sergei-nntu/ora/ora-7/Images/Assembled.jpg

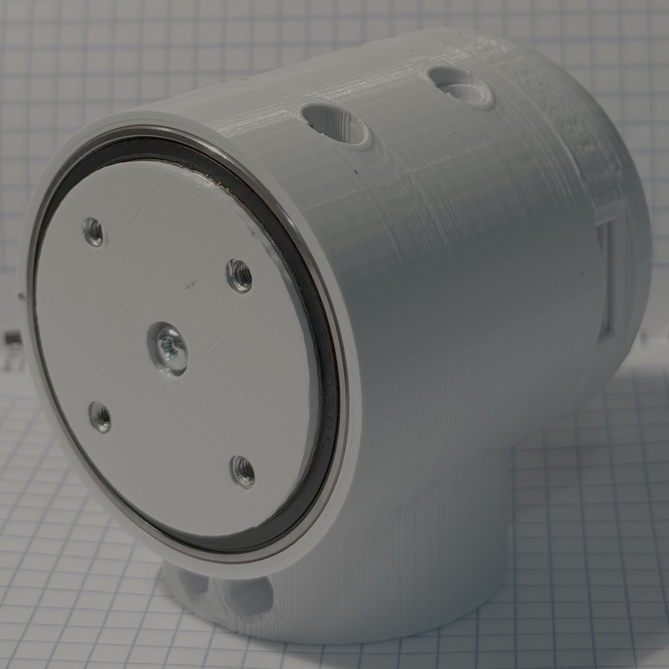
ora-7/Images/Assembled.jpg
