sergei-nntu/ora/ora-8/images/ORA-8 Image Clean.png

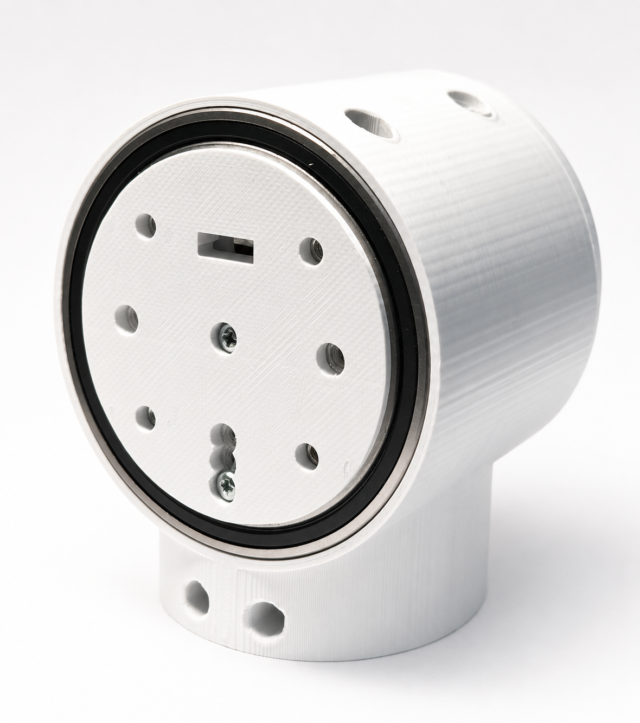
ora-8/images/ORA-8 Image Clean.png
