sergei-nntu/ora/ora-3/ORA-3.png

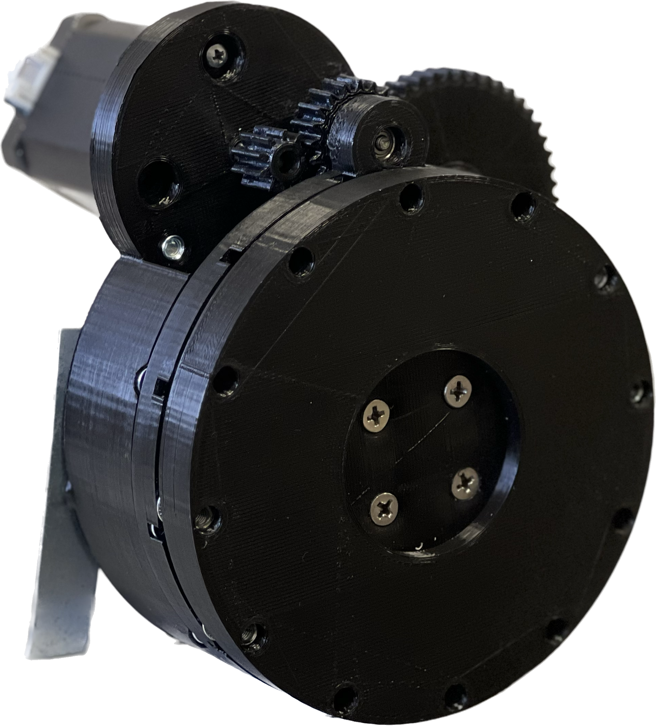
ora-3/ORA-3.png
