sergei-nntu/ora/ora-8/schematics/ORA-8_bb.png

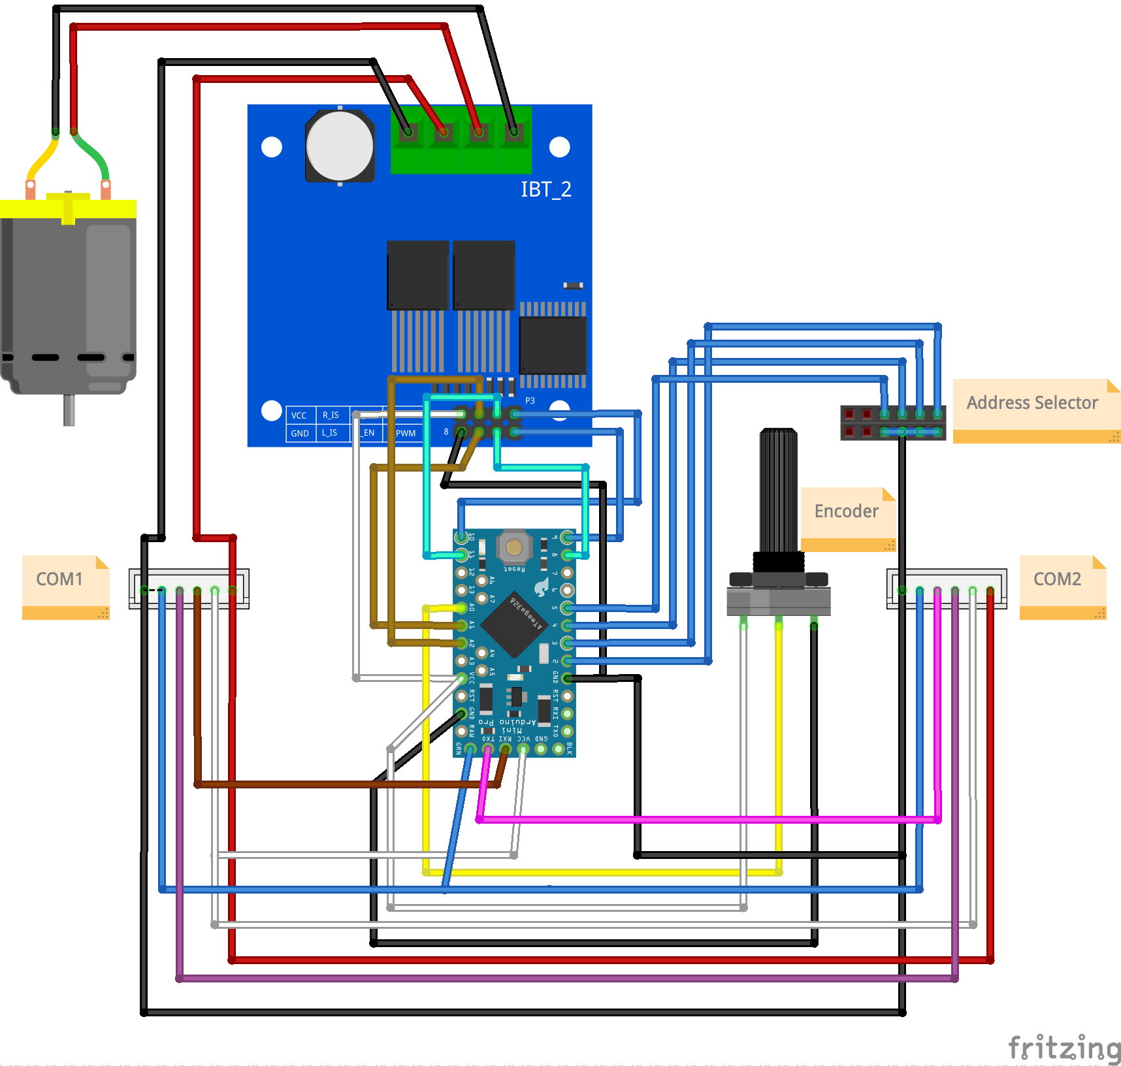
ora-8/schematics/ORA-8_bb.png
