sergei-nntu/ora/ora-10/ora-10_JST.FCStd

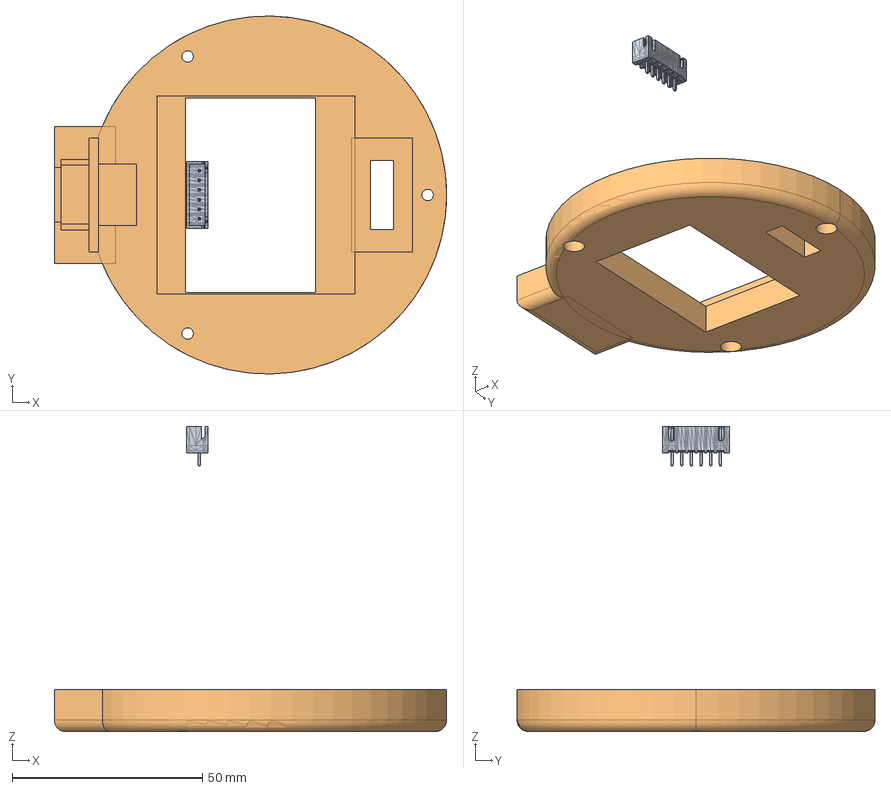
[picture p5: CAD file, 2026-02-09]
ora-10/ora-10_JST.FCStd
103.0 x 94.0 x 80.1 mm
JST XH 6_rot
ORA-8 Lid With BT7960
