sergei-nntu/ora/ora-2/ora-2.FCStd

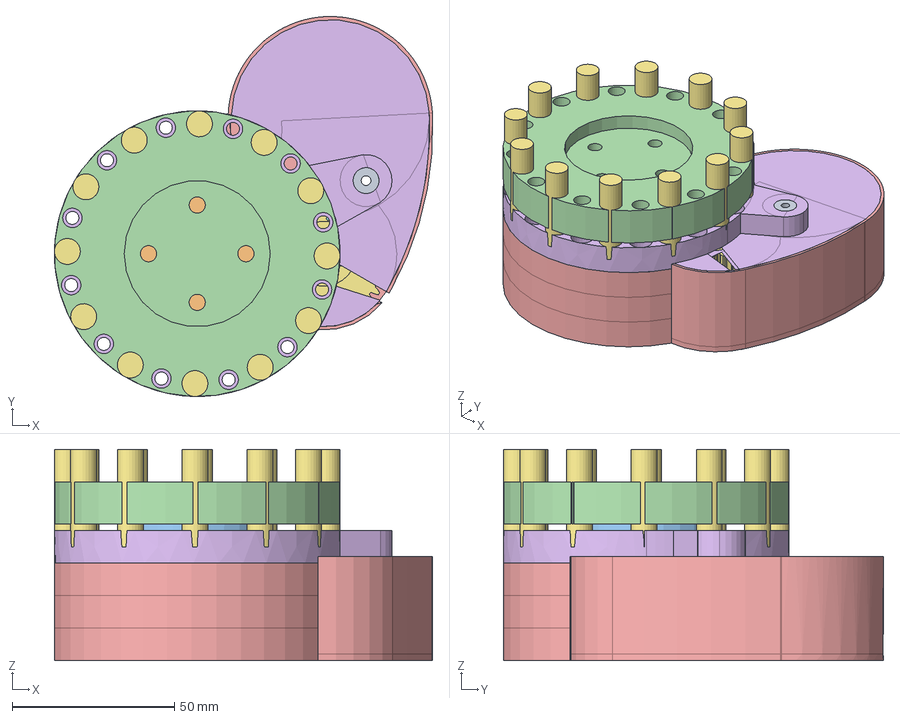
[picture p6: CAD file, 2026-08-20]
ora-2/ora-2.FCStd
116.5 x 117.0 x 65.0 mm
Bearing MR83ZZ 1:2 GEAR TOP
SmallGear Anti Tension
Bearing MR83ZZ MediumGearBottom
Bearing MR83ZZ MediumGearTop
Bearing 6002
Bearing 6809
MediumGear
ORA-2 32:12 GEAR
Bearing MR83ZZ 1:2 GEAR BOTTOM
MainGear Anti-Backlash
MainShaft Anti-Backlash
Flange_Antibacklash
ORA-2 Body. With Gears Protection
ORA-2 Cover. With Gears Protection
ORA-2 COVER MNT HOLES001
