sergei-nntu/ora/ora-3/ora-3ST.FCStd

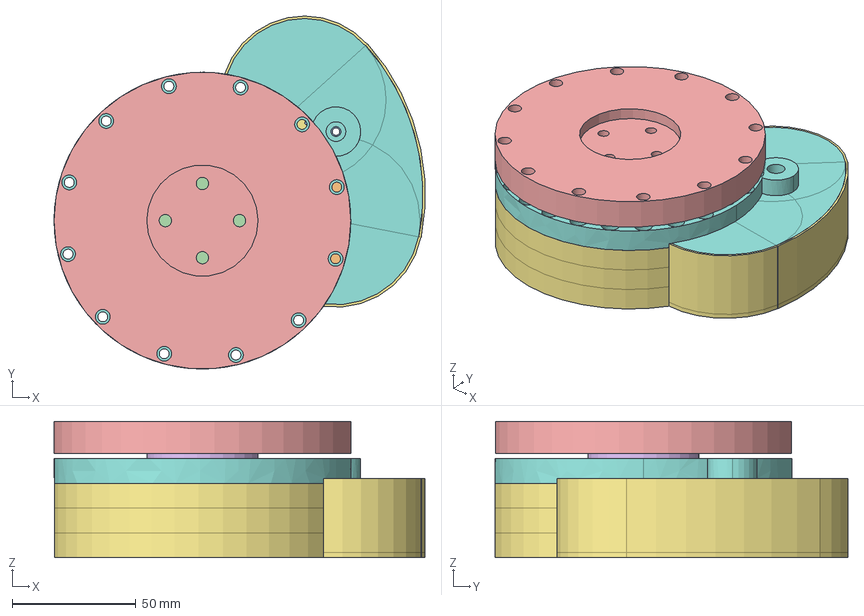
[picture p7: CAD file, 2026-08-20]
ora-3/ora-3ST.FCStd
150.0 x 142.7 x 55.0 mm
SmallGear Anti Tension
MediumGear
MediumGear_Small002
MainGear_AntiBaclkash
Flange AntiBacklash
MainShaft_AntiBacklash
ORA-3 Body. With Gears Protection
ORA-3 Cover. With Gears Protection
