sergei-nntu/ora/ora-6/ora-3ST.FCStd

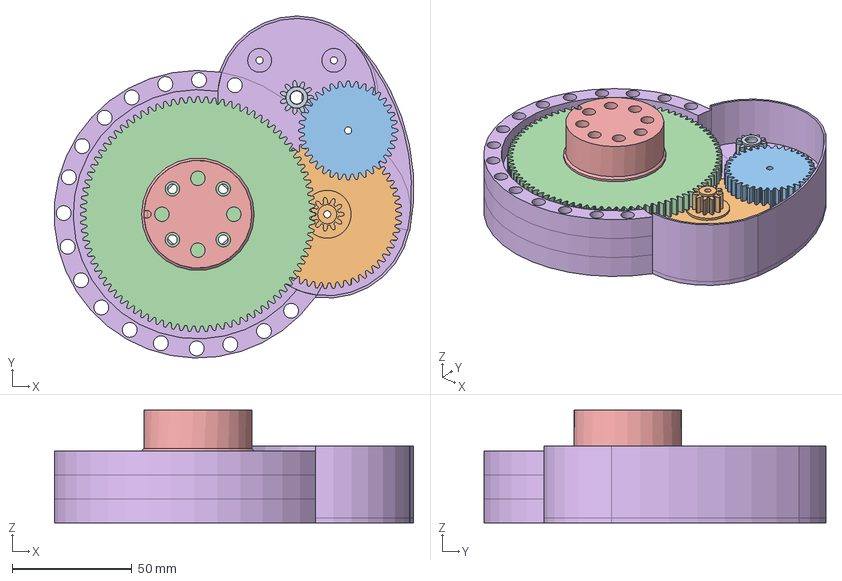
[picture p9: CAD file, 2026-01-14]
ora-6/ora-3ST.FCStd
149.8 x 142.7 x 47.0 mm
SmallGear Anti Tension
MediumGear
MediumGear_Small002
MainGear_AntiBaclkash
MainShaft_AntiBacklash
ORA-6 Body. With Gears Protection
