sergei-nntu/ora/ora-7/14_5_4.3mf

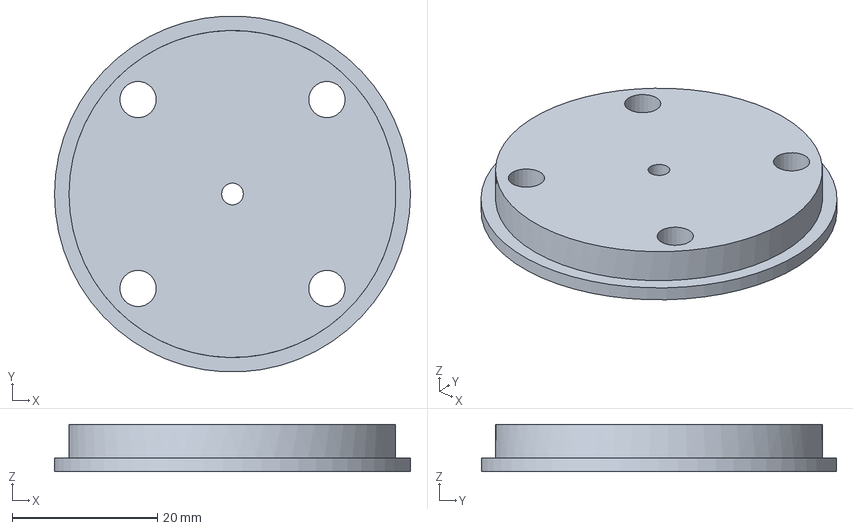
[picture p10: CAD file, 2026-08-20]
ora-7/14_5_4.3mf
49.0 x 48.9 x 6.50 mm
