sergei-nntu/ora/ora-8/15_5_3.3mf

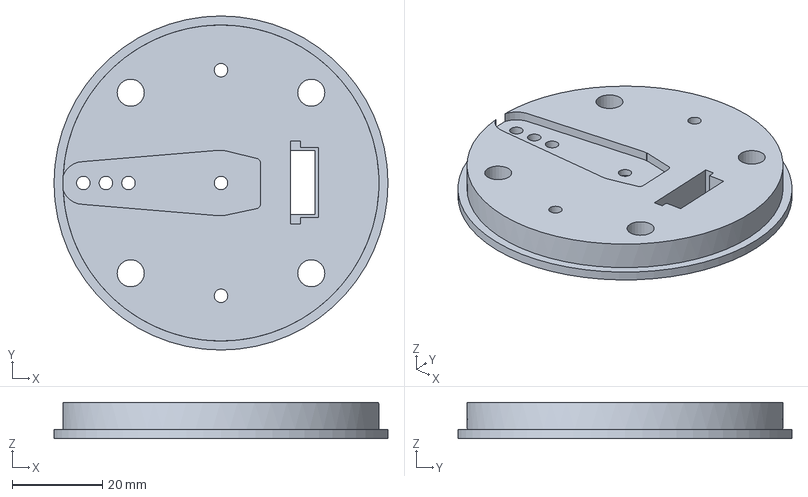
[picture p11: CAD file, 2026-08-20]
ora-8/15_5_3.3mf
74.0 x 74.0 x 8.00 mm
