sergei-nntu/ora/ora-9/17_4_1.stl

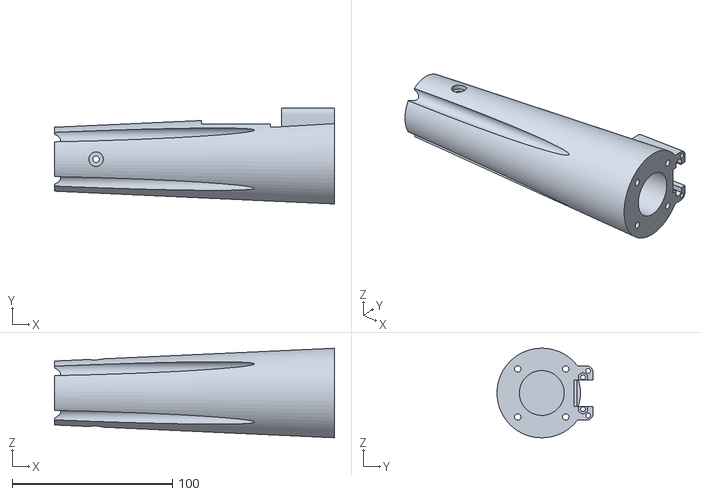
[picture p12: CAD file, 2026-01-14]
ora-9/17_4_1.stl
175.0 x 60.0 x 56.0
