sergei-nntu/ora/ora-2/10_2_2.stl

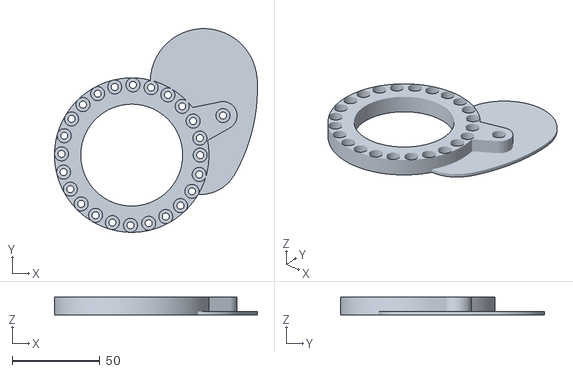
[picture p13: CAD file, 2026-01-14]
ora-2/10_2_2.stl
115.6 x 116.0 x 10.0
