sergei-nntu/ora/ora-3/8_4_4.stl

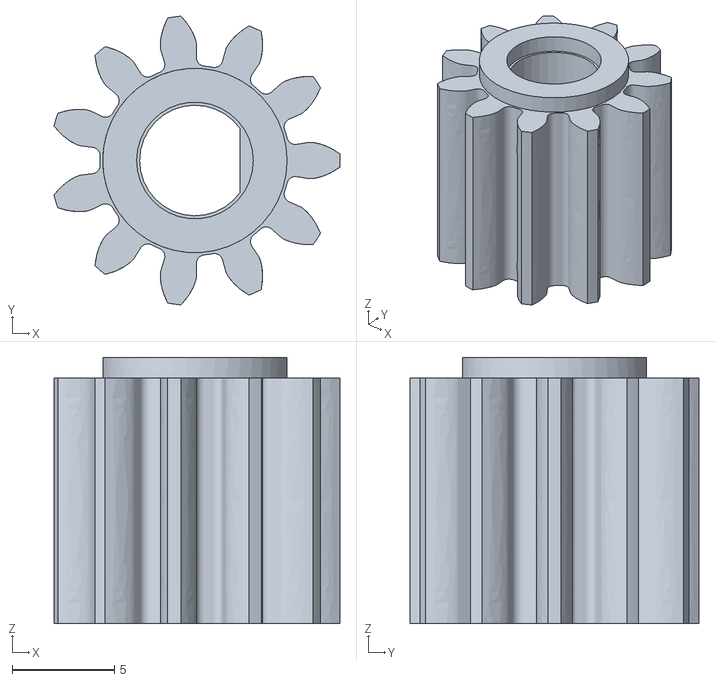
[picture p14: CAD file, 2026-01-14]
ora-3/8_4_4.stl
14.0 x 14.1 x 13.0
