sergei-nntu/ora/ora-4/12_5_1.stl

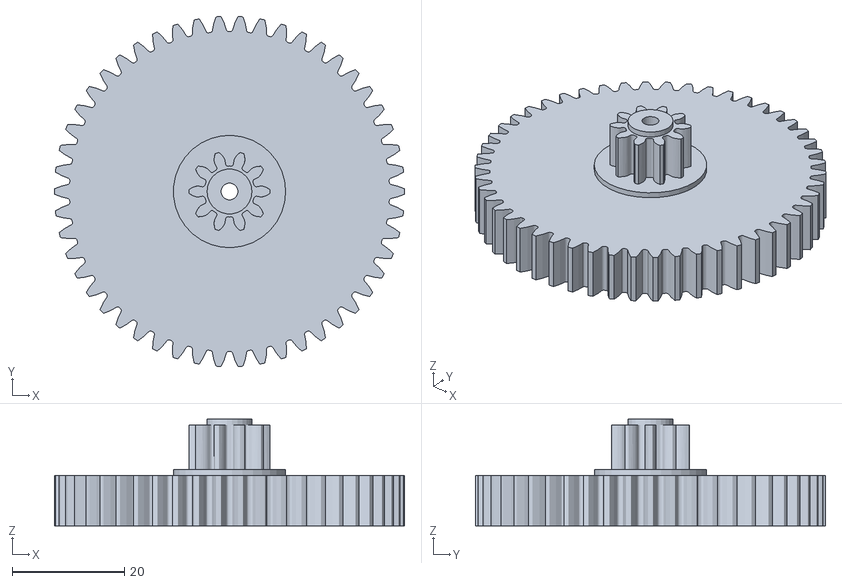
[picture p15: CAD file, 2026-01-14]
ora-4/12_5_1.stl
62.4 x 62.3 x 19.0
