sergei-nntu/ora/ora-7/14_4_11.3mf

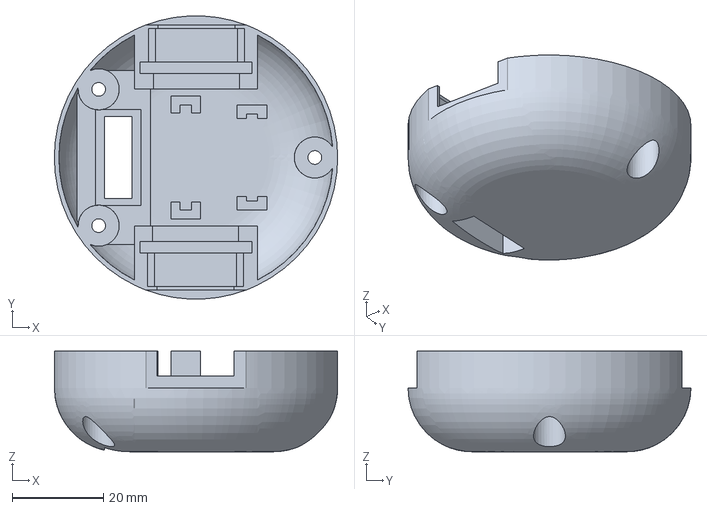
[picture p17: CAD file, 2026-08-20]
ora-7/14_4_11.3mf
62.0 x 61.9 x 22.0 mm
