sergei-nntu/ora/ora-8/15_1_9.3mf

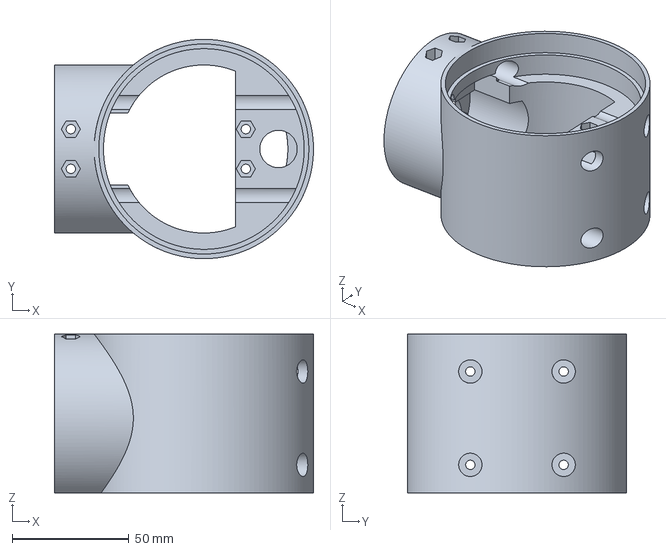
[picture p18: CAD file, 2026-08-20]
ora-8/15_1_9.3mf
111.0 x 94.0 x 68.0 mm
