sergei-nntu/ora/ora-9/17_1_6.stl

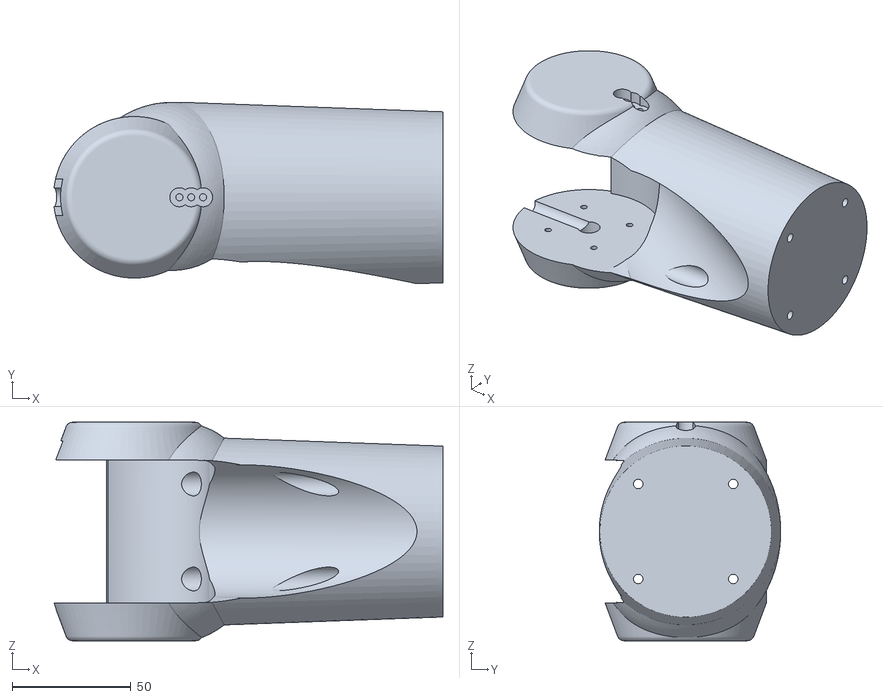
[picture p19: CAD file, 2026-01-14]
ora-9/17_1_6.stl
163.8 x 76.4 x 92.0
