sergei-nntu/ora/ora-2/10_1_3.stl

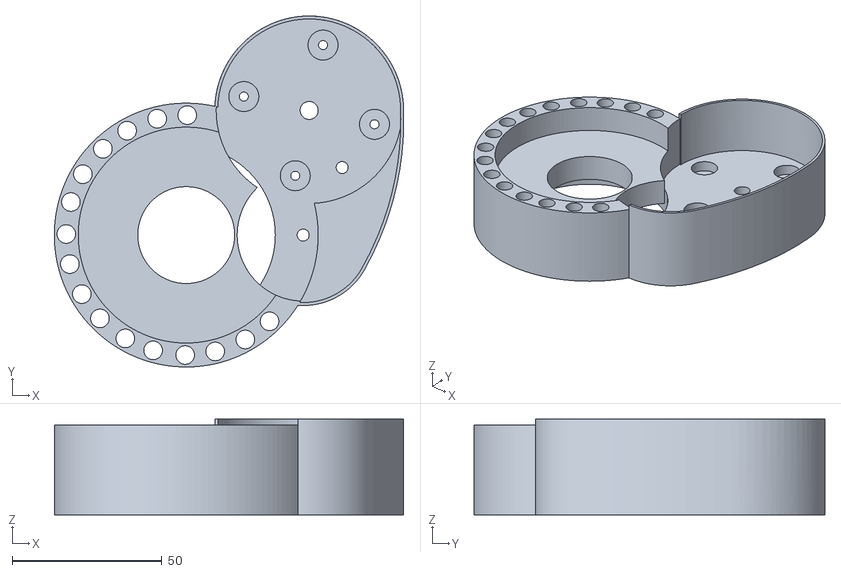
[picture p20: CAD file, 2026-01-14]
ora-2/10_1_3.stl
116.5 x 117.1 x 32.0
