sergei-nntu/ora/ora-3/8_10_1.stl

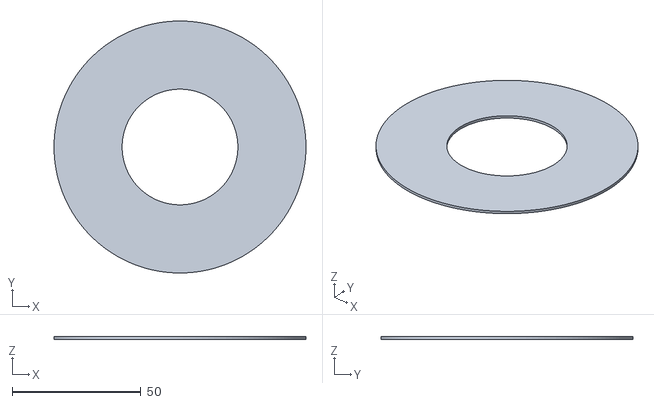
[picture p21: CAD file, 2026-01-14]
ora-3/8_10_1.stl
98.0 x 98.0 x 1.00
