sergei-nntu/ora/ora-4/ora-3ST.FCStd

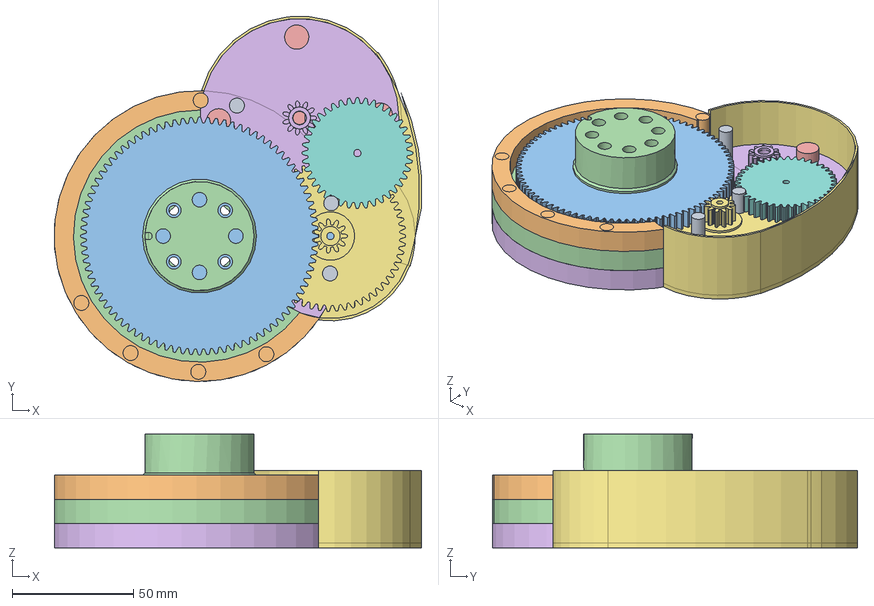
[picture p22: CAD file, 2026-01-14]
ora-4/ora-3ST.FCStd
151.6 x 150.6 x 47.0 mm
ORA-4 Mounting Holes
ORA-4 UpperBody
MiddleGearMountingHole
ORA-4 MiddleBody
MR83ZZ Mounting
SmallGear Anti Tension
MediumGear
MediumGear_Small002
ORA-4MR83ZZ Bearing Mount Small Gear
ORA-4 Body Extra Mounting Holes
MainGear_AntiBaclkash
MainShaft_AntiBacklash
Nema23 Mounting Place001
ORA-4 Lower Body
ORA-4 Gears Protection
