sergei-nntu/ora/ora-7/14_1_12.3mf

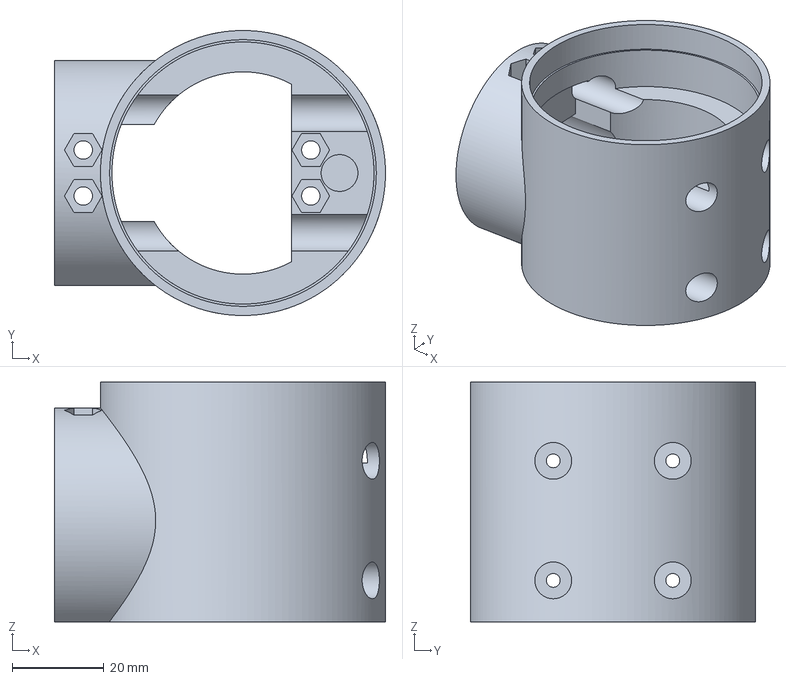
[picture p23: CAD file, 2026-08-20]
ora-7/14_1_12.3mf
72.0 x 62.0 x 52.1 mm
