sergei-nntu/ora/ora-8/15_6_3.3mf

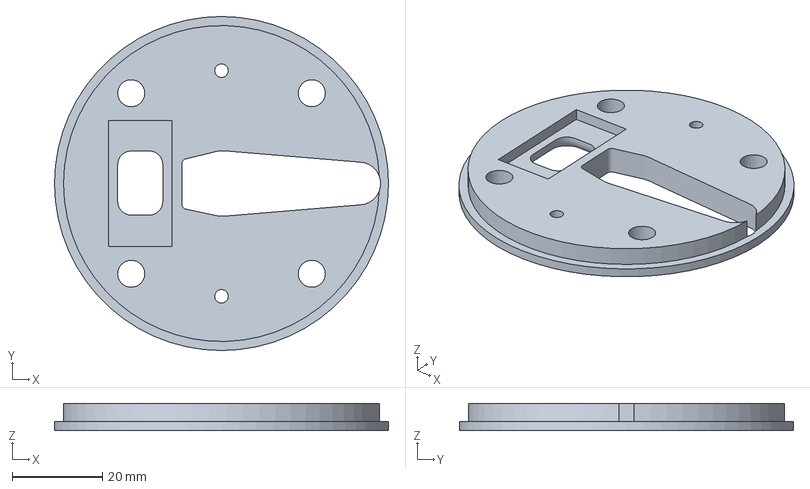
[picture p24: CAD file, 2026-08-20]
ora-8/15_6_3.3mf
74.0 x 74.0 x 6.00 mm
