sergei-nntu/ora/ora-9/17_5_1.stl

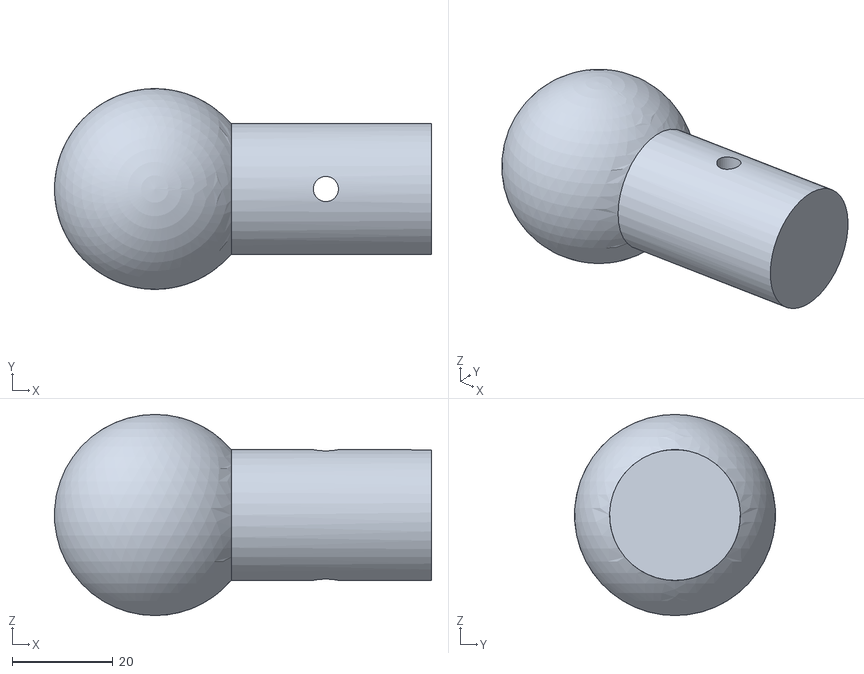
[picture p25: CAD file, 2026-01-14]
ora-9/17_5_1.stl
75.0 x 39.9 x 40.0
