sergei-nntu/ora/ora-2/10_8_2.stl

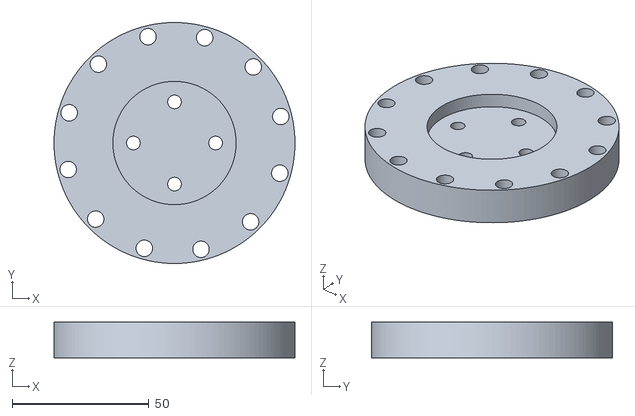
[picture p26: CAD file, 2026-01-14]
ora-2/10_8_2.stl
88.0 x 88.0 x 13.0
