sergei-nntu/ora/ora-4/12_6_2.stl

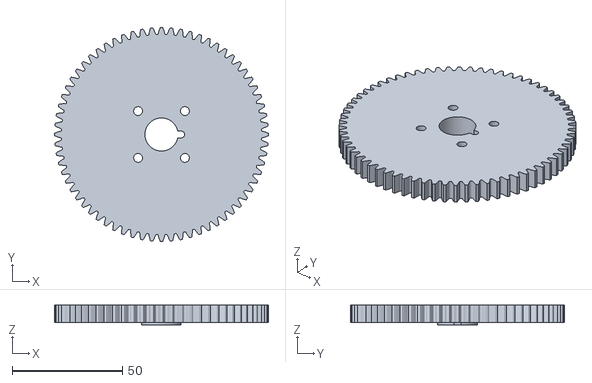
[picture p27: CAD file, 2026-01-14]
ora-4/12_6_2.stl
96.9 x 96.9 x 9.00
