sergei-nntu/ora/ora-7/14_9_1.3mf

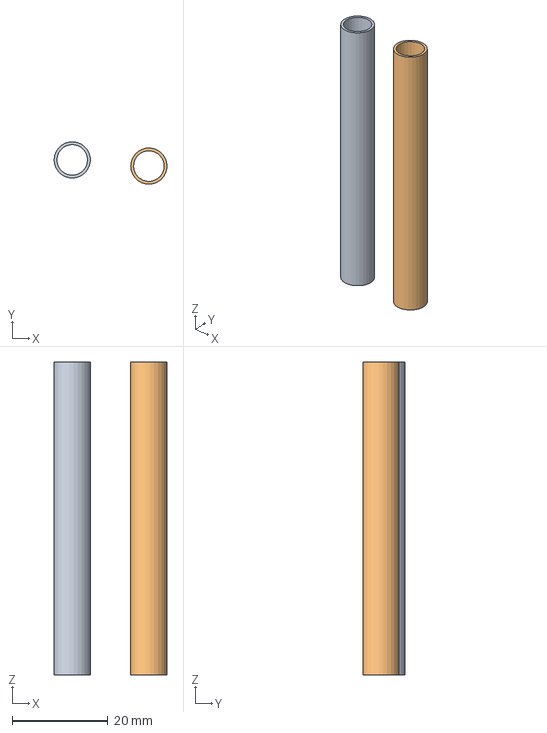
[picture p28: CAD file, 2026-08-20]
ora-7/14_9_1.3mf
23.6 x 8.88 x 65.5 mm
14_9_1.stl x 2
