sergei-nntu/ora/ora-8/15_7_1.3mf

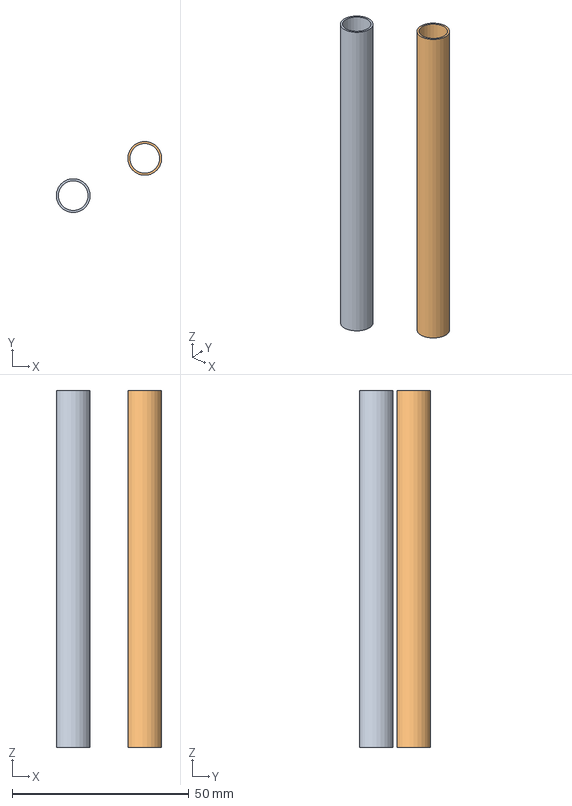
[picture p29: CAD file, 2026-08-20]
ora-8/15_7_1.3mf
29.8 x 20.1 x 101.0 mm
15_7_1.stl x 2
