sergei-nntu/ora/ora-9/ora-9 5.FCStd

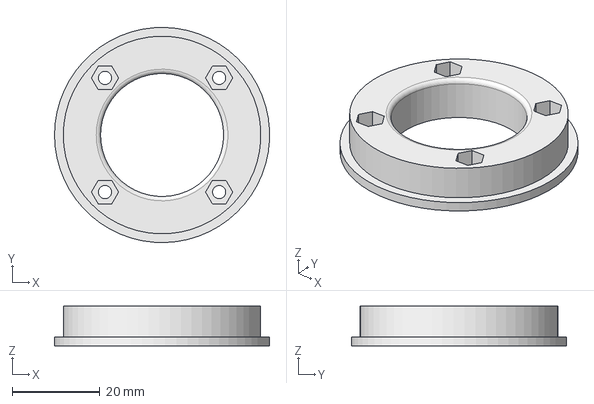
[picture p30: CAD file, 2026-01-14]
ora-9/ora-9 5.FCStd
49.0 x 49.0 x 9.00 mm
