sergei-nntu/ora/ora-2/10_7_2.stl

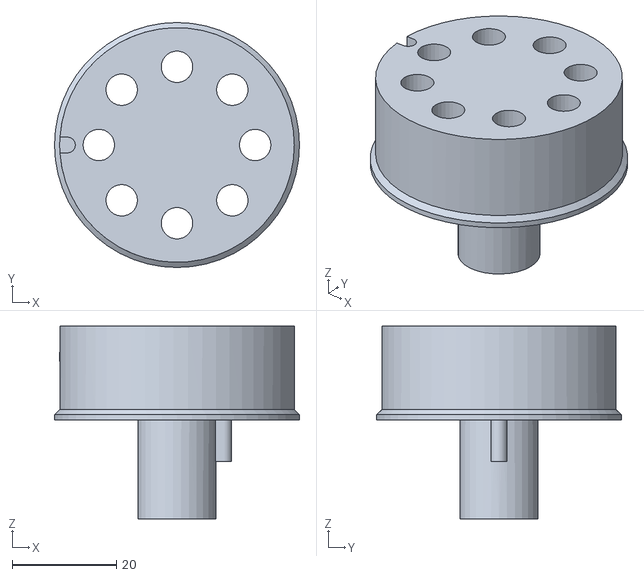
[picture p31: CAD file, 2026-01-14]
ora-2/10_7_2.stl
47.0 x 47.0 x 37.0
