sergei-nntu/ora/ora-4/12_4_1.stl

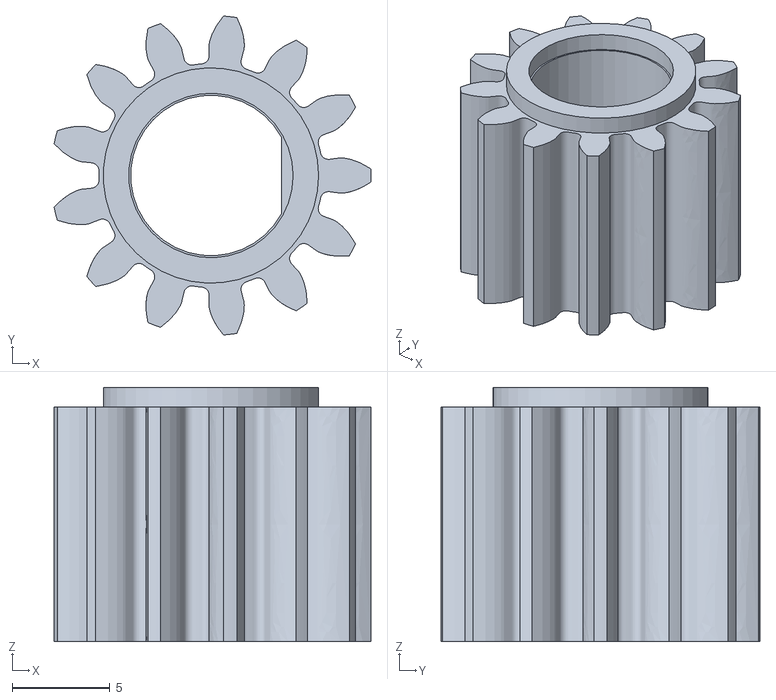
[picture p32: CAD file, 2026-01-14]
ora-4/12_4_1.stl
16.2 x 16.3 x 13.0
