sergei-nntu/ora/ora-7/14_6_5.3mf

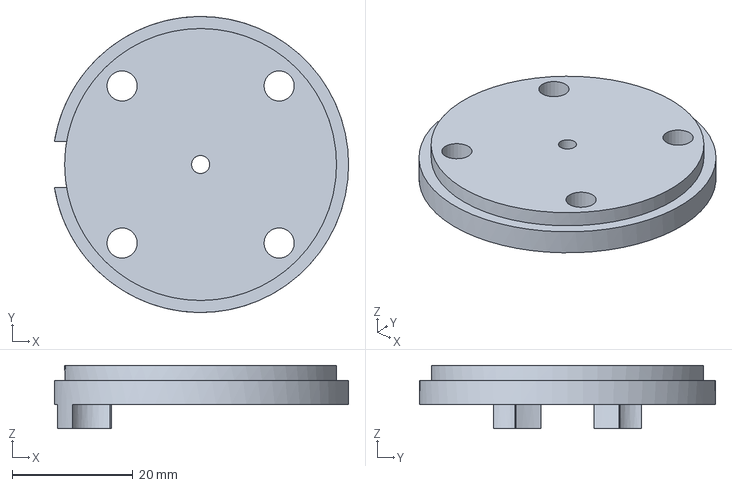
[picture p33: CAD file, 2026-08-20]
ora-7/14_6_5.3mf
48.7 x 49.0 x 10.5 mm
