sergei-nntu/ora/ora-8/15_3_6.3mf

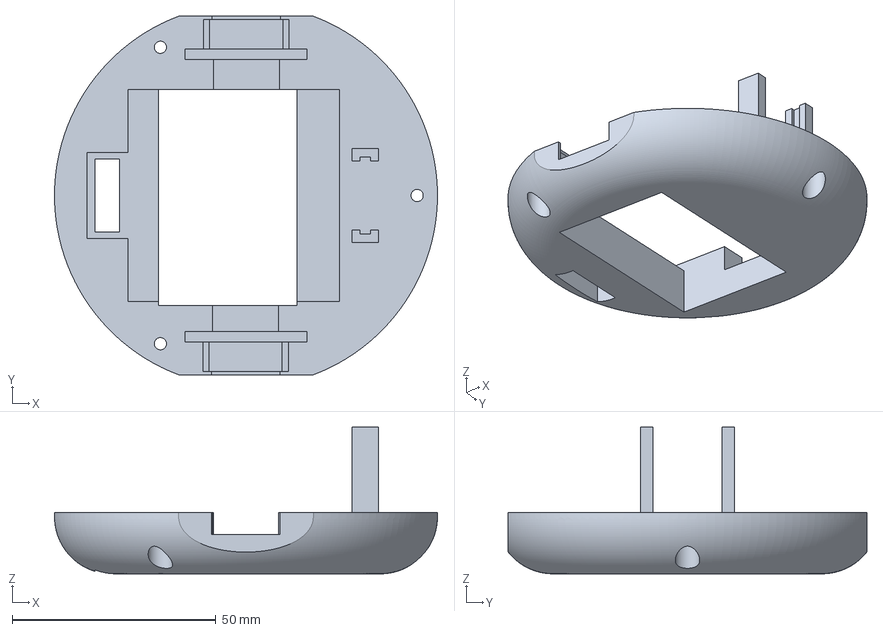
[picture p34: CAD file, 2026-08-20]
ora-8/15_3_6.3mf
94.0 x 88.0 x 36.0 mm
