sergei-nntu/ora/ora-9/ora-9 3.FCStd

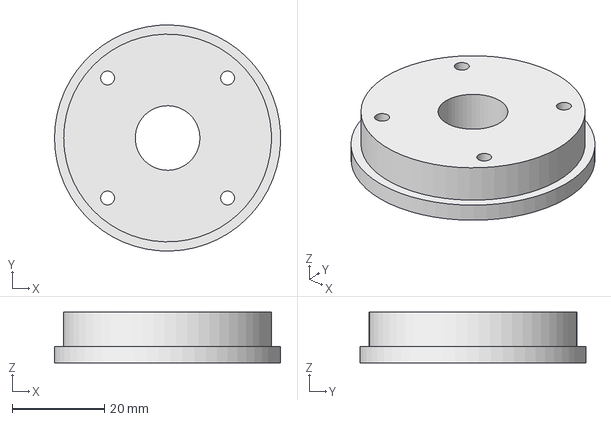
[picture p35: CAD file, 2026-01-14]
ora-9/ora-9 3.FCStd
49.0 x 49.0 x 11.0 mm
