sergei-nntu/ora/ora-2/ServoMount.stl

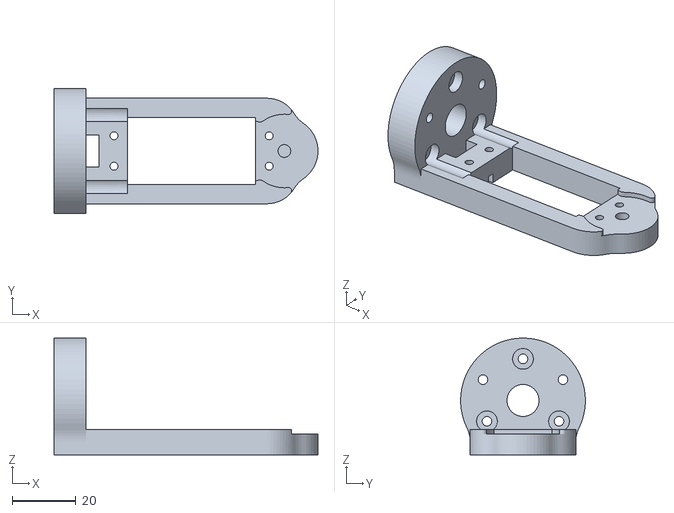
[picture p36: CAD file, 2026-01-14]
ora-2/ServoMount.stl
82.5 x 39.0 x 36.5
