sergei-nntu/ora/ora-3/8_6_5.stl

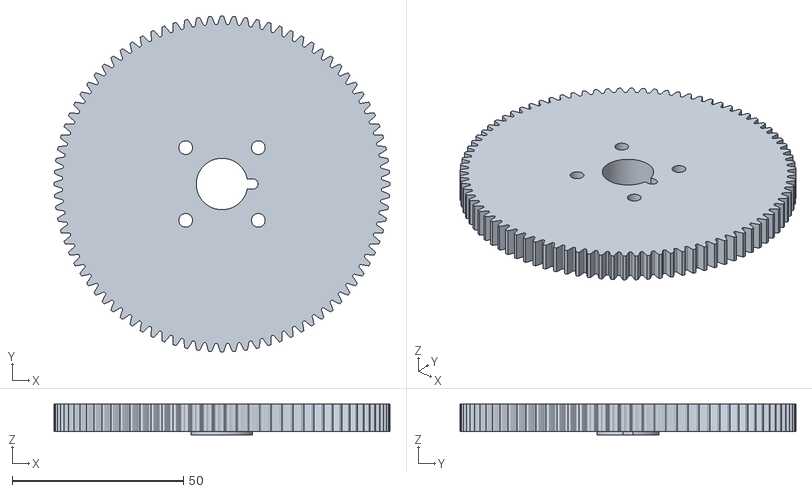
[picture p37: CAD file, 2026-01-14]
ora-3/8_6_5.stl
98.1 x 98.1 x 9.00
