sergei-nntu/ora/ora-4/12_1_1.stl

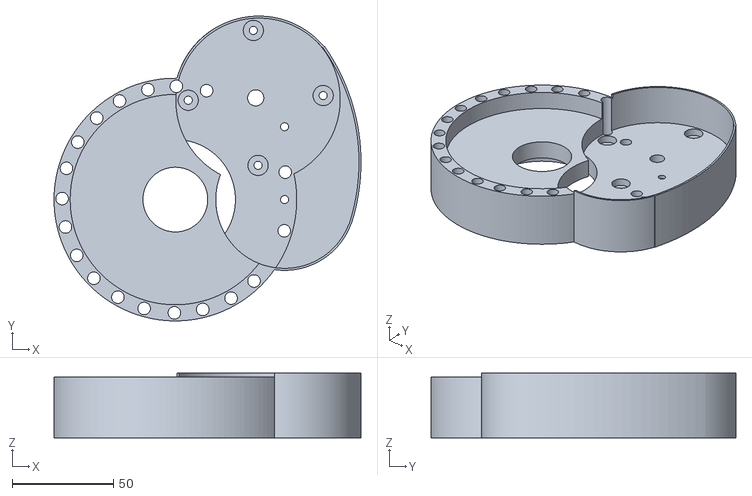
[picture p38: CAD file, 2026-01-14]
ora-4/12_1_1.stl
151.8 x 150.7 x 32.0
