sergei-nntu/ora/ora-7/ora-7.FCStd

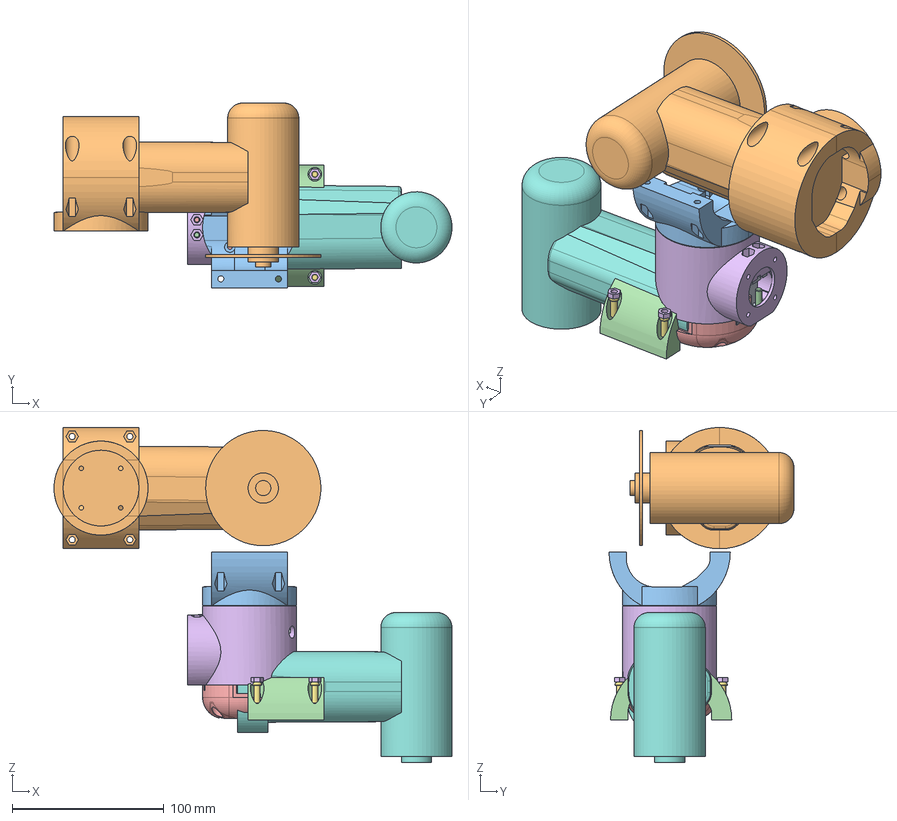
[picture p39: CAD file, 2026-08-20]
ora-7/ora-7.FCStd
262.5 x 122.0 x 221.0 mm
DS3240
Bearing 6809
ORA-7 Shaft Upper001
ORA-7 Shaft Lower With Stopper
ORA-7 Lid With Ardu and DRV8833 Holder
ORA-7 Body With JST PCB Cut
25T Arm
M4 Nut
M4 Nut001
M4 Nut002
M4 Nut003
M4 Screw
M4 Screw001
M4 Screw002
M4 Screw003
M3x8 Screw
Threaded Rivets
WeaponWithHolder
WeaponHolderBase. Two-Sided001
WeaponHolderCover. Two-Sided001
M3 Screws For Weapon Mounting
M4 Nuts WeaponHolder
M4 Screw WeaponHolder
WeaponBody
