sergei-nntu/ora/ora-8/ora-8_JST.FCStd

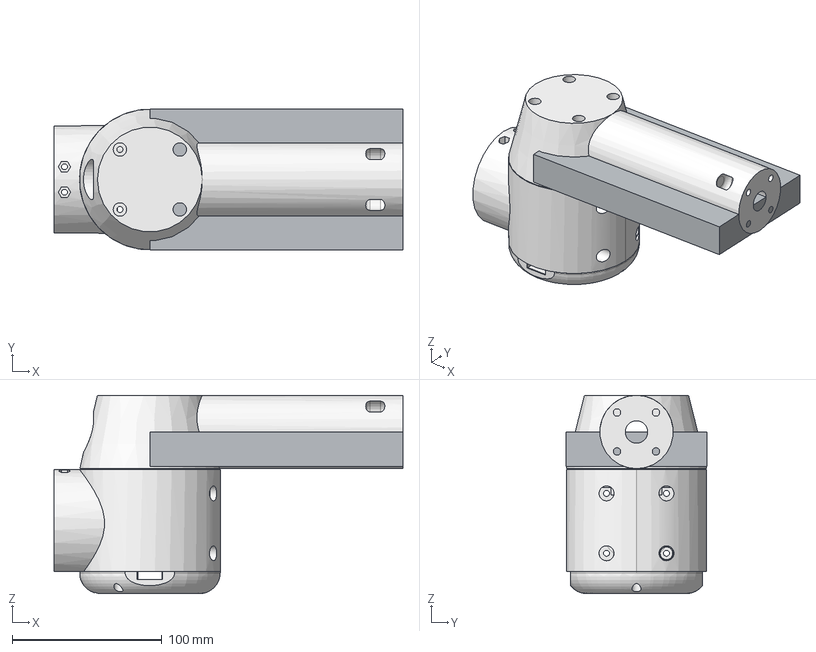
[picture p40: CAD file, 2026-08-20]
ora-8/ora-8_JST.FCStd
233.0 x 94.0 x 132.5 mm
Bearing 6814
JST XH 6_rot
ORA-8 Shaft Upper Half JST
ORA-8 Body With Shaft Stopper
ORA-8 Shaft Lower With Stopper
ORA-8 Lid With Arduino Pro Mini Holder
ORA-8 Wires Protection Tube
ORM PT4 Forearm With DC Transformer Space
