sergei-nntu/ora/ora-9/17_1_1.stl

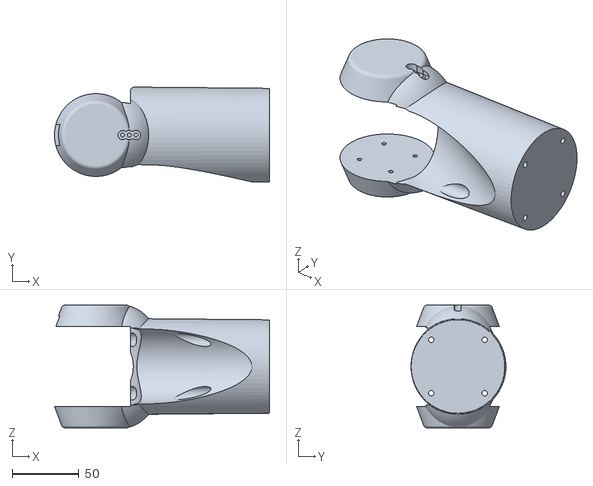
[picture p41: CAD file, 2026-01-14]
ora-9/17_1_1.stl
161.0 x 71.0 x 92.0
