sergei-nntu/ora/ora-2/10_6_2.stl

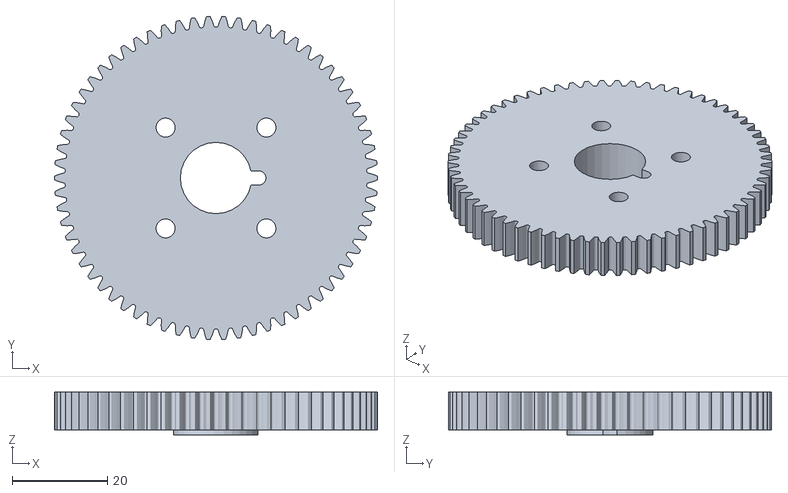
[picture p42: CAD file, 2026-01-14]
ora-2/10_6_2.stl
68.0 x 68.0 x 9.00
