sergei-nntu/ora/ora-3/8_1_3.stl

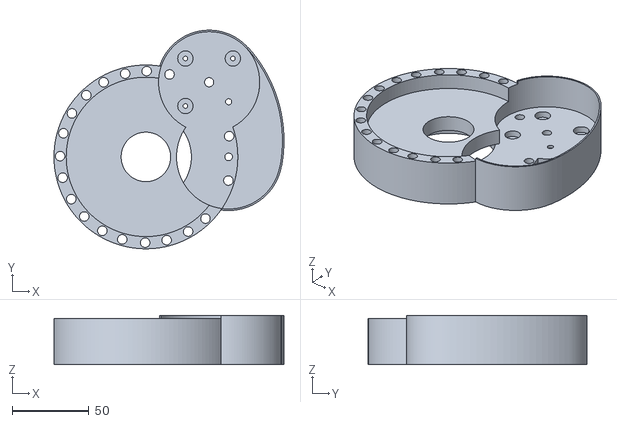
[picture p43: CAD file, 2026-01-14]
ora-3/8_1_3.stl
150.1 x 142.7 x 32.0
