sergei-nntu/ora/ora-4/12_4_2.stl

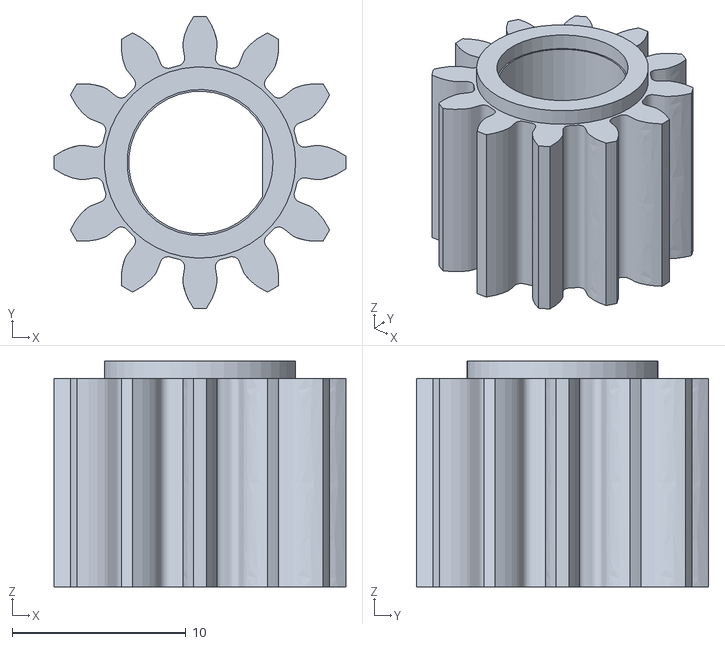
[picture p44: CAD file, 2026-01-14]
ora-4/12_4_2.stl
16.8 x 16.8 x 13.0
