sergei-nntu/ora/ora-8/15_3_4.stl

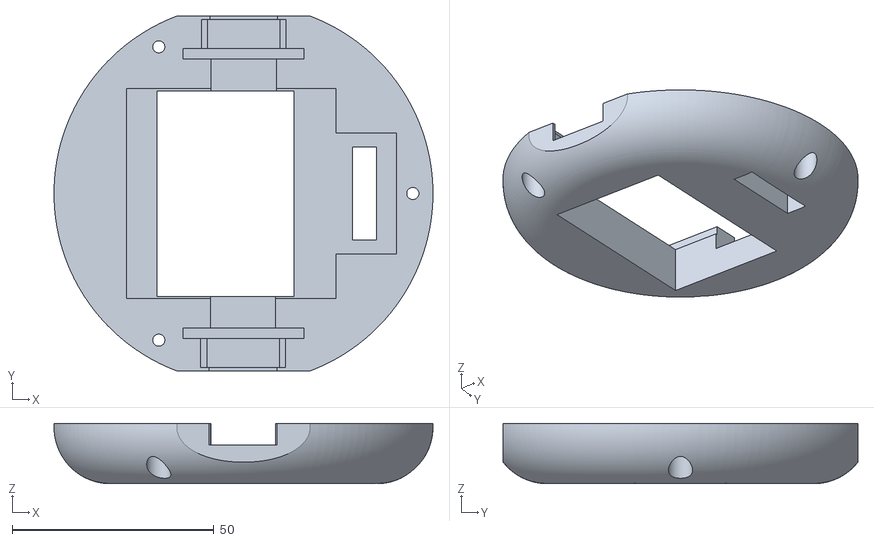
[picture p46: CAD file, 2026-04-22]
ora-8/15_3_4.stl
94.0 x 88.0 x 15.0
