sergei-nntu/ora/ora-9/17_1_4.stl

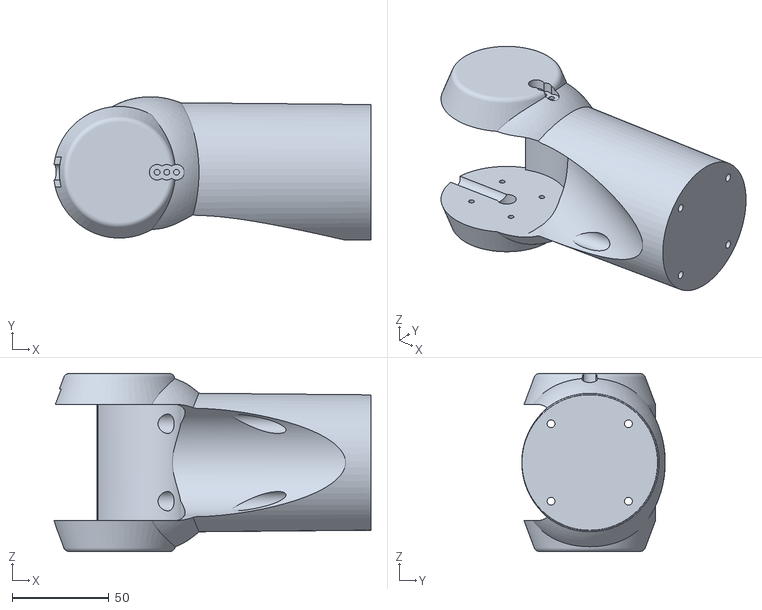
[picture p47: CAD file, 2026-01-14]
ora-9/17_1_4.stl
163.8 x 74.1 x 92.0
