sergei-nntu/ora/ora-3/8_8_2.stl

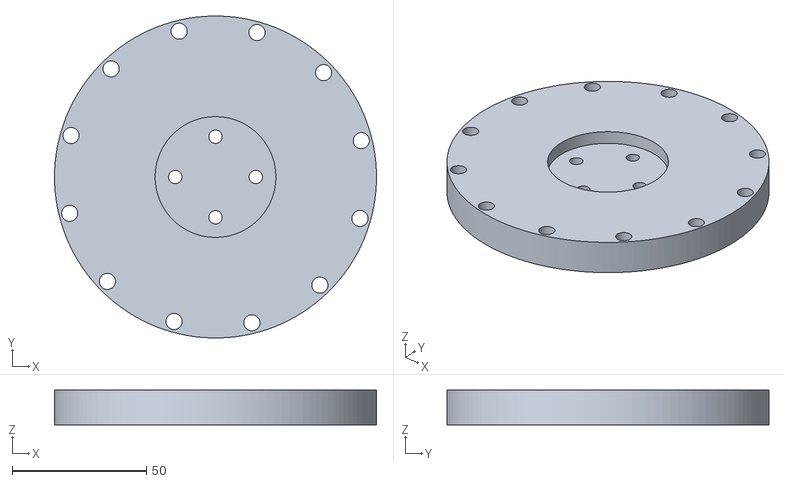
[picture p48: CAD file, 2026-01-14]
ora-3/8_8_2.stl
120.0 x 120.0 x 13.0
