sergei-nntu/ora/ora-4/12_3_1.stl

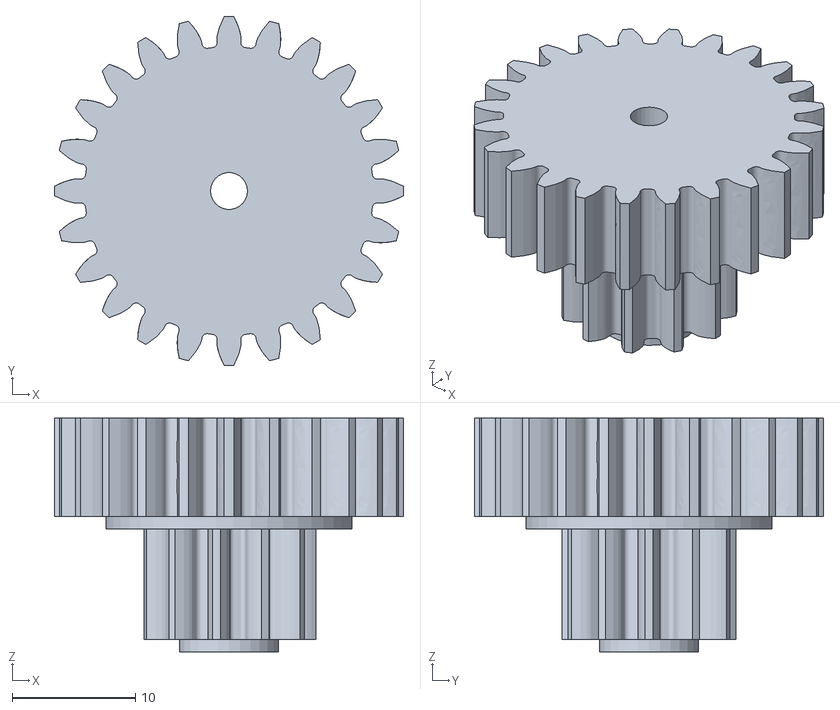
[picture p49: CAD file, 2026-01-14]
ora-4/12_3_1.stl
28.3 x 28.3 x 19.0
