sergei-nntu/ora/ora-7/14_4_9.stl

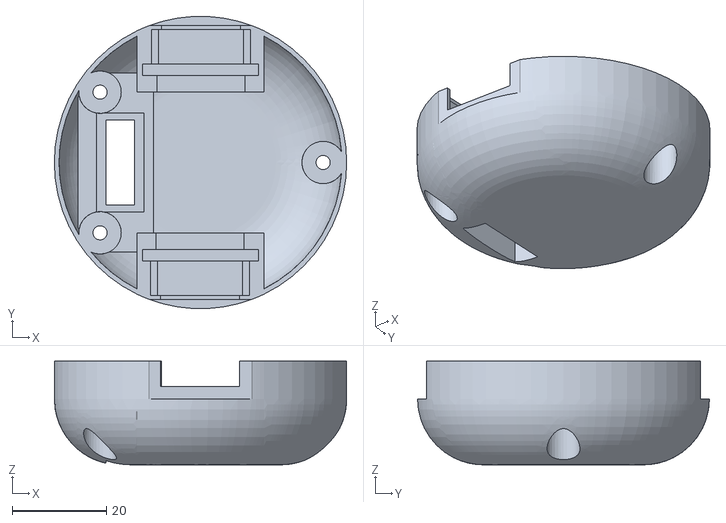
[picture p50: CAD file, 2026-04-22]
ora-7/14_4_9.stl
62.0 x 61.9 x 22.0
