sergei-nntu/ora/ora-8/BT7960B.stl

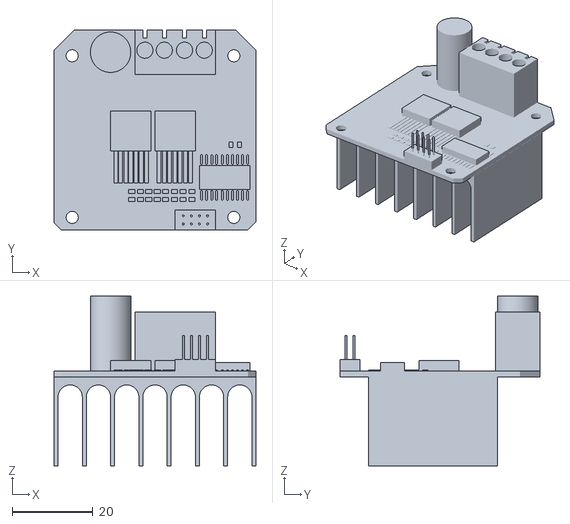
[picture p51: CAD file, 2026-02-09]
ora-8/BT7960B.stl
50.0 x 49.5 x 42.0
