sergei-nntu/ora/ora-3/8_2_4.stl

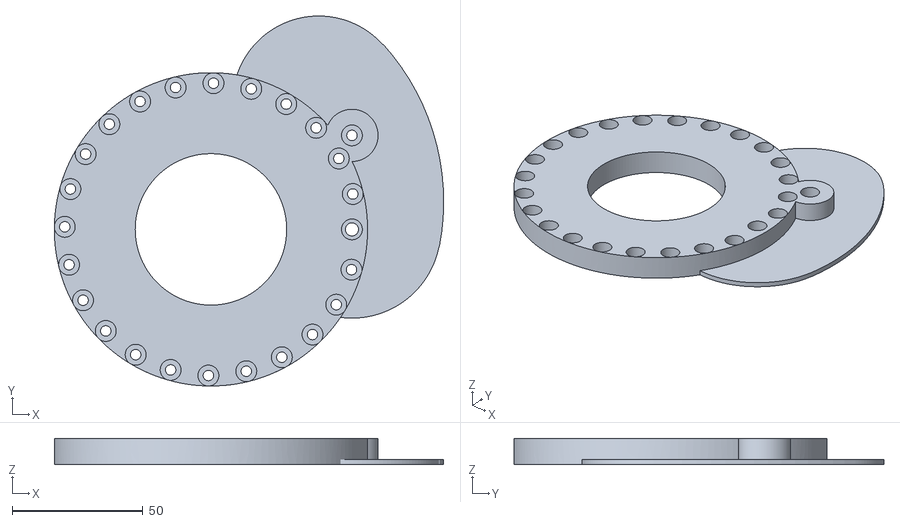
[picture p52: CAD file, 2026-01-14]
ora-3/8_2_4.stl
149.1 x 141.7 x 10.0
