sergei-nntu/ora/ora-4/12_3_2.stl

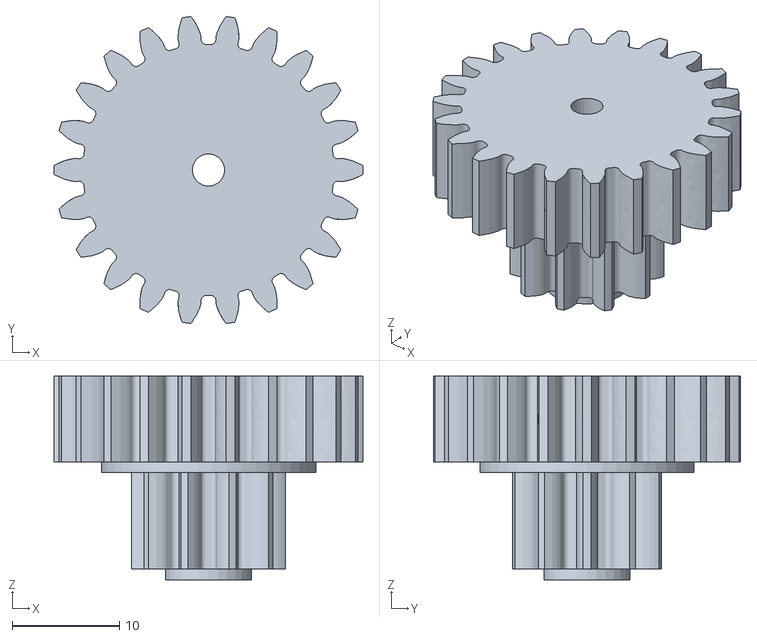
[picture p53: CAD file, 2026-01-14]
ora-4/12_3_2.stl
28.8 x 28.6 x 19.0
