sergei-nntu/ora/ora-7/14_8_1.stl

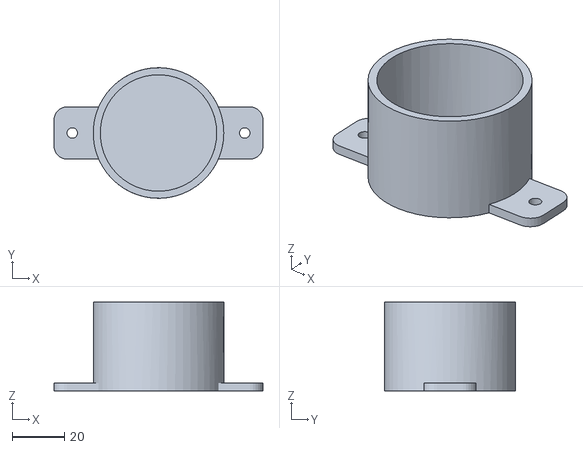
[picture p54: CAD file, 2026-04-22]
ora-7/14_8_1.stl
80.0 x 50.0 x 34.0
