sergei-nntu/ora/ora-8/connector-JST_B2to8B-XH-A.stl

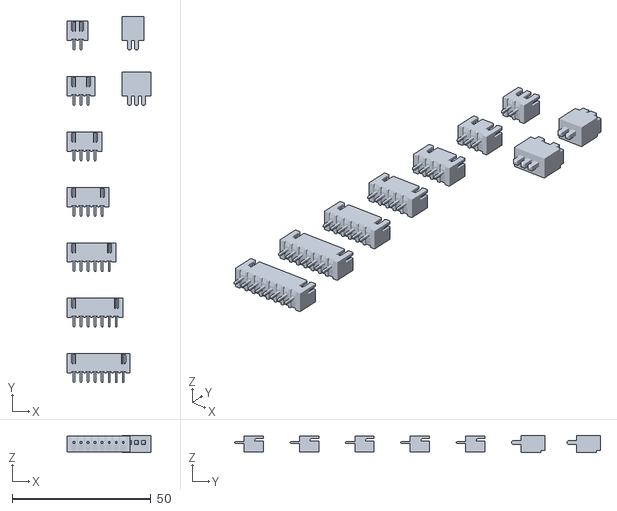
[picture p55: CAD file, 2026-01-21]
ora-8/connector-JST_B2to8B-XH-A.stl
30.2 x 132.1 x 6.15
