sergei-nntu/ora/ora-3/8_3_4.stl

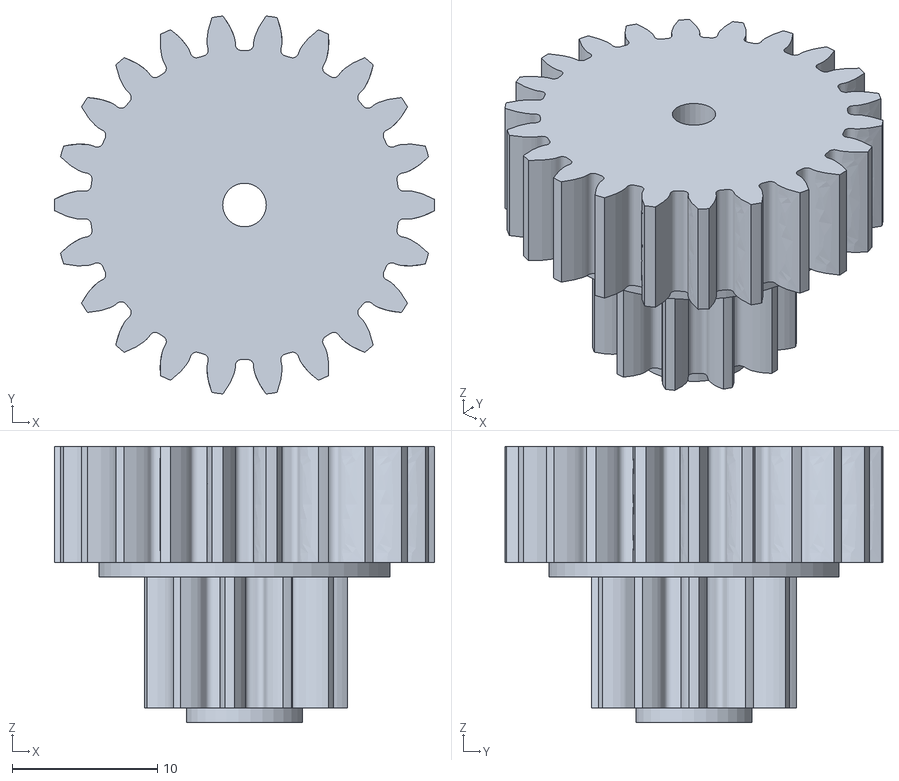
[picture p56: CAD file, 2026-01-14]
ora-3/8_3_4.stl
26.2 x 26.0 x 19.0
