sergei-nntu/ora/ora-4/ora-3ST 2.FCStd

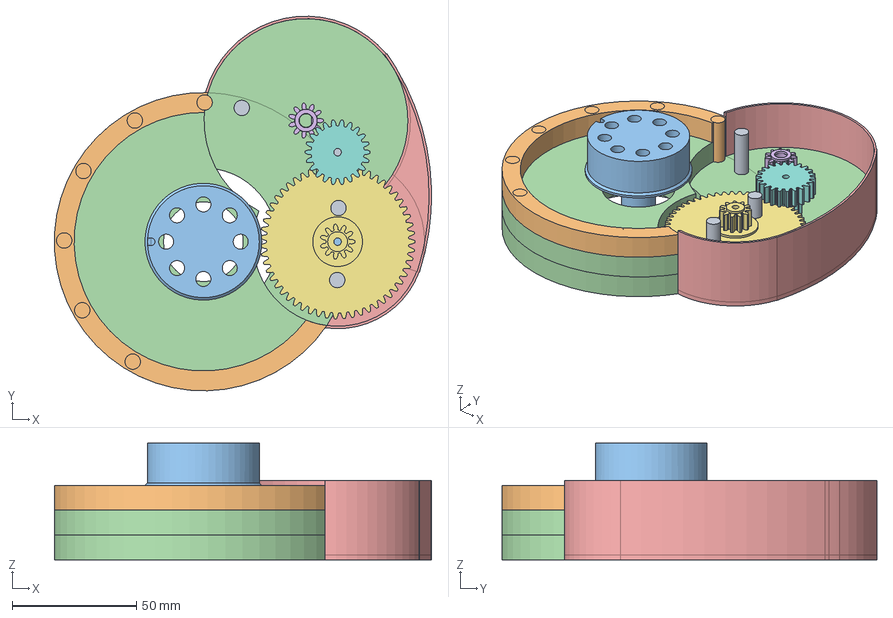
[picture p57: CAD file, 2026-01-14]
ora-4/ora-3ST 2.FCStd
151.7 x 150.7 x 47.0 mm
ORA-4 Mounting Holes
ORA-4 UpperBody
MiddleGearMountingHole
ORA-4 MiddleBody
MR83ZZ Mounting
SmallGear Anti Tension
MediumGear
MediumGear_Small002
ORA-4MR83ZZ Bearing Mount Small Gear
ORA-4 Body Extra Mounting Holes
MainShaft_AntiBacklash
ORA-4 Lower Body
ORA-4 Gears Protection
