sergei-nntu/ora/ora-8/ora-8.FCStd

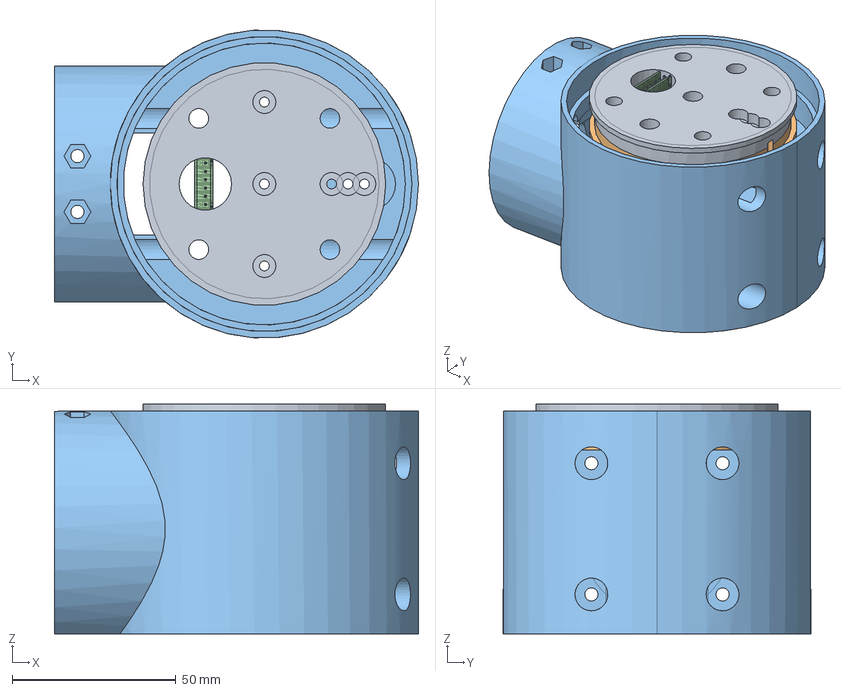
[picture p58: CAD file, 2026-01-21]
ora-8/ora-8.FCStd
111.0 x 93.8 x 70.0 mm
ORA-8 Shaft Upper Half
ORA-8 Shaft Lower Half
ORA-8 Even More Space for Wires
JST XH 6_rot
