sergei-nntu/ora/ora-9/ora-9 2.FCStd

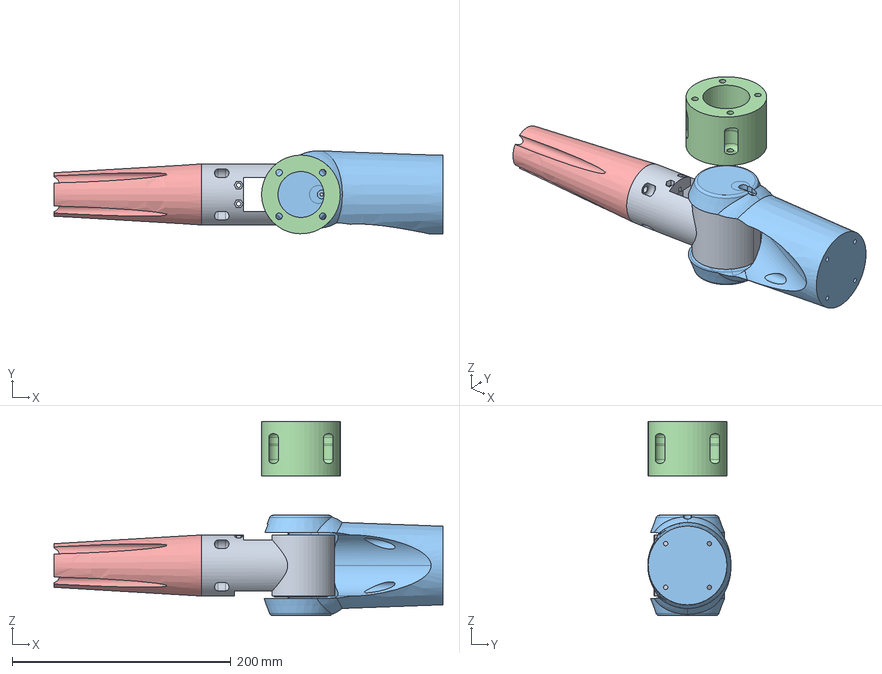
[picture p59: CAD file, 2026-01-14]
ora-9/ora-9 2.FCStd
356.0 x 76.4 x 178.0 mm
OQP-1 Lower Knee
OQP-1 Knee Shaft_
OQP Upper Knee Enforced
OQP-1 Upper Arm Short
OQP-1 Forearm
