sergei-nntu/ora/ora-3/ora-3ST 2.FCStd

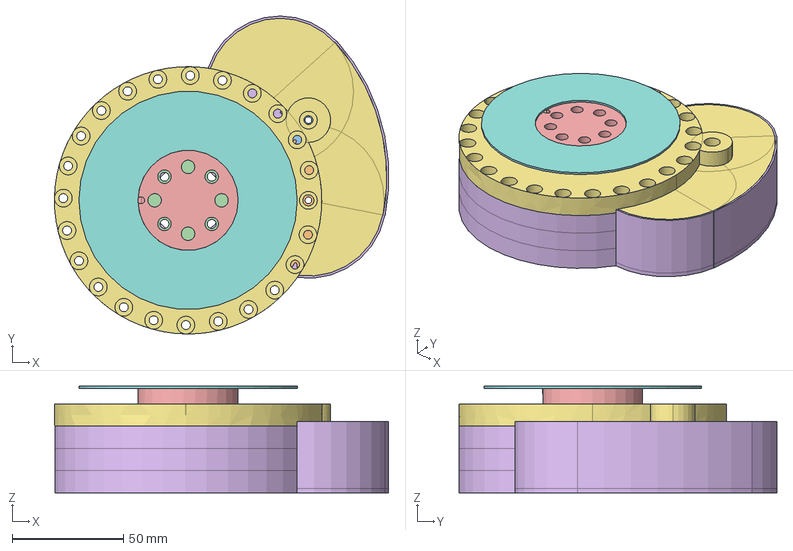
[picture p60: CAD file, 2026-01-14]
ora-3/ora-3ST 2.FCStd
150.0 x 142.7 x 48.0 mm
SmallGear Anti Tension
MediumGear
MediumGear_Small002
MainGear_AntiBaclkash
MainShaft_AntiBacklash
ORA-3 Body. With Gears Protection
ORA-3 Cover. With Gears Protection
felt_ring
