sergei-nntu/ora/ora-4/12_2_1.stl

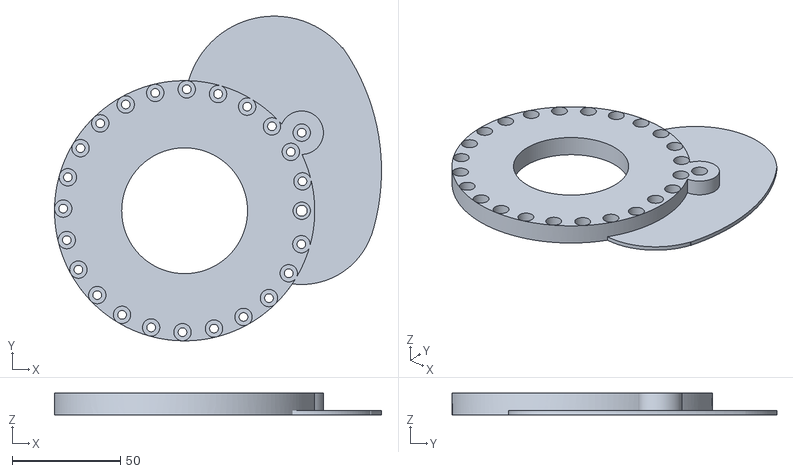
[picture p61: CAD file, 2026-01-14]
ora-4/12_2_1.stl
150.8 x 149.7 x 10.0
