sergei-nntu/ora/ora-7/14_7_1.stl

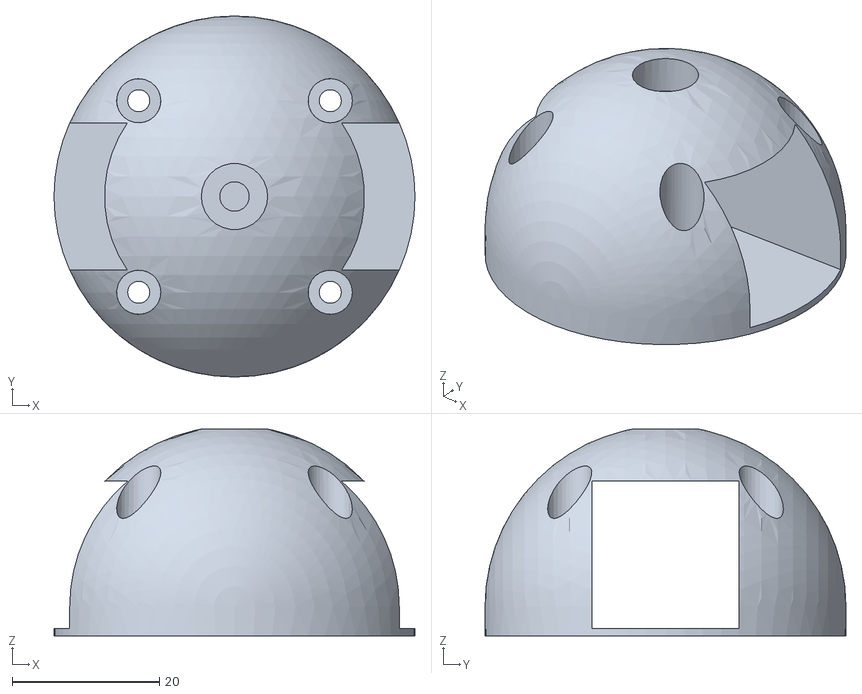
[picture p62: CAD file, 2026-02-20]
ora-7/14_7_1.stl
49.0 x 49.0 x 28.1
