sergei-nntu/ora/ora-8/JST-XHP-6S-tuned.stl

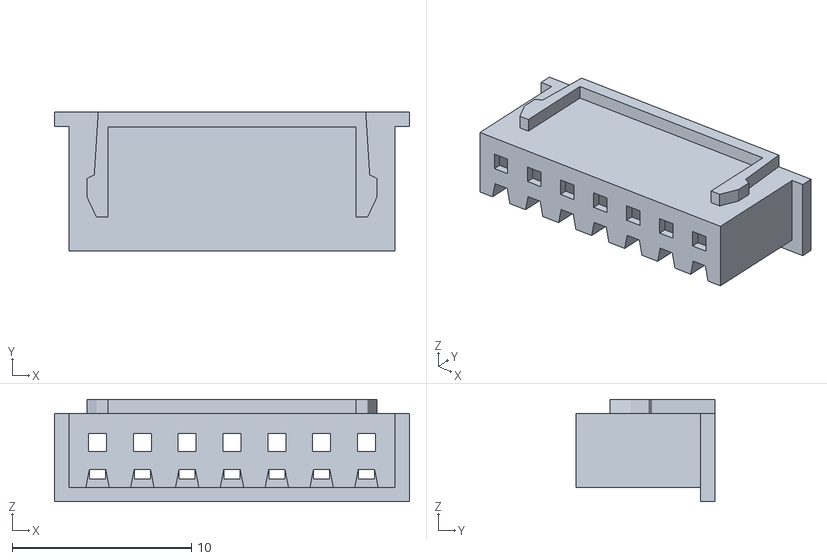
[picture p63: CAD file, 2026-01-21]
ora-8/JST-XHP-6S-tuned.stl
19.8 x 7.75 x 5.70
