sergei-nntu/ora/ora-8/15_3_3.stl

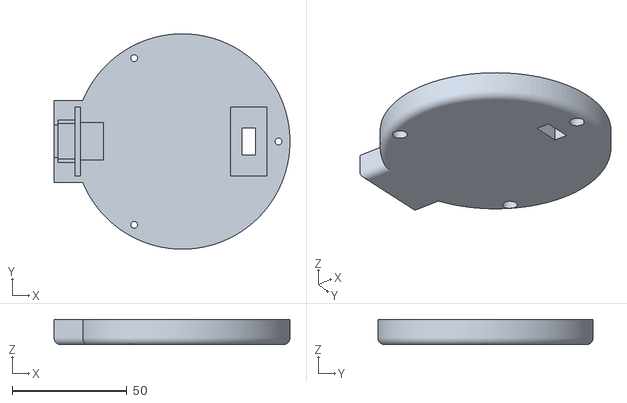
[picture p64: CAD file, 2026-01-21]
ora-8/15_3_3.stl
103.0 x 94.0 x 11.0
