sergei-nntu/ora/ora-7/14_4_8.stl

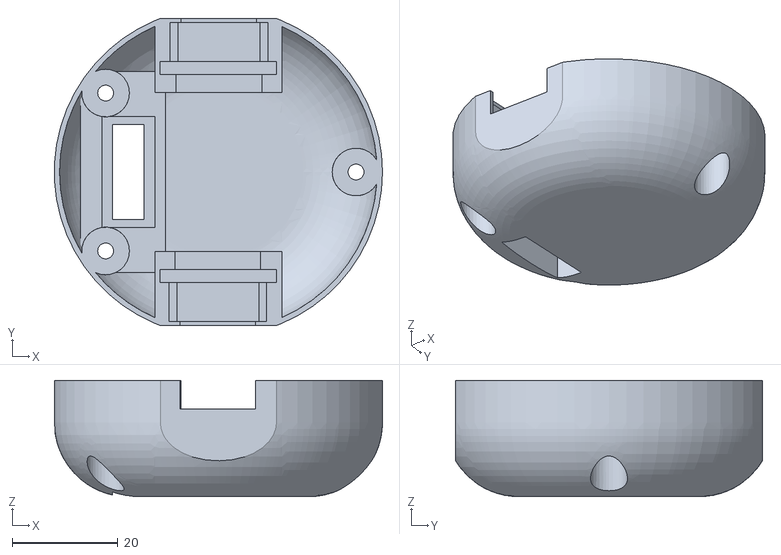
[picture p65: CAD file, 2026-02-20]
ora-7/14_4_8.stl
62.0 x 58.0 x 22.0
