sergei-nntu/ora/ora-8/JST-XHP-5S-tuned.stl

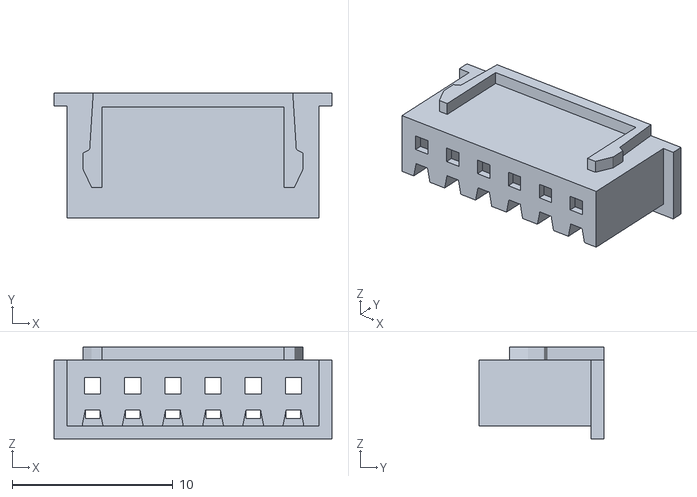
[picture p66: CAD file, 2026-01-21]
ora-8/JST-XHP-5S-tuned.stl
17.3 x 7.75 x 5.70
