sergei-nntu/ora/ora-3/9_2_1.stl

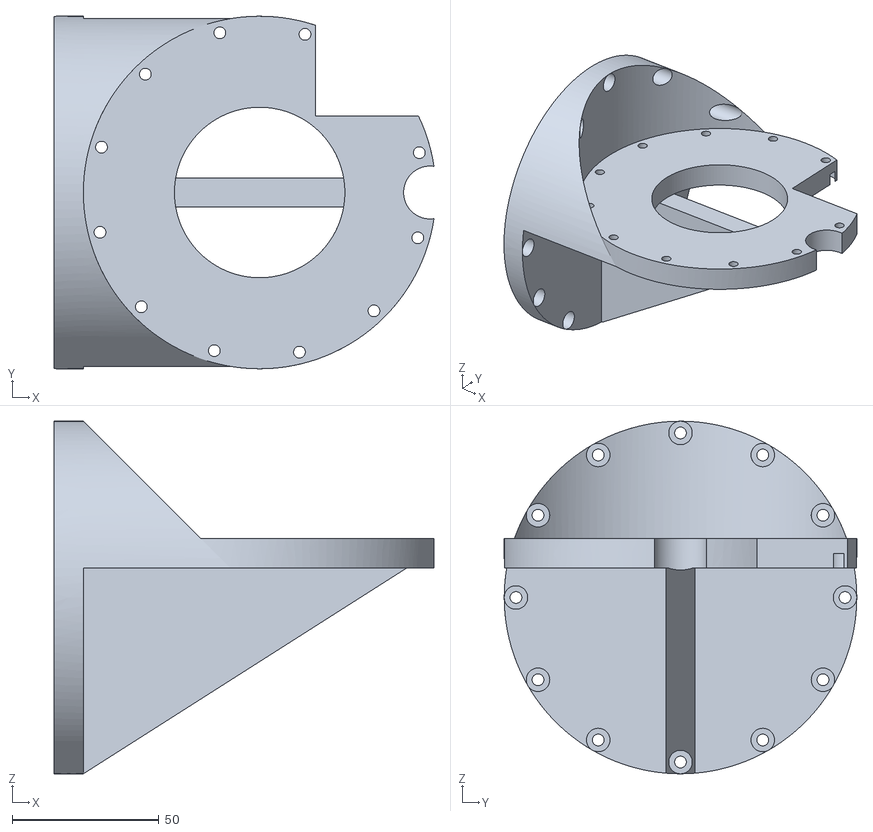
[picture p67: CAD file, 2023-04-27]
ora-3/9_2_1.stl
129.3 x 120.0 x 120.0
