sergei-nntu/ora/ora-7/14_5_3.stl

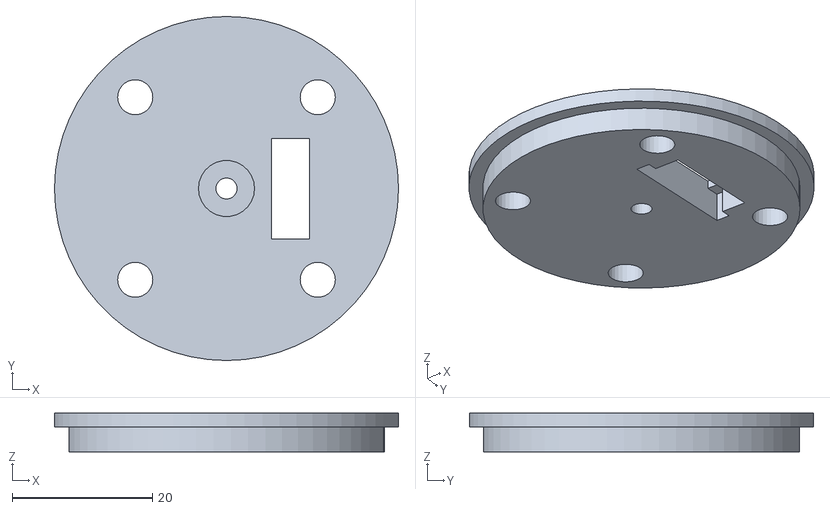
[picture p68: CAD file, 2026-02-09]
ora-7/14_5_3.stl
49.0 x 49.0 x 5.50
