sergei-nntu/ora/ora-8/15_1_3.stl

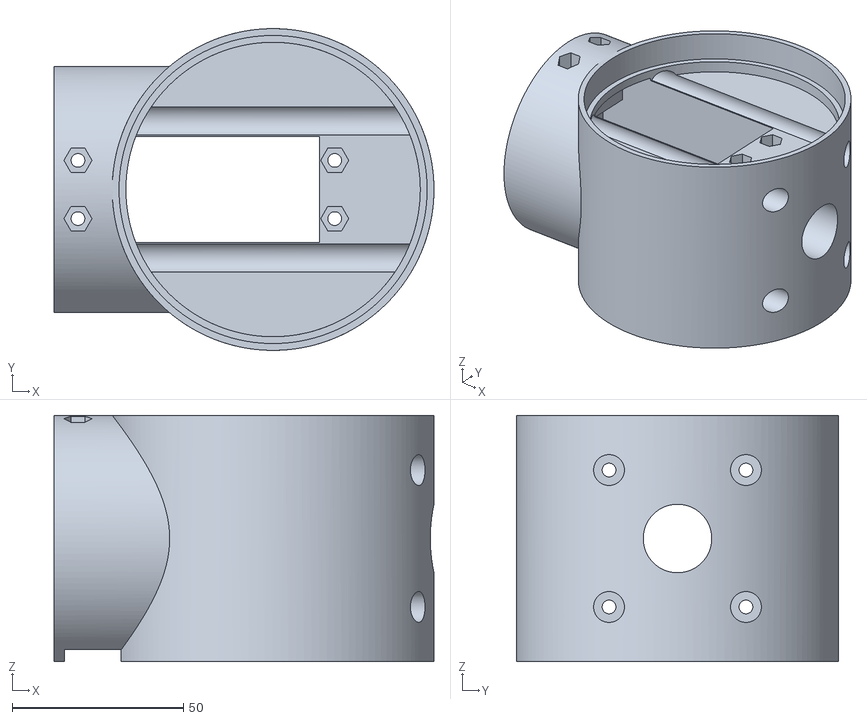
[picture p69: CAD file, 2026-01-14]
ora-8/15_1_3.stl
111.0 x 94.0 x 72.0
