sergei-nntu/ora/ora-9/17_2_1.stl

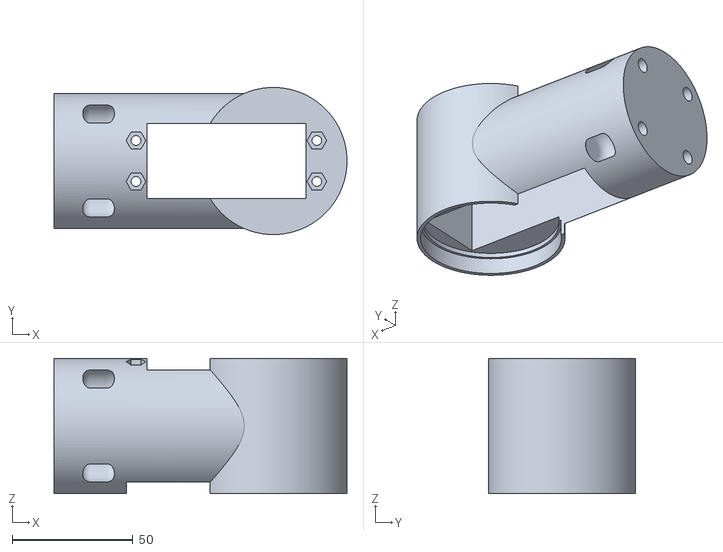
[picture p70: CAD file, 2026-01-14]
ora-9/17_2_1.stl
121.5 x 61.0 x 56.0
