sergei-nntu/ora/ora-3/8_1_2.stl

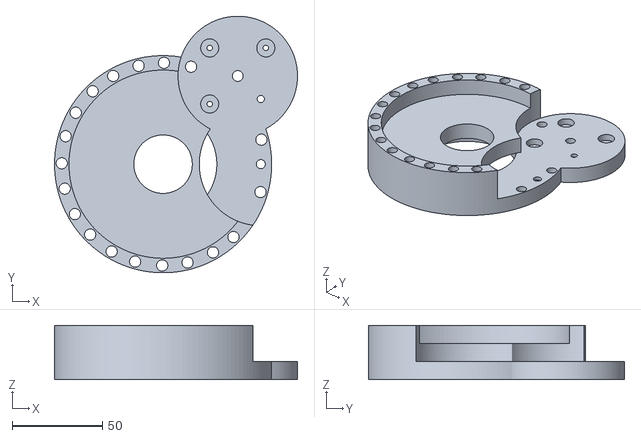
[picture p71: CAD file, 2023-04-27]
ora-3/8_1_2.stl
134.3 x 141.7 x 30.0
