sergei-nntu/ora/ora-7/14_4_7.stl

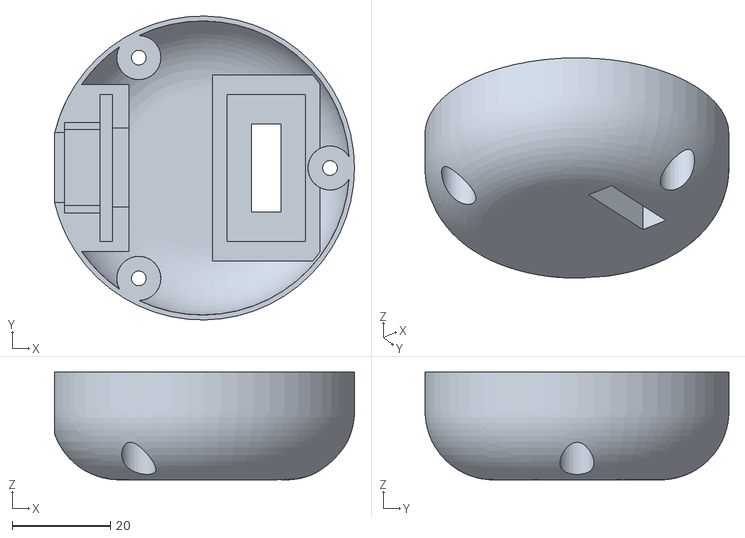
[picture p72: CAD file, 2026-02-09]
ora-7/14_4_7.stl
61.2 x 62.0 x 22.0
