sergei-nntu/ora/ora-8/15_1_8.stl

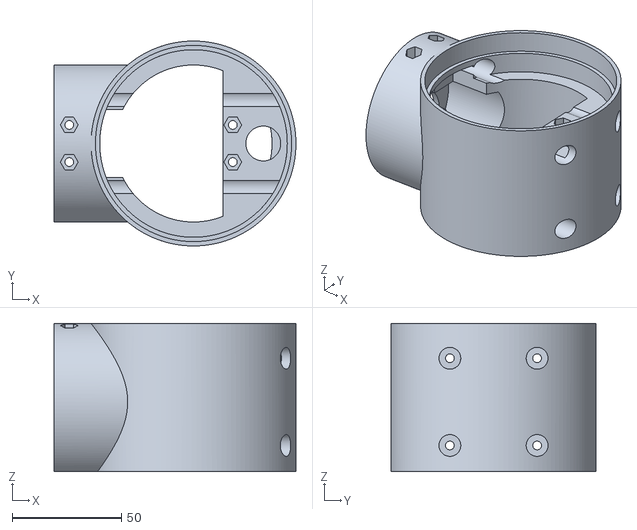
[picture p73: CAD file, 2026-01-14]
ora-8/15_1_8.stl
111.0 x 94.0 x 68.0
