sergei-nntu/ora/ora-8/15_2_4.stl

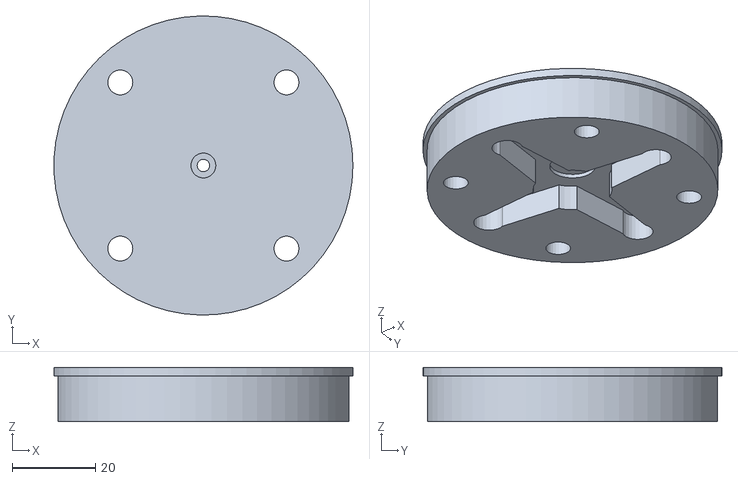
[picture p75: CAD file, 2026-01-14]
ora-8/15_2_4.stl
71.9 x 72.0 x 13.0
