sergei-nntu/ora/ora-3/8_9_1.stl

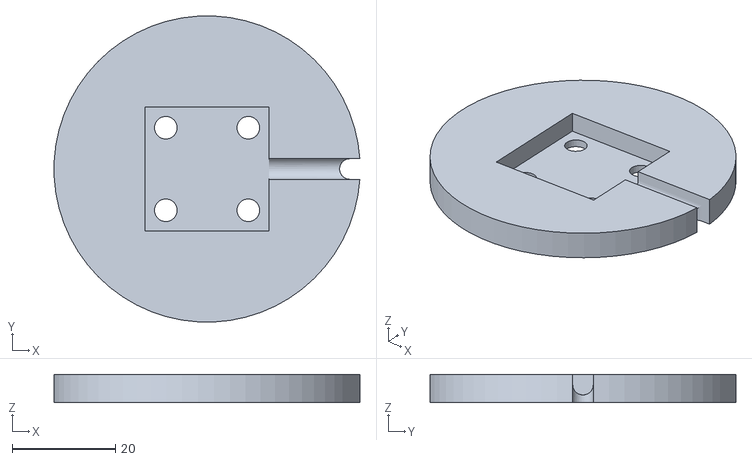
[picture p76: CAD file, 2023-04-27]
ora-3/8_9_1.stl
59.3 x 59.3 x 5.50
