sergei-nntu/ora/ora-8/15_6_2.stl

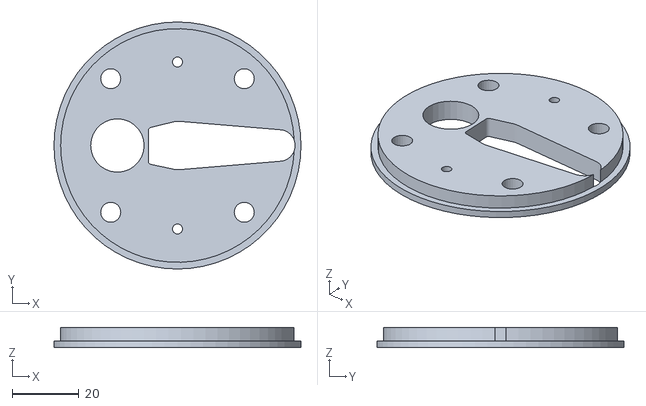
[picture p77: CAD file, 2026-01-14]
ora-8/15_6_2.stl
74.0 x 74.0 x 6.00
