sergei-nntu/ora/ora-3/8_6_2.stl

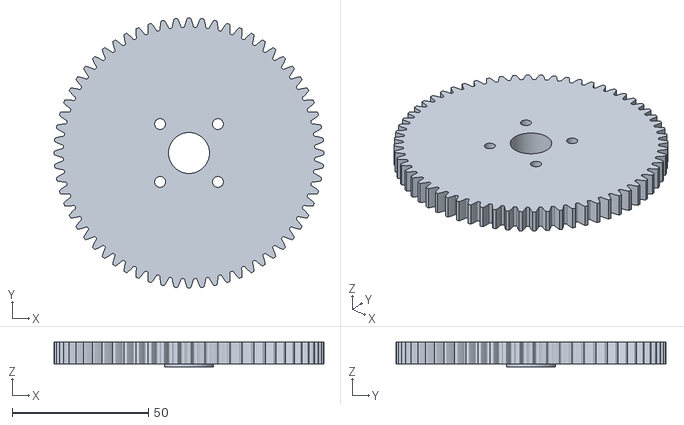
[picture p78: CAD file, 2023-04-27]
ora-3/8_6_2.stl
99.0 x 99.0 x 9.00
