sergei-nntu/ora/ora-8/15_1_4.stl

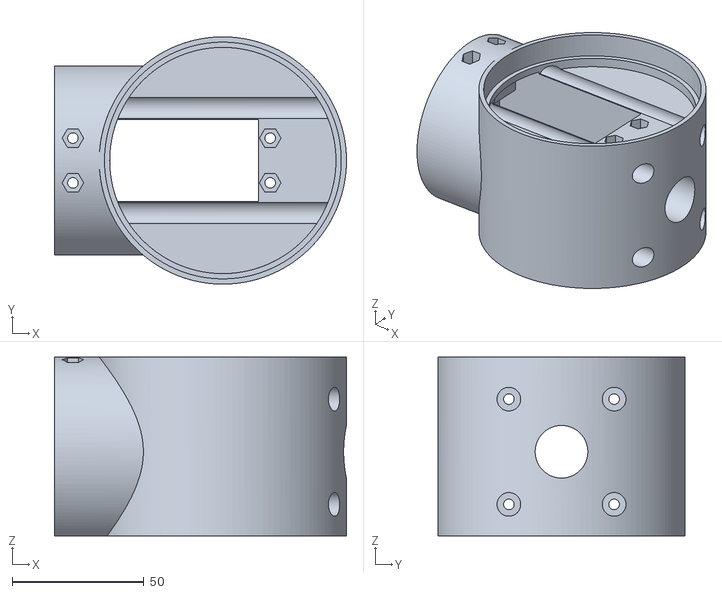
[picture p80: CAD file, 2026-01-14]
ora-8/15_1_4.stl
111.0 x 94.0 x 68.0
