sergei-nntu/ora/ora-3/8_2_1.stl

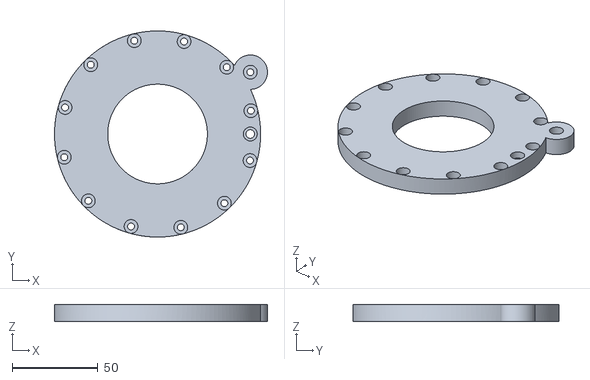
[picture p81: CAD file, 2023-04-27]
ora-3/8_2_1.stl
124.0 x 120.0 x 10.0
