sergei-nntu/ora/ora-7/14_1_7.stl

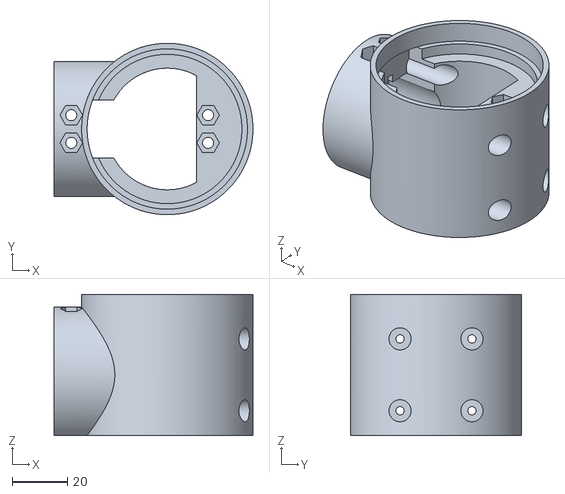
[picture p82: CAD file, 2026-01-14]
ora-7/14_1_7.stl
72.0 x 62.0 x 51.1
