sergei-nntu/ora/ora-8/ora-8 7.FCStd

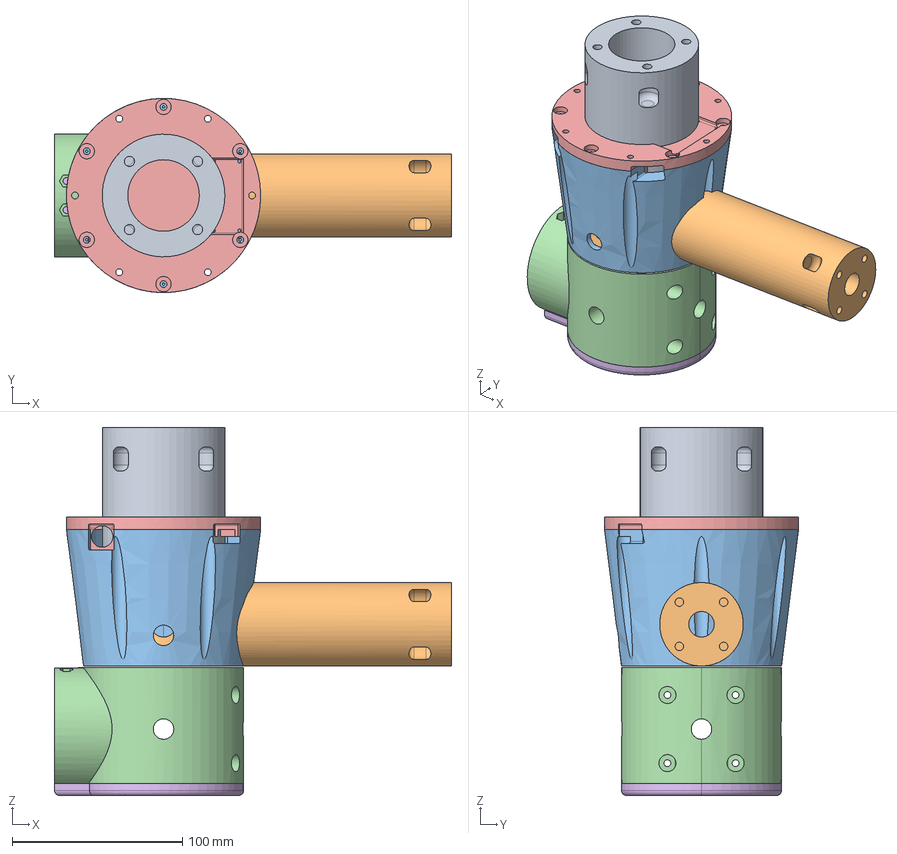
[picture p83: CAD file, 2026-01-14]
ora-8/ora-8 7.FCStd
233.0 x 114.0 x 216.0 mm
ORM-1 Upper Arm
ORM-1 Forearm With Wire Holes
ORM-1 Base001
ORA-8 Body002
ORM Base Bottom
ORA-8 Cap With Space for Wires
