sergei-nntu/ora/ora-7/14_4_4.stl

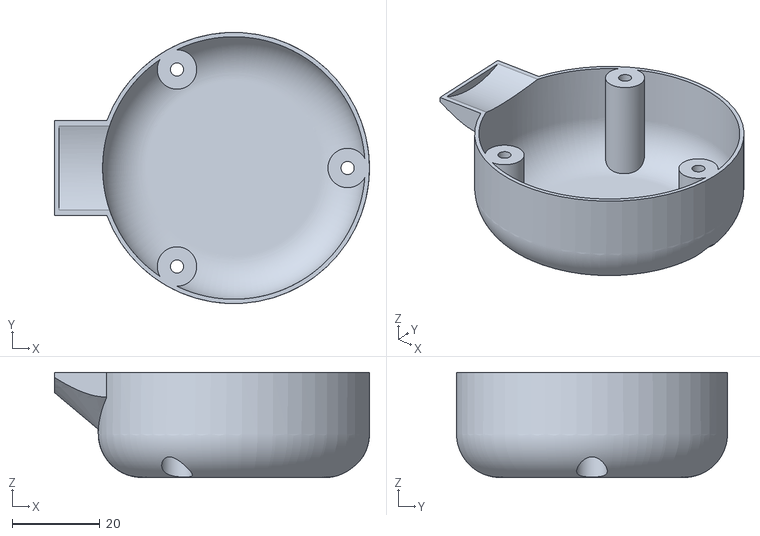
[picture p84: CAD file, 2026-01-14]
ora-7/14_4_4.stl
72.0 x 61.9 x 24.0
