sergei-nntu/ora/ora-8/15_2_9.stl

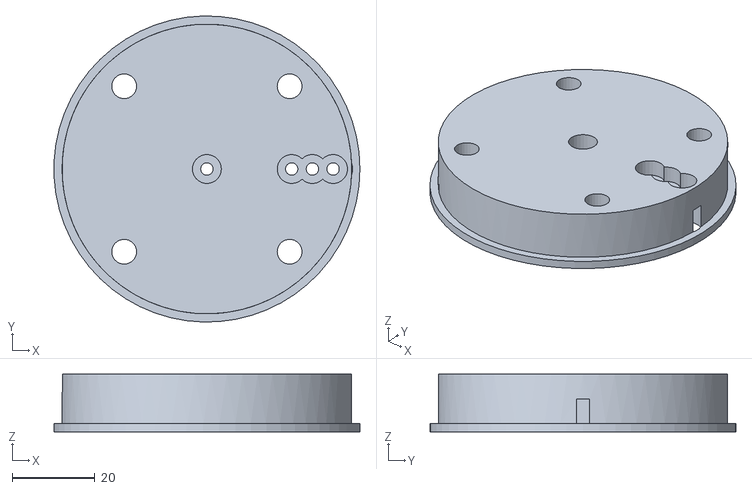
[picture p85: CAD file, 2026-01-14]
ora-8/15_2_9.stl
73.9 x 74.0 x 14.0
