sergei-nntu/ora/ora-7/14_6_1.stl

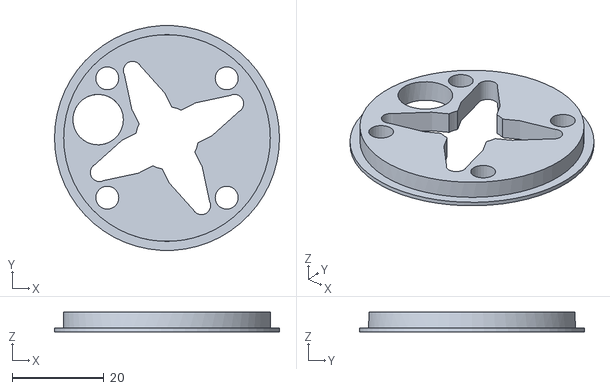
[picture p86: CAD file, 2026-01-14]
ora-7/14_6_1.stl
49.0 x 48.9 x 4.30
