sergei-nntu/ora/ora-7/14_4_6.stl

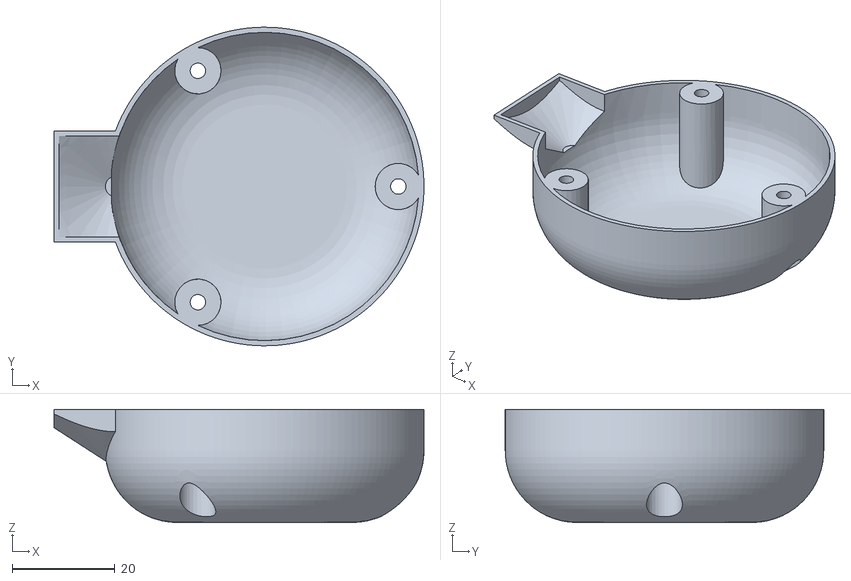
[picture p88: CAD file, 2026-01-14]
ora-7/14_4_6.stl
72.0 x 62.0 x 22.0
