sergei-nntu/ora/ora-8/15_1_1.stl

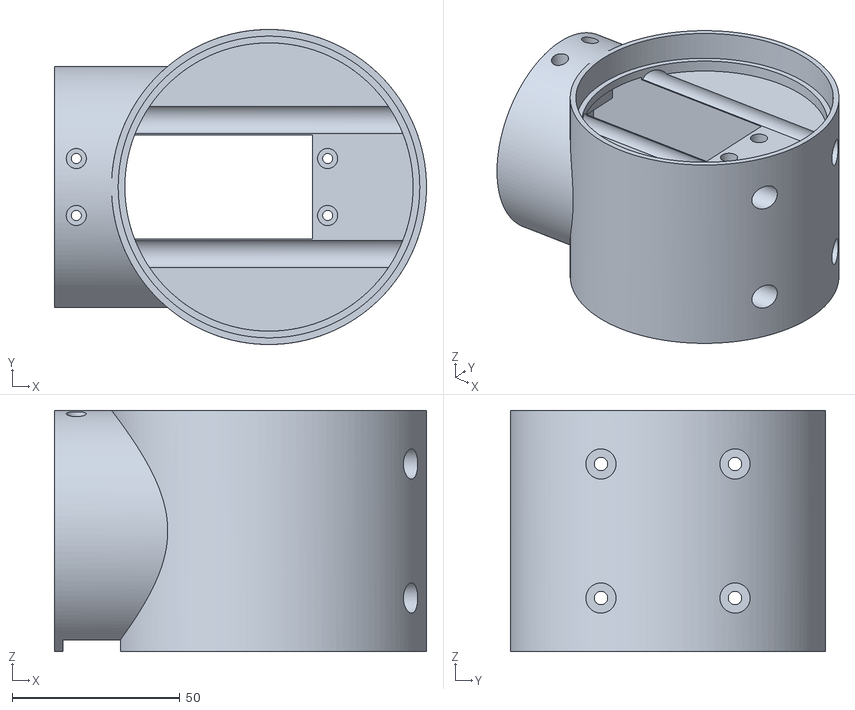
[picture p89: CAD file, 2026-01-14]
ora-8/15_1_1.stl
111.0 x 94.0 x 72.0
