sergei-nntu/ora/ora-7/14_1_1.stl

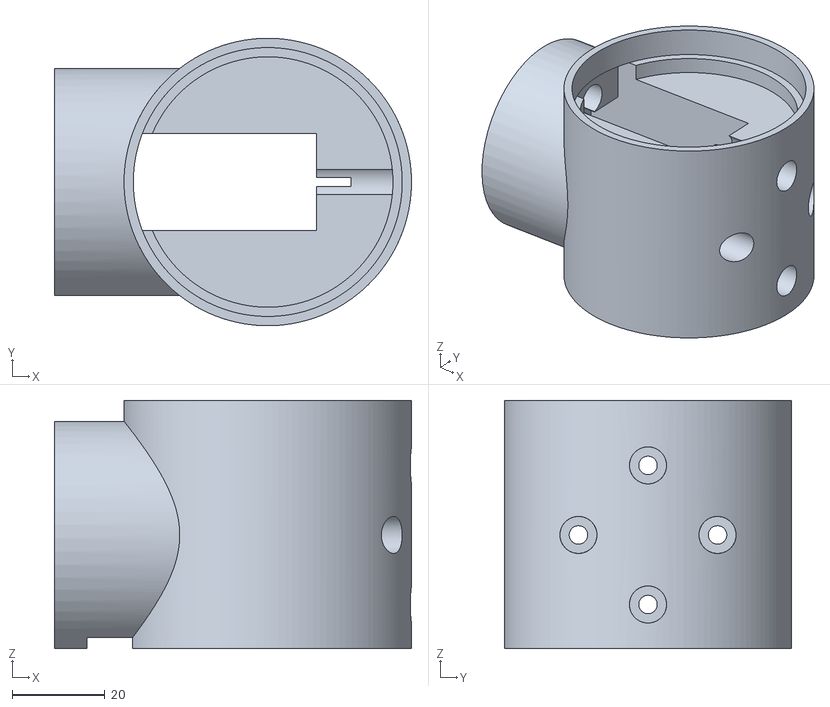
[picture p90: CAD file, 2026-01-14]
ora-7/14_1_1.stl
77.0 x 62.0 x 53.5
