sergei-nntu/ora/ora-3/8_5_4.stl

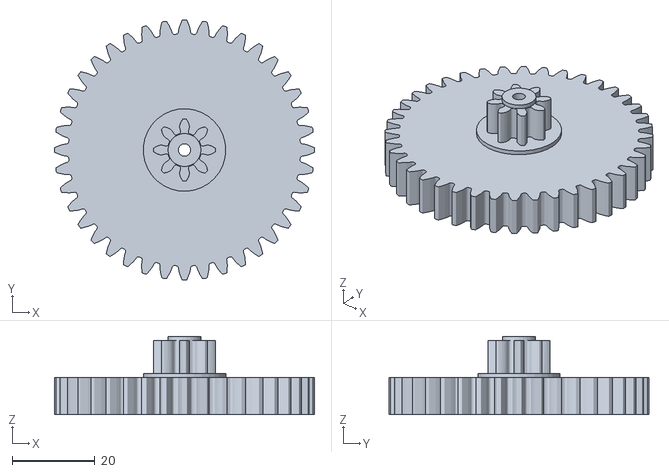
[picture p91: CAD file, 2023-04-27]
ora-3/8_5_4.stl
63.0 x 63.0 x 19.0
