sergei-nntu/ora/ora-7/14_1_4.stl

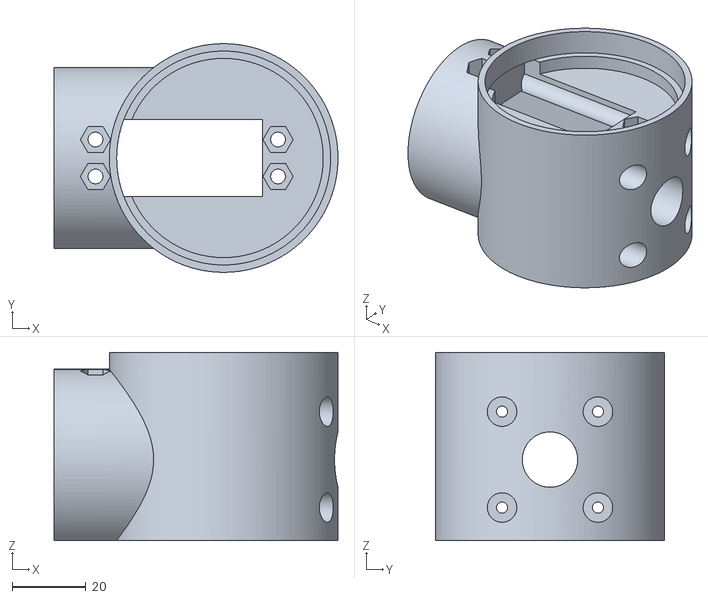
[picture p92: CAD file, 2026-01-14]
ora-7/14_1_4.stl
77.0 x 62.0 x 51.1
