sergei-nntu/ora/ora-3/8_4_1.stl

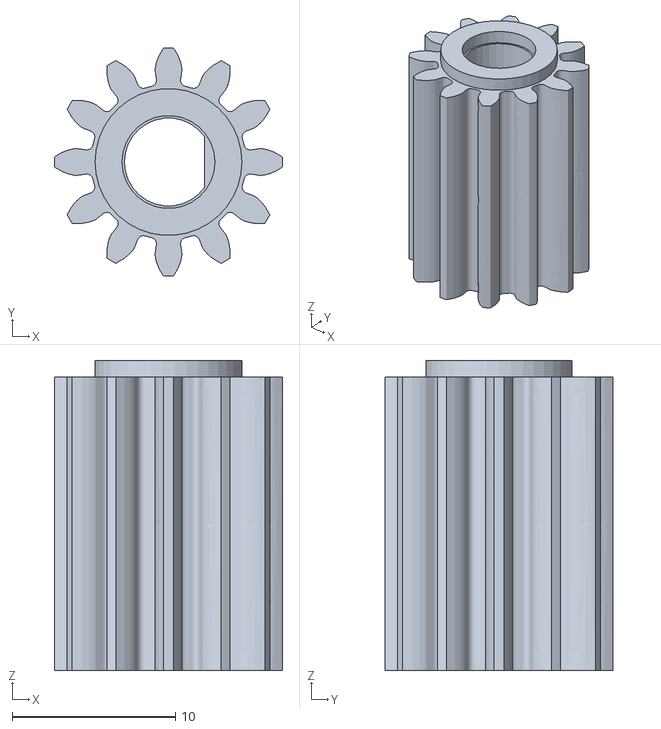
[picture p93: CAD file, 2023-04-27]
ora-3/8_4_1.stl
14.0 x 14.0 x 19.0
