sergei-nntu/ora/ora-8/15_1_7.stl

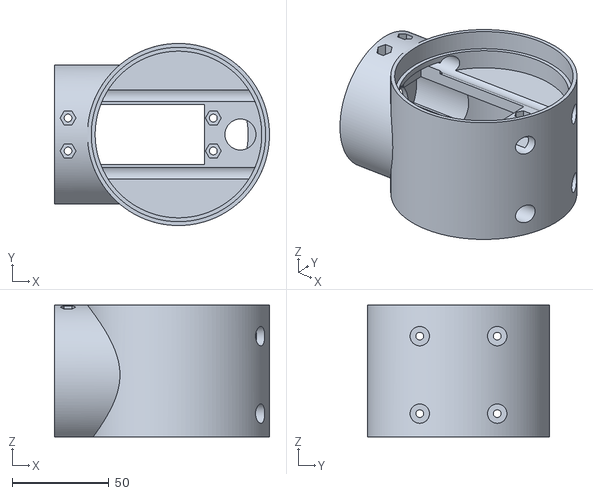
[picture p94: CAD file, 2026-01-14]
ora-8/15_1_7.stl
111.0 x 94.0 x 68.0
