sergei-nntu/ora/ora-3/9_1_1.stl

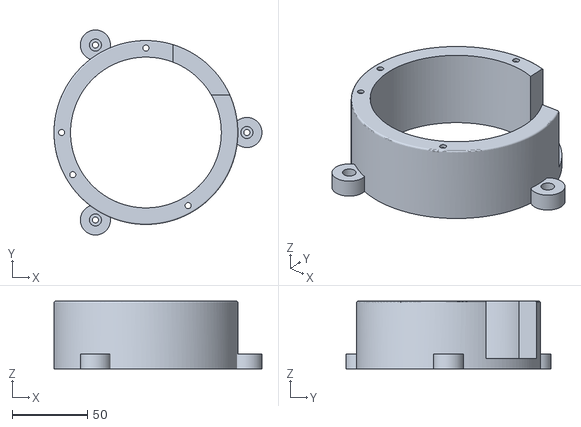
[picture p95: CAD file, 2023-04-27]
ora-3/9_1_1.stl
138.0 x 136.0 x 45.0
