sergei-nntu/ora/ora-7/14_1_5.stl

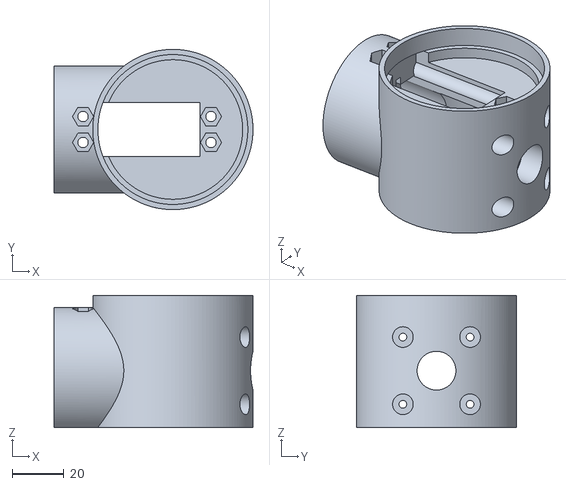
[picture p96: CAD file, 2026-01-14]
ora-7/14_1_5.stl
77.0 x 62.0 x 51.1
