sergei-nntu/ora/ora-3/8_5_1.stl

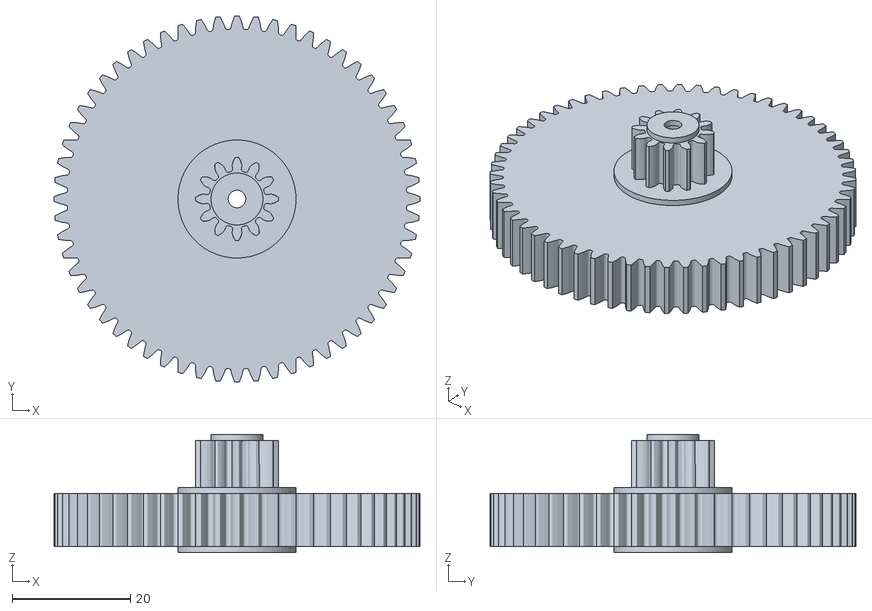
[picture p97: CAD file, 2023-04-27]
ora-3/8_5_1.stl
62.0 x 62.0 x 20.0
