sergei-nntu/ora/ora-7/ora-7 M4 Backup.FCStd

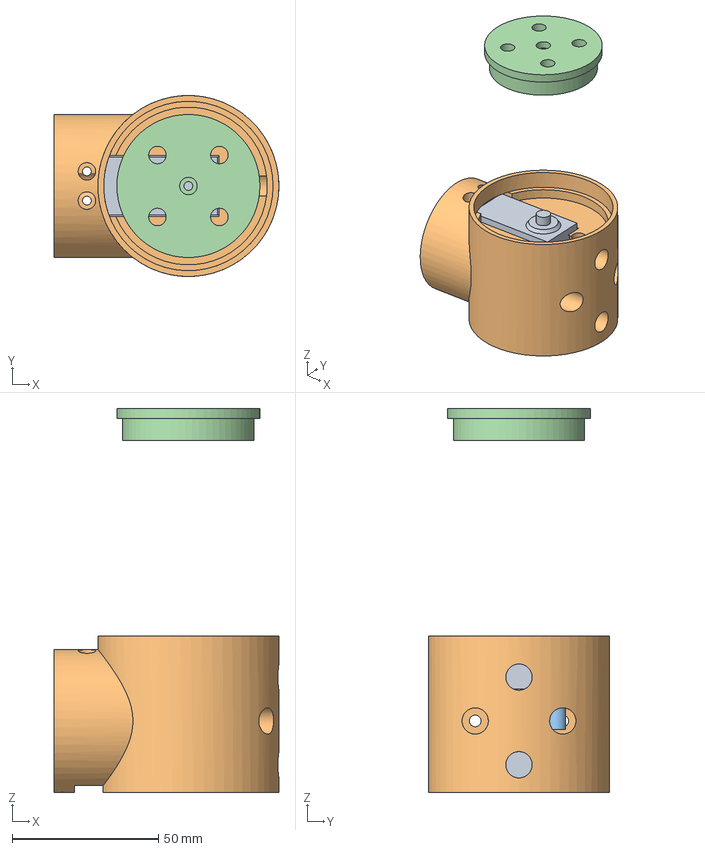
[picture p98: CAD file, 2026-01-14]
ora-7/ora-7 M4 Backup.FCStd
77.0 x 62.0 x 131.5 mm
DS3240
ORA-7
