sergei-nntu/ora/ora-8/ora-8 2.FCStd

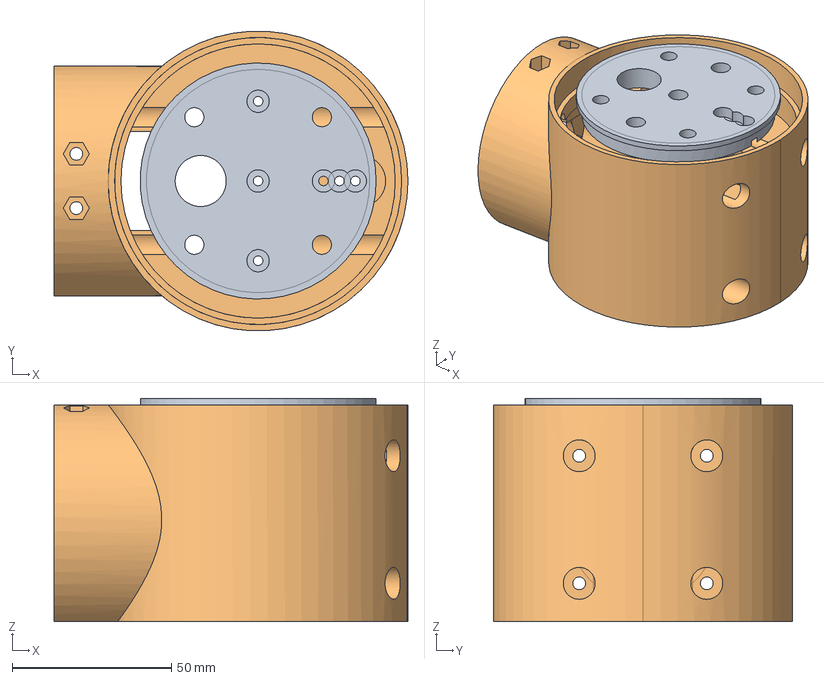
[picture p99: CAD file, 2026-01-14]
ora-8/ora-8 2.FCStd
111.0 x 93.9 x 70.0 mm
ORA-8 Shaft Upper Half
ORA-8 Even More Space for Wires
