sergei-nntu/ora/ora-8/15_2_1.stl

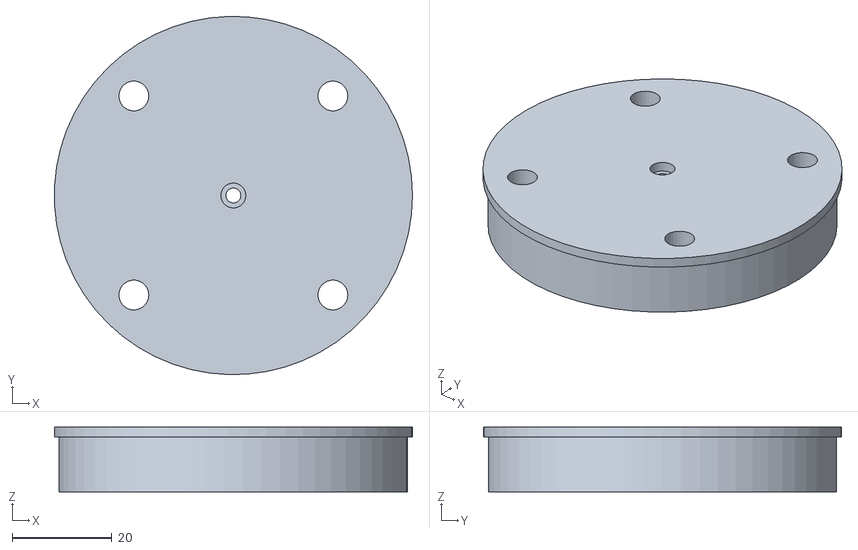
[picture p100: CAD file, 2026-01-14]
ora-8/15_2_1.stl
71.9 x 72.0 x 13.0
