sergei-nntu/ora/ora-7/14_5_2.stl

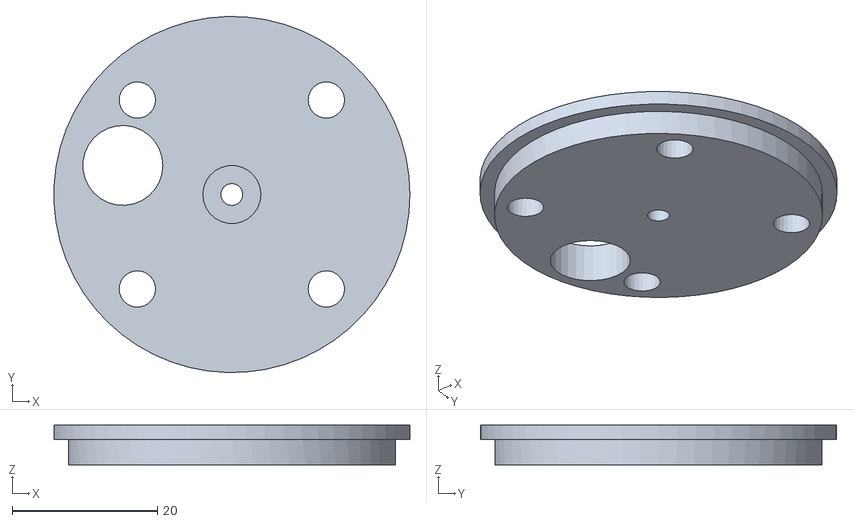
[picture p101: CAD file, 2026-01-14]
ora-7/14_5_2.stl
49.0 x 49.0 x 5.50
