sergei-nntu/ora/ora-8/ora-8 3.FCStd

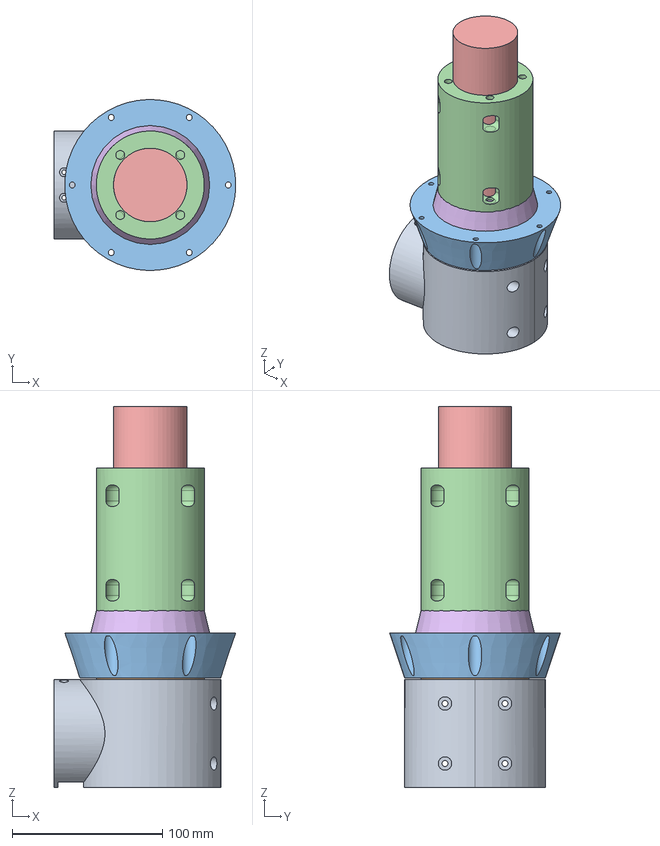
[picture p102: CAD file, 2026-01-14]
ora-8/ora-8 3.FCStd
121.0 x 113.9 x 254.0 mm
ORA-8 Body
ORA-8 Shaft. Anti-Tension
ORM-1 Base
ORM-1 Upper Arm
