sergei-nntu/ora/ora-3/9_3_1.stl

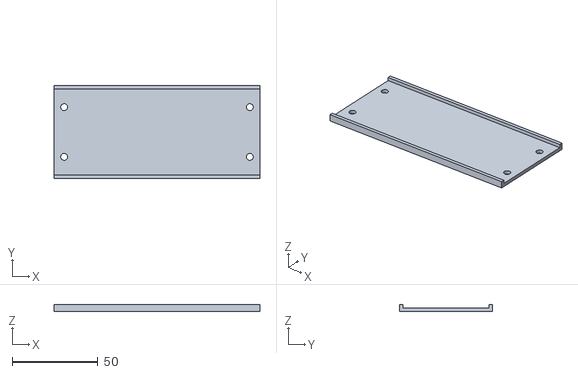
[picture p103: CAD file, 2023-04-27]
ora-3/9_3_1.stl
120.0 x 54.0 x 4.00
