sergei-nntu/ora/ora-7/14_2_1.stl

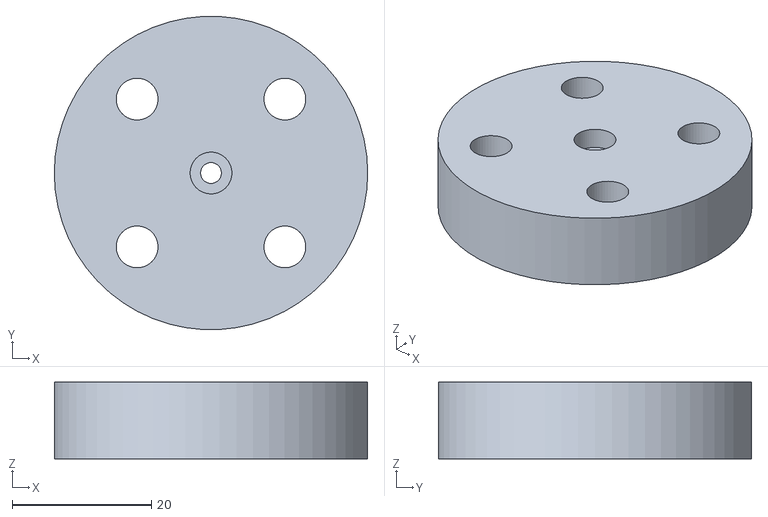
[picture p104: CAD file, 2026-01-14]
ora-7/14_2_1.stl
45.0 x 44.9 x 11.0
