sergei-nntu/ora/ora-3/8_2_3.stl

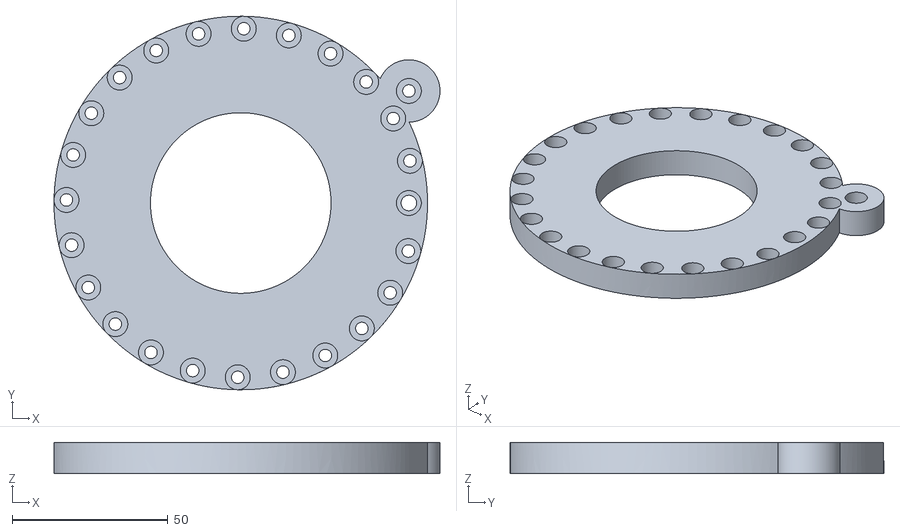
[picture p105: CAD file, 2023-04-27]
ora-3/8_2_3.stl
124.0 x 120.0 x 10.0
