sergei-nntu/ora/ora-7/14_4_3.stl

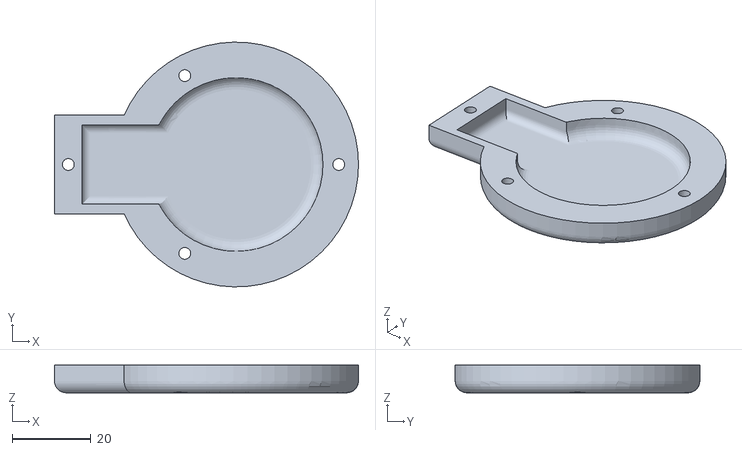
[picture p106: CAD file, 2026-01-14]
ora-7/14_4_3.stl
77.0 x 62.0 x 7.00
