sergei-nntu/ora/ora-8/ora-8 5.FCStd

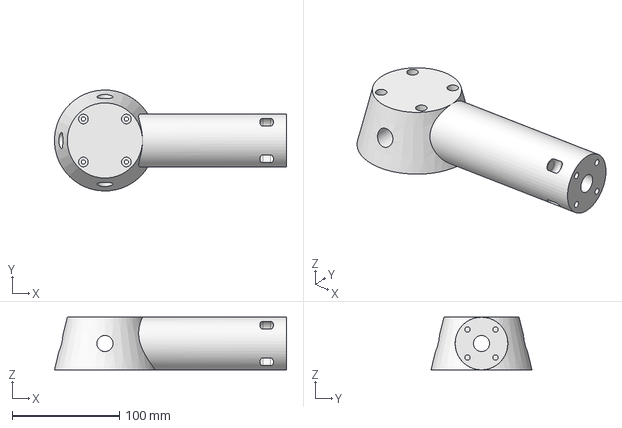
[picture p107: CAD file, 2026-01-14]
ora-8/ora-8 5.FCStd
215.9 x 94.0 x 49.0 mm
