sergei-nntu/ora/ora-7/WristJoint.stl

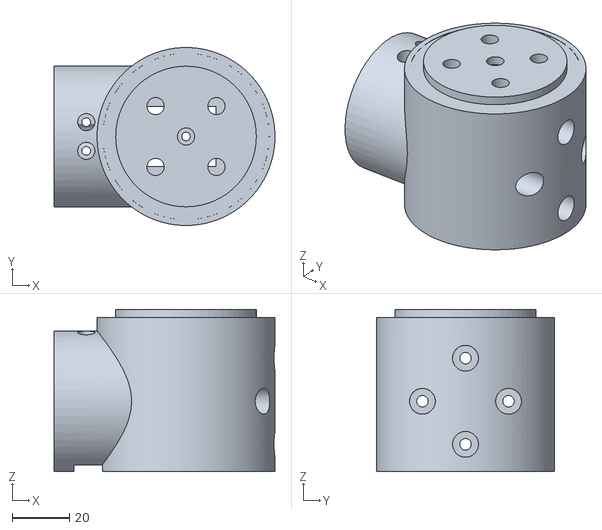
[picture p108: CAD file, 2026-01-14]
ora-7/WristJoint.stl
77.0 x 62.0 x 56.5
