sergei-nntu/ora/ora-8/15_5_2.stl

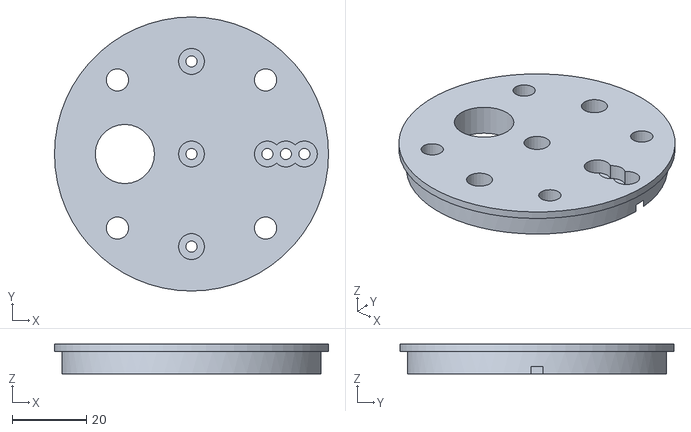
[picture p109: CAD file, 2026-01-14]
ora-8/15_5_2.stl
74.0 x 74.0 x 8.00
