sergei-nntu/ora/ora-7/14_4_2.stl

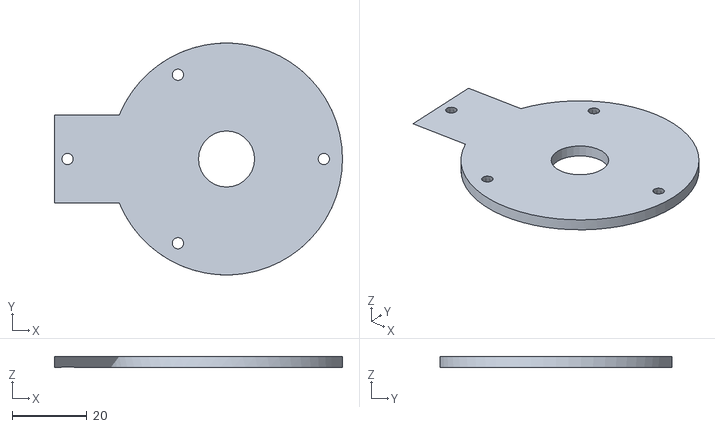
[picture p110: CAD file, 2026-01-14]
ora-7/14_4_2.stl
77.0 x 62.0 x 3.00
