sergei-nntu/ora/ora-8/15_4_1.stl

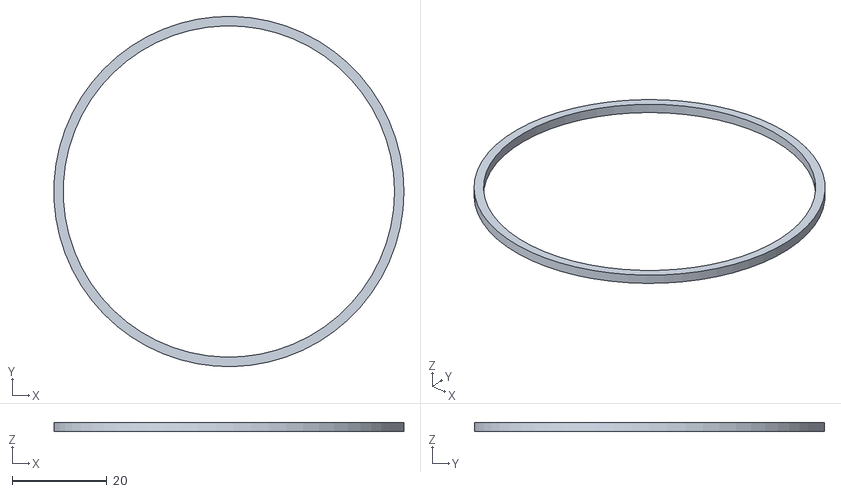
[picture p111: CAD file, 2026-01-14]
ora-8/15_4_1.stl
74.0 x 74.0 x 2.00
