sergei-nntu/ora/ora-7/14_2_3.stl

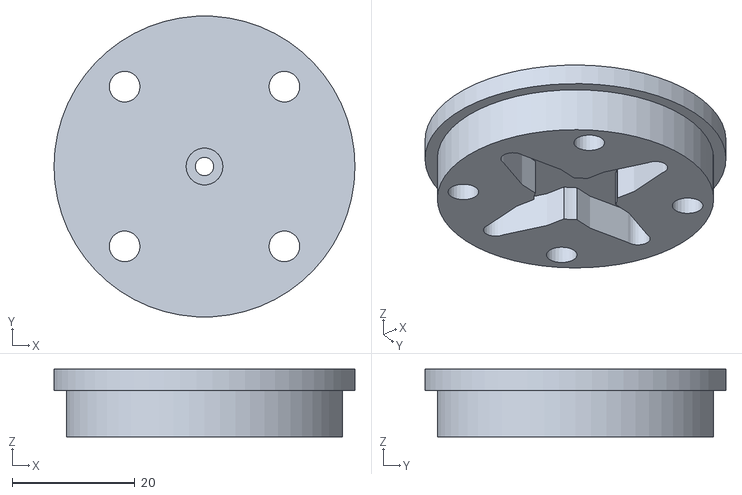
[picture p112: CAD file, 2026-01-14]
ora-7/14_2_3.stl
49.0 x 48.9 x 11.0
