sergei-nntu/ora/ora-3/ora-3.FCStd

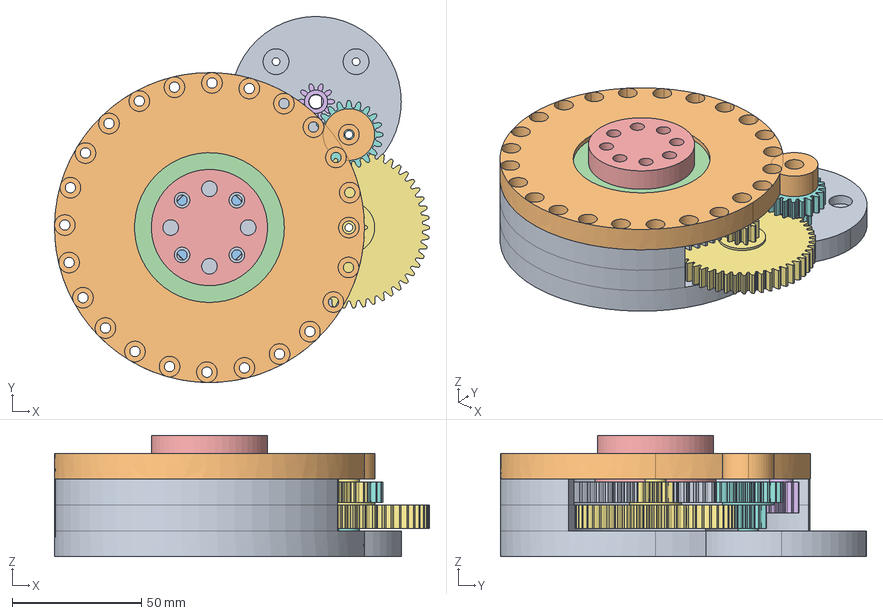
[picture p113: CAD file, 2023-04-27]
ora-3/ora-3.FCStd
145.2 x 141.7 x 47.0 mm
MainGear
AS5600 Mount
Bearing 6002
Bearing 6809
MainShaftWithExtended AT Ring
SmallGear Anti Tension
MediumGear
MediumGear_Small002
ORA-3 Body. Extra Mnt Holes
ORA-3 Cover. Extra MNT Holes
