sergei-nntu/ora/ora-7/14_2_2.stl

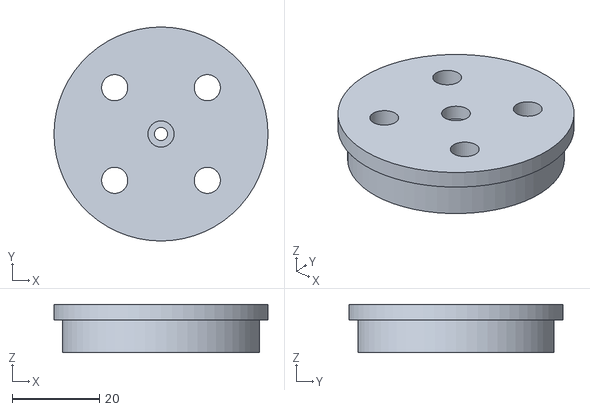
[picture p114: CAD file, 2026-01-14]
ora-7/14_2_2.stl
49.0 x 49.0 x 11.0
