sergei-nntu/ora/ora-8/ora-8 9.FCStd

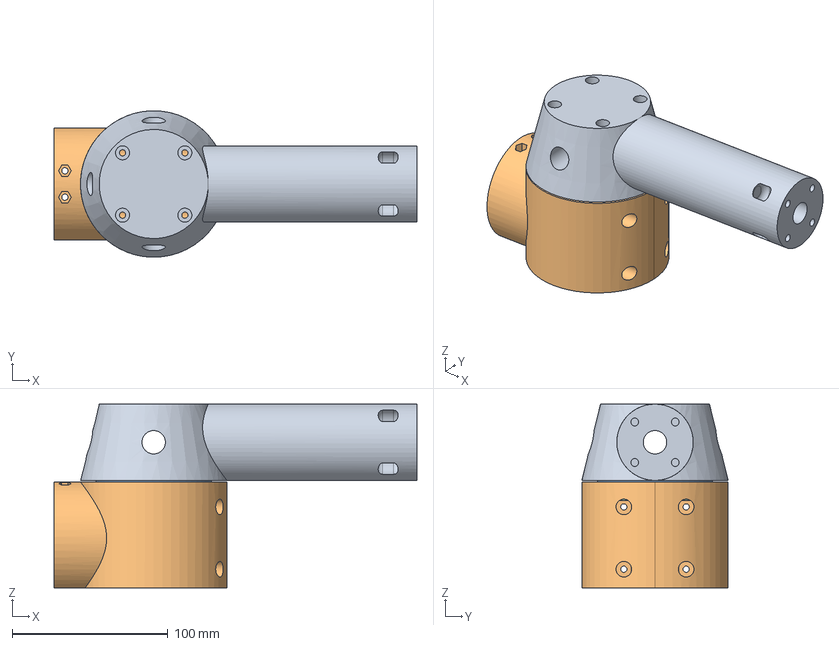
[picture p115: CAD file, 2026-01-14]
ora-8/ora-8 9.FCStd
233.0 x 94.0 x 118.0 mm
ORM-1 Forearm With Wire Holes
ORA-8 Body Run-Through Wires Holes
ORA-8 Shaft Upper Half
ORA-8 Shaft Lower Half
