sergei-nntu/ora/ora-3/8_7_1.stl

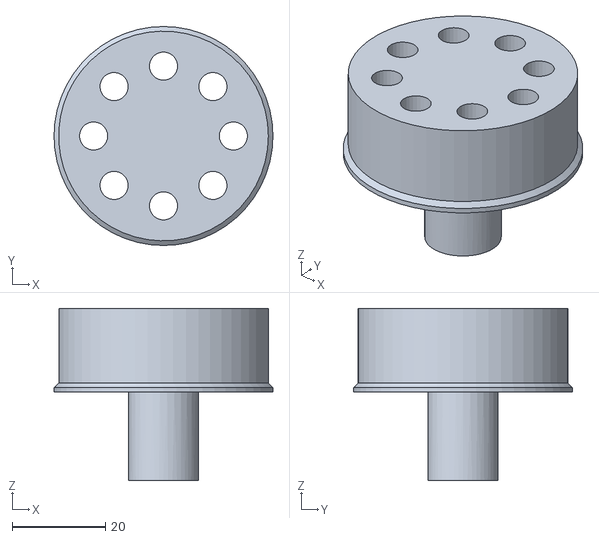
[picture p116: CAD file, 2023-04-27]
ora-3/8_7_1.stl
47.0 x 47.0 x 37.0
