sergei-nntu/ora/ora-7/ora-7 4.FCStd

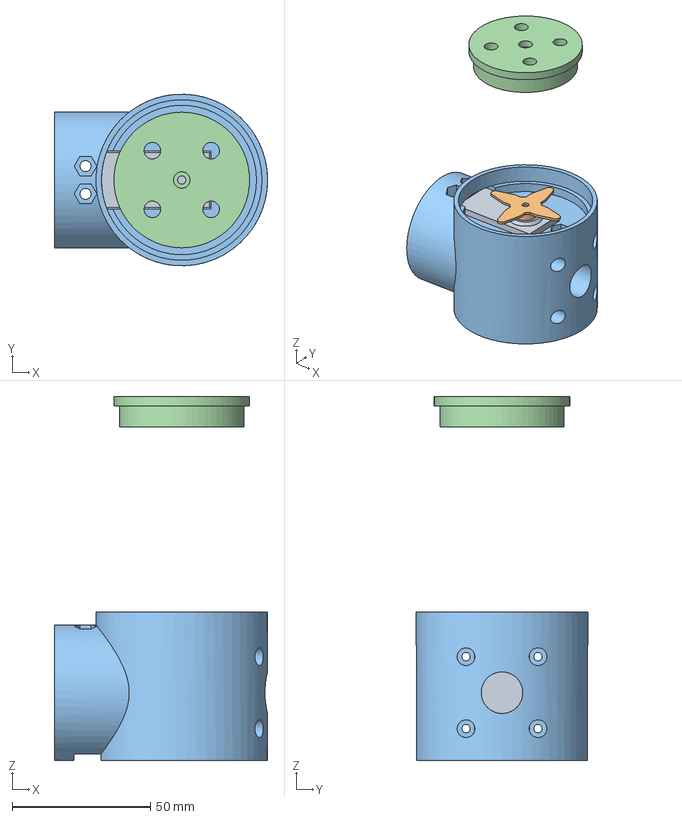
[picture p117: CAD file, 2026-01-14]
ora-7/ora-7 4.FCStd
77.0 x 62.0 x 131.5 mm
DS3240
DS3240-CrossARM
ORA-7 Body_
