sergei-nntu/ora/(list of files, cad)

Other CAD files:
ora-3/8_5_6.stl
ora-9/ora-9 4.FCStd
ora-9/17_1_3.stl
ora-7/14_6_4.stl
ora-9/17_1_5.stl
ora-3/8_6_4.stl
ora-4/12_6_1.stl
ora-7/14_1_11.stl
ora-9/ora-9.FCStd
ora-3/8_8_1.stl
ora-9/17_1_2.stl
ora-9/17_3_1.stl
ora-3/8_6_1.stl
ora-7/14_1_10.stl
ora-3/8_5_2.stl
ora-3/8_5_5.stl
ora-3/8_2_2.stl
ora-3/8_5_3.stl
ora-8/15_2_3.stl
ora-8/ora-8 4.FCStd
ora-7/14_1_9.stl
ora-8/15_1_6.stl
ora-3/8_4_2.stl
ora-7/14_1_8.stl
ora-3/8_4_3.stl
ora-3/8_6_3.stl
ora-7/14_4_5.stl
ora-7/14_1_3.stl
ora-8/15_2_6.stl
ora-3/8_3_2.stl
ora-8/15_1_2.stl
ora-3/8_3_1.stl
ora-3/8_3_3.stl
ora-3/8_1_1.stl
ora-8/15_6_1.stl
ora-7/14_1_12.stl
ora-7/14_1_6.stl
ora-7/14_3_1.stl
ora-7/14_4_1.stl
ora-7/14_4_11.stl
ora-7/14_5_1.stl
ora-7/14_5_4.stl
ora-7/14_6_2.stl
ora-7/14_6_5.stl
ora-7/14_9_1.stl
ora-7/ora-7 3.FCStd
ora-8/15_1_5.stl
ora-8/15_1_9.stl
ora-8/15_2_2.stl
ora-8/15_2_7.stl
ora-8/15_2_8.stl
ora-8/15_3_2.stl
ora-8/15_3_6.stl
ora-8/15_4_2.stl
ora-8/15_5_1.stl
ora-8/15_5_3.stl
ora-8/15_6_3.stl
ora-8/15_7_1.stl
ora-8/ora-8 10.FCStd
ora-8/ora-8 11.FCStd
ora-8/ora-8 6.FCStd
