sergei-nntu/ora/ora-8/docs/ORA-8.AssemblyManual.pdf

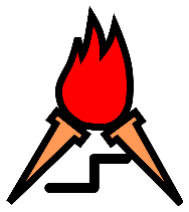
[picture p118: figure]

Telemetry Balkan doo Beograd

# ORA-8

## The Open Robotic Actuator Assembly Manual

Prepared By: Sergei Loshchilov

v 0.1.0

Beograd, Serbia
2026-06-03

Telemetry Balkan doo Beograd

# Version History

Version | Date | Authors | Description
0.1.0 | 2026-04-30 | Sergei Loshchilov | Original Document Started

2

# Contents

Replace the original long screws with M2.5x8.0 screws, to fixate the gearbox again..... 14

Screw the 2 M3x12 screw with the washer and the grover washer in the middle and at

3

4

# 1. Overview

The ORA-8 (Open Robotic Actuator) is a modular, customizable robotic actuator designed for use in distributed robotic systems. It combines mechanical, electronic, and software components into a compact unit capable of precise position control and seamless integration into multi-node architectures.

This manual provides a complete guide to assembling the ORA-8 actuator, starting from the bill of materials and 3D-printed components, through mechanical and electronic assembly, and finishing with software setup and control. The actuator is based on a modified DS51150 servo, enhanced with an external motor driver (BTS7960), an Arduino Pro Mini controller, and an encoder interface to enable closed-loop control and communication over the OSP (Open Serial Peripheral) protocol.

A key feature of the ORA-8 system is its support for ring topology, allowing multiple actuators to be daisy-chained and controlled via a single OSP controller. This makes it particularly suitable for scalable robotic systems such as manipulators, modular robots, and distributed motion platforms.

The document is intended for engineers, developers, and robotics enthusiasts who want to build, understand, and integrate ORA-series actuators into their systems.

5

# 2. Bill of Materials

## 3D Printed Components

Type | Quantity | Image | Comments
ORA-8 Body | 1

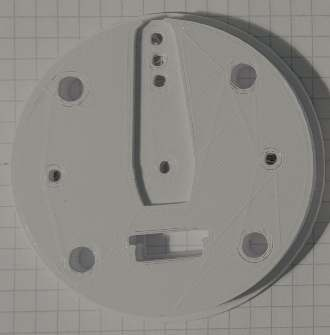
[picture p119: figure]

ORA-8 Shaft Upper Half | 1

6

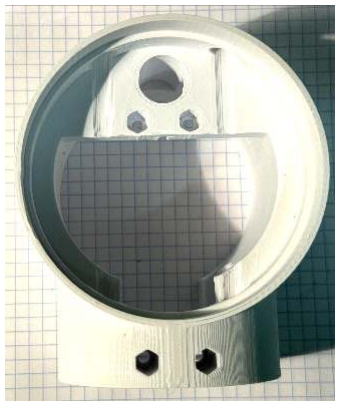
[picture p120: figure]

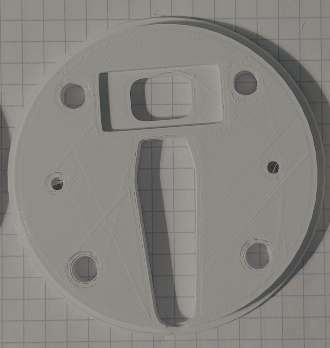
[picture p121: figure]

ORA-8 Shaft Lower Half | 1

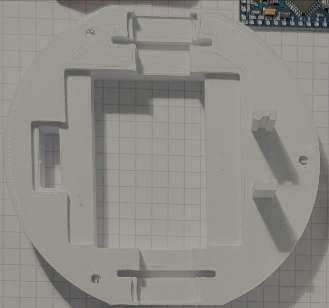
[picture p122: figure]

ORA-8 Lid | 1

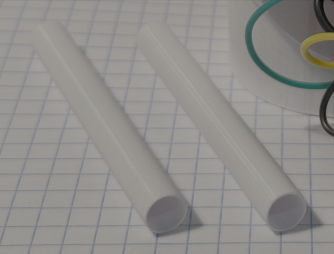
[picture p123: figure]

ORA-8 Schematics and Wires Protection Tubes | 2

## Mechanical Components

Type | Quantity | Image | Comments

7

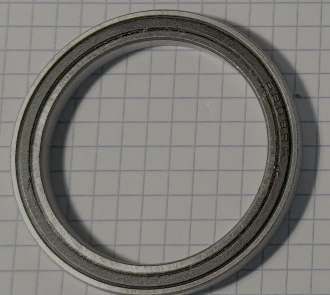
[picture p124: figure]

6814 Bearing | 1

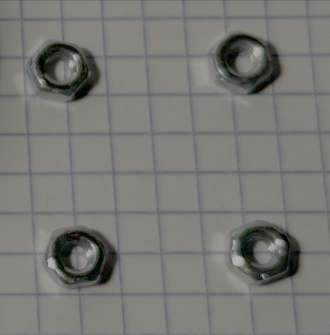
[picture p125: figure]

M4 Nut | 4
M4x10 Screw | 4
M4 Threaded Rivets | 4

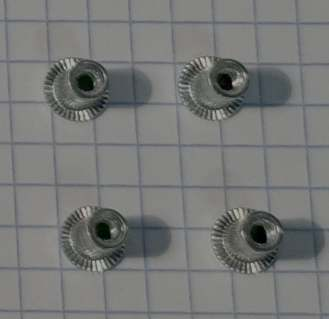
[picture p126: figure]

M2.5x8 Screws | 4 | To replace the original long screws of DS51150 servo

8

DIN 7981 2.9x9.5
Self-Tapping Screw

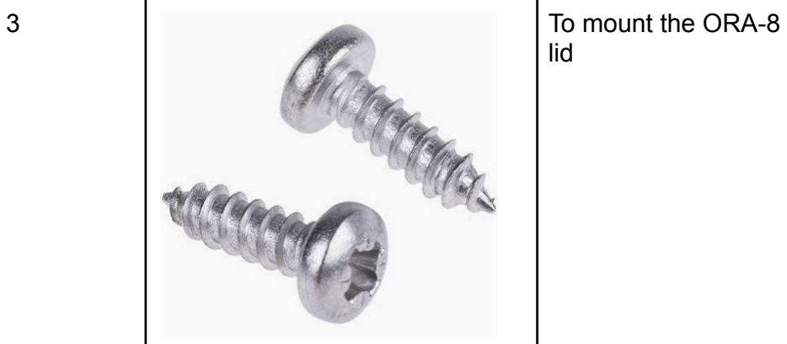
[picture p127: figure]
3 To mount the ORA-8 lid

## Electronic Components

Type | Quantity | Image | Comments

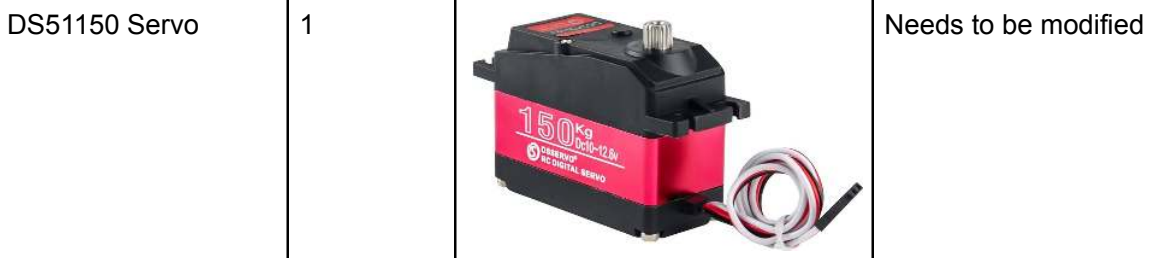
[picture p128: figure]
DS51150 Servo; Needs to be modified
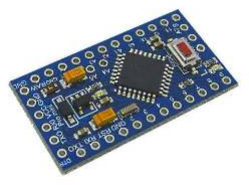
[picture p129: figure]

Arduino Pro Mini 5V 16 MHz | 1 Make sure it is not | | 3.3V 8 MHz version

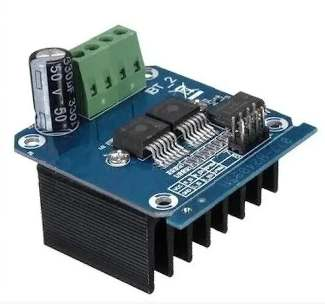
[picture p130: figure]

BTS7960 DC Motor Driver | 1

9

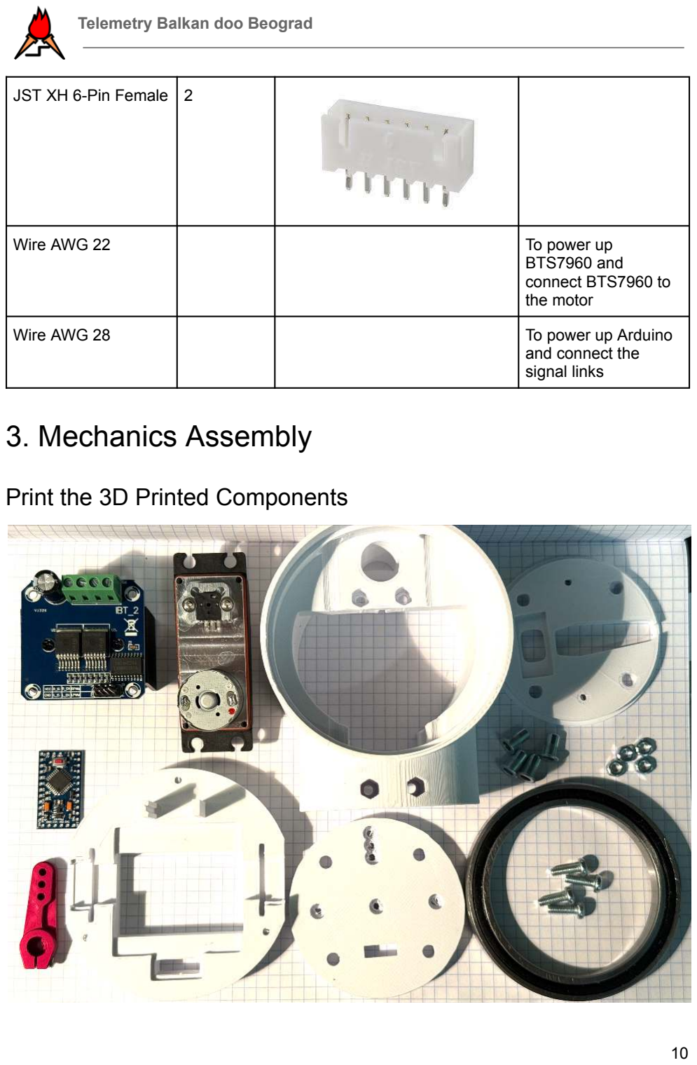
[picture p131: page 10]

JST XH 6-Pin Female | 2
Wire AWG 22 | | To power up BTS7960 and connect BTS7960 to the motor
Wire AWG 28 | | To power up Arduino and connect the signal links

# 3. Mechanics Assembly

## Print the 3D Printed Components

10

## Partially Disassemble DS51150

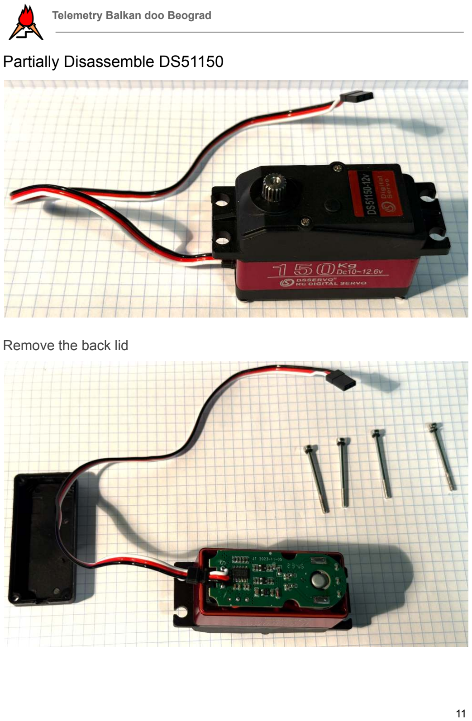
[picture p132: page 11]

### Remove the back lid

11

### Unsolder the PCB from the motor and the encoder

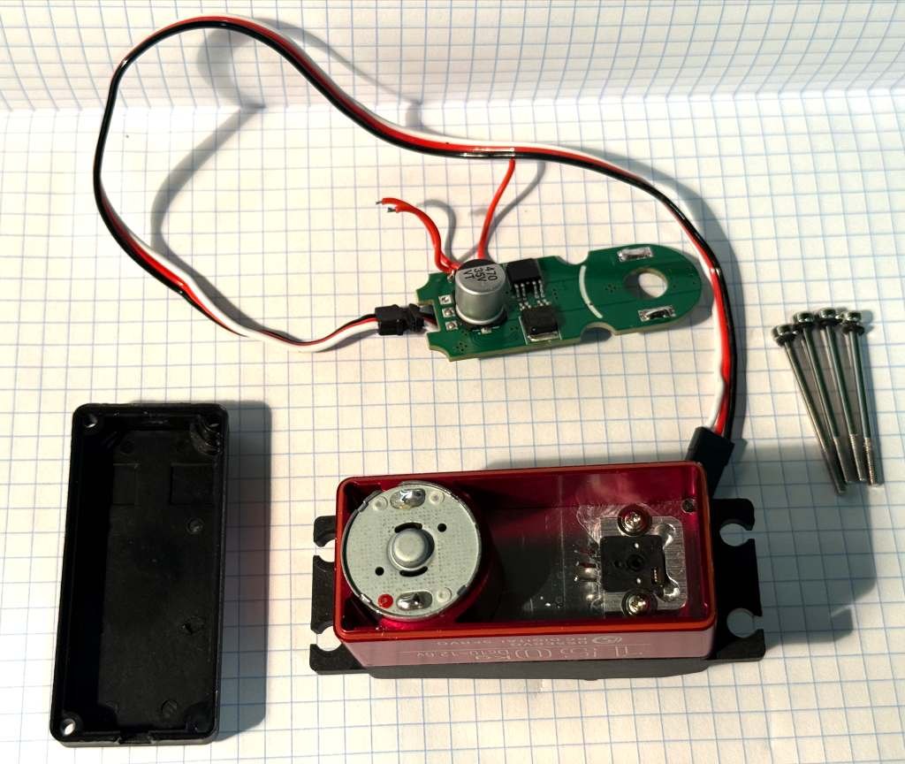
[picture p133: figure]

12

### Remove the aluminium body

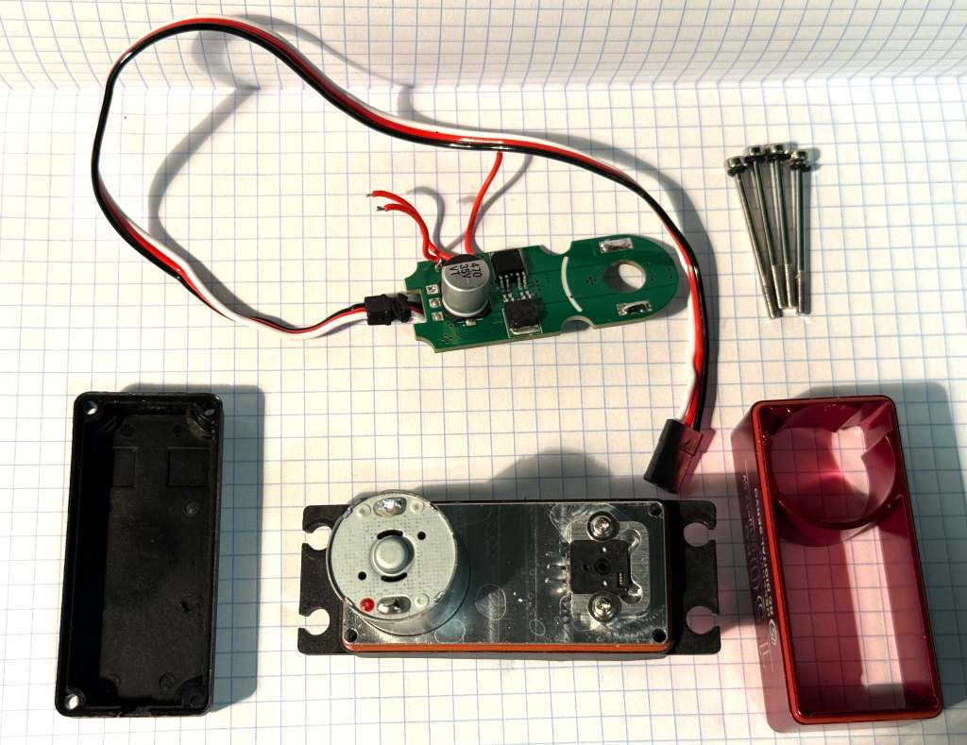
[picture p134: figure]

Note: be careful here. Try to remove it without opening the gearbox, as once the screws are unscrewed the gearbox is no longer fixed.

13

### Replace the original long screws with M2.5x8.0 screws, to fixate the gearbox again

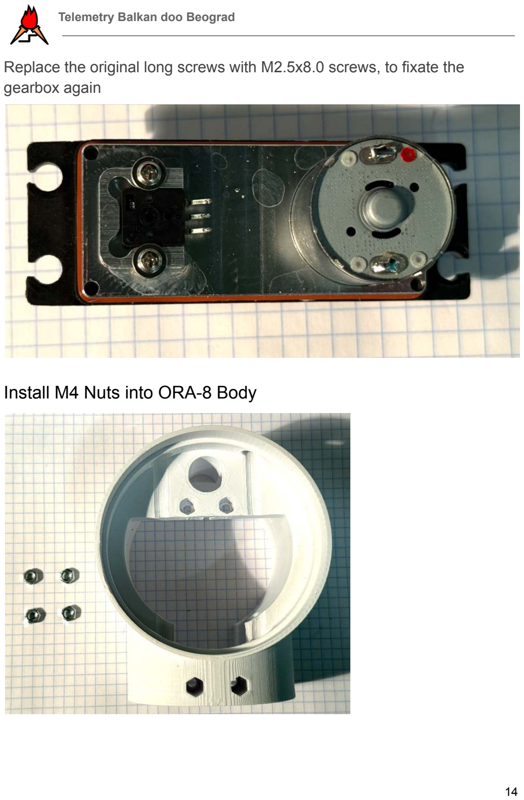
[picture p135: page 14]

## Install M4 Nuts into ORA-8 Body

14

15

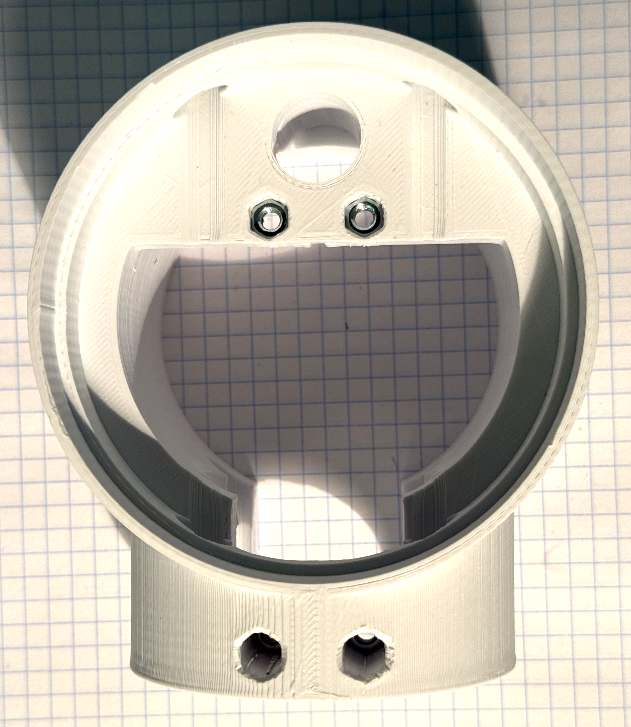
[picture p136: figure]

## Install DS51150 Into ORA-8 Body

16

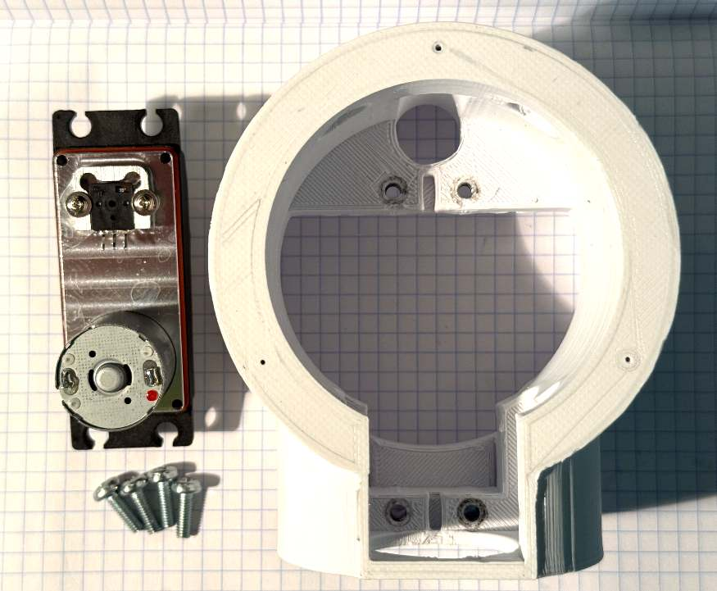
[picture p137: figure]
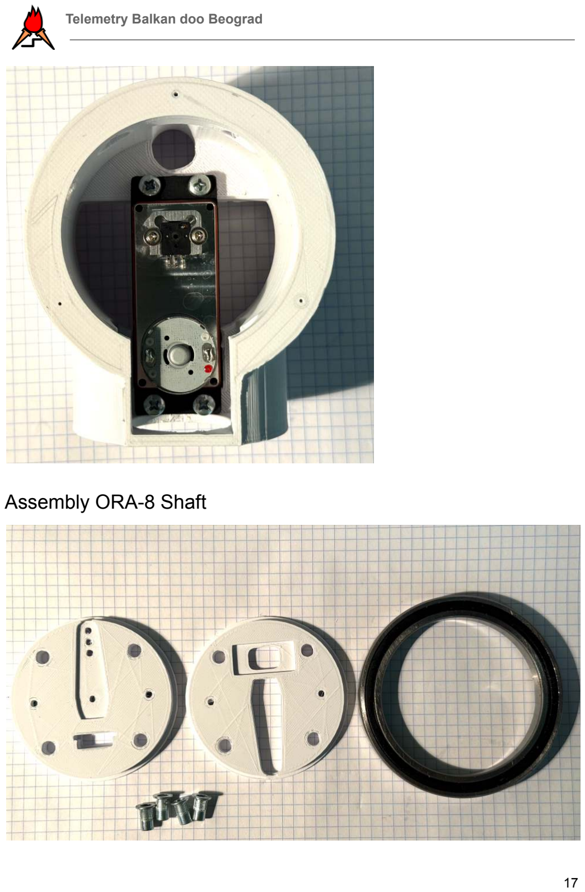
[picture p138: page 17]

## Assembly ORA-8 Shaft

17

18

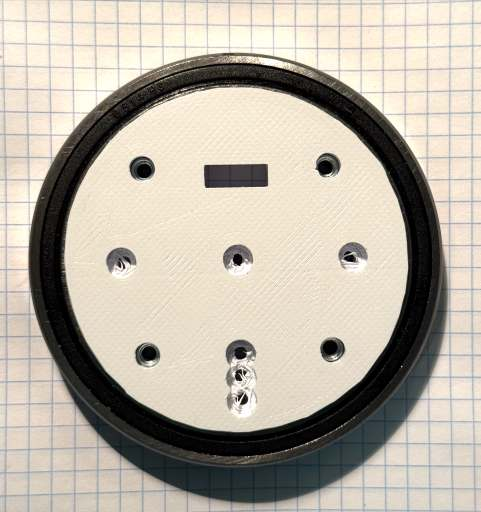
[picture p139: figure]
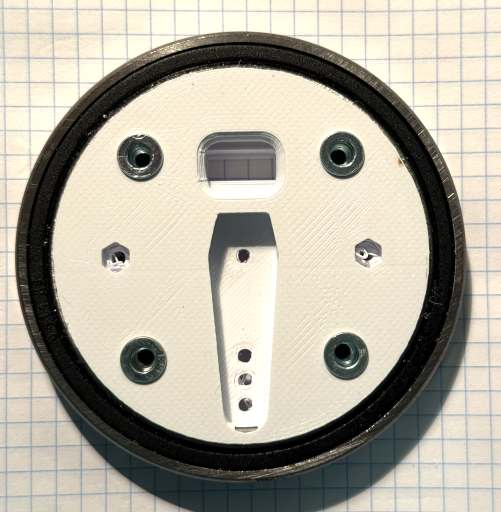
[picture p140: figure]

## Install BTS7960, JST and Address Selector into ORA-8 Lid

19

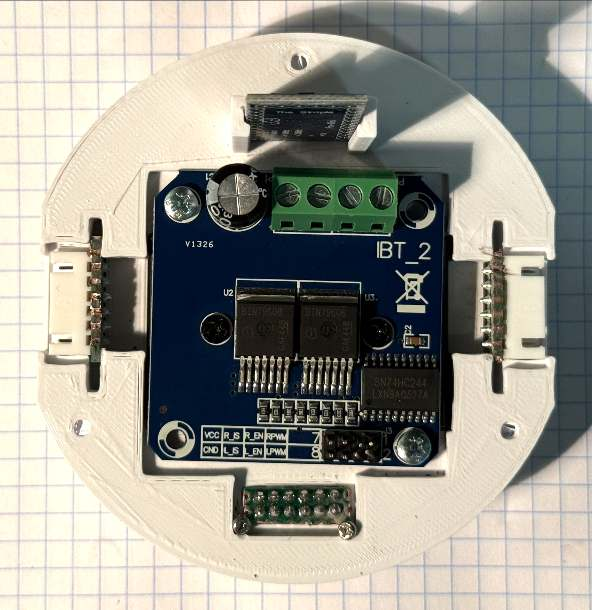
[picture p141: figure]

## Setup the Electronics

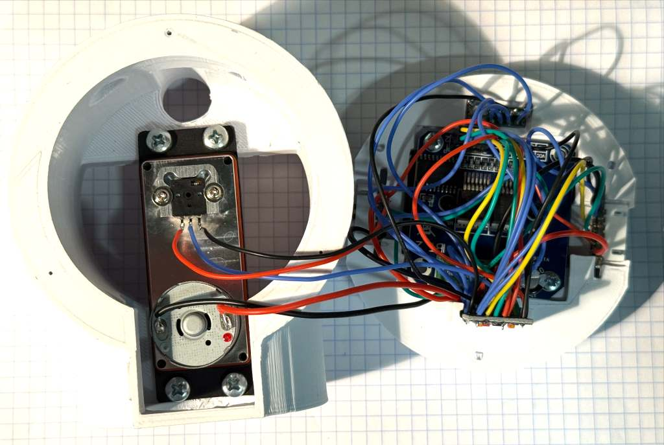
[picture p142: figure]

Follow the Electronics Assembly to setup the electronics properly.

20

## Install the wires protection tubes

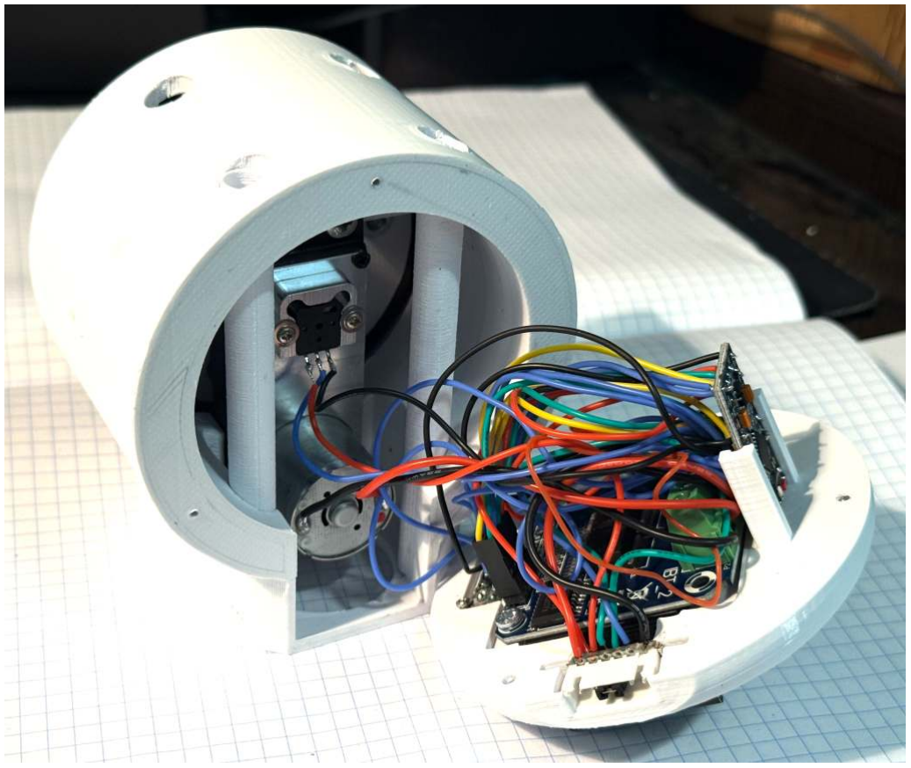
[picture p143: figure]

21

## Mount ORA-8 Lid Into ORA-8 Body

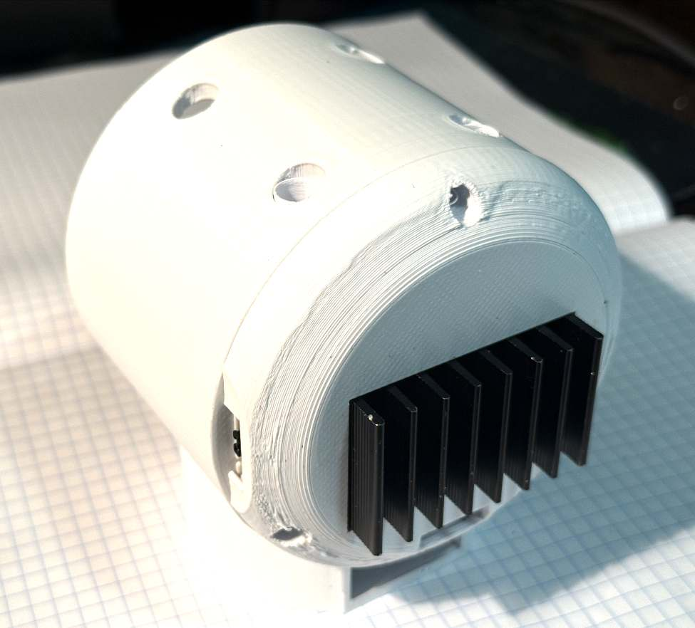
[picture p144: figure]

## Set the DS51150 into a middle position

### Connect ORA-8 to the computer

See Connecting to the Computer section for more details.

### Connect to ORA-8 via Python

from osp import OSP
ora = OSP("/dev/cu.usbserial-AI20M8EA")

22

### Set the actuator position to the middle

ora.ora_set_angle(0,8192)

## Mount 18T Arm on DS51150

23

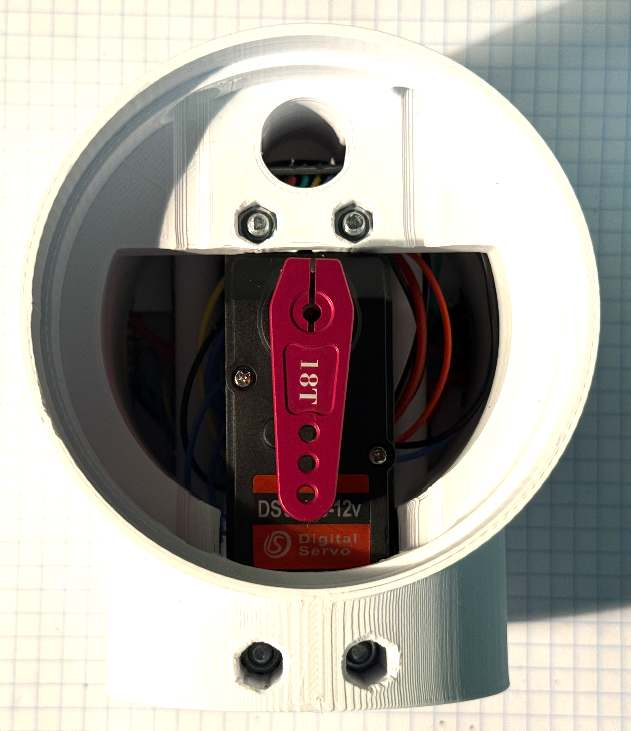
[picture p145: figure]

## Install ORA-8 Shaft into ORA-8 Body

### Push the shaft with the bearing into the body

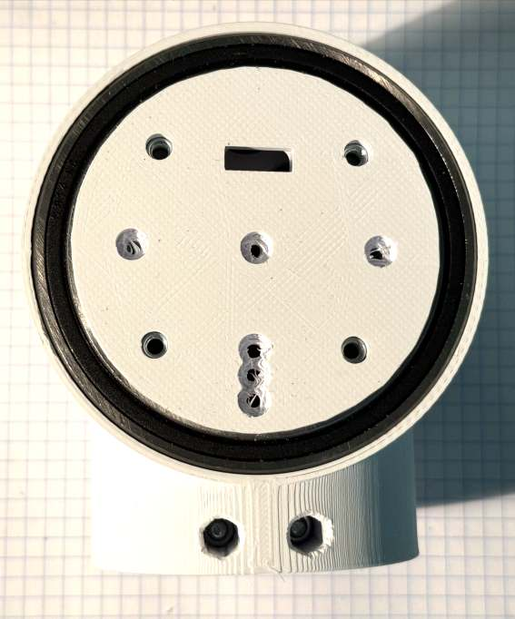
[picture p146: figure]

Advise: Optionally apply the adhesive sealant to the body where it is touching the bearing.

24

### Screw the 2 M3x12 screw with the washer and the grover washer in the middle and at the tip of the 18T arm

25

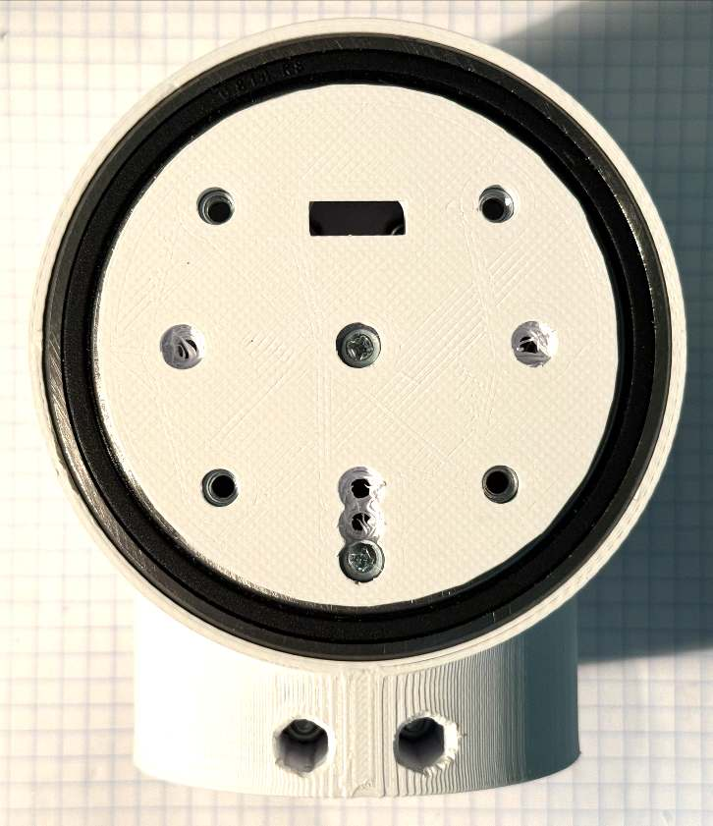
[picture p147: figure]

# 4. Electronics Assembly

## Schematics

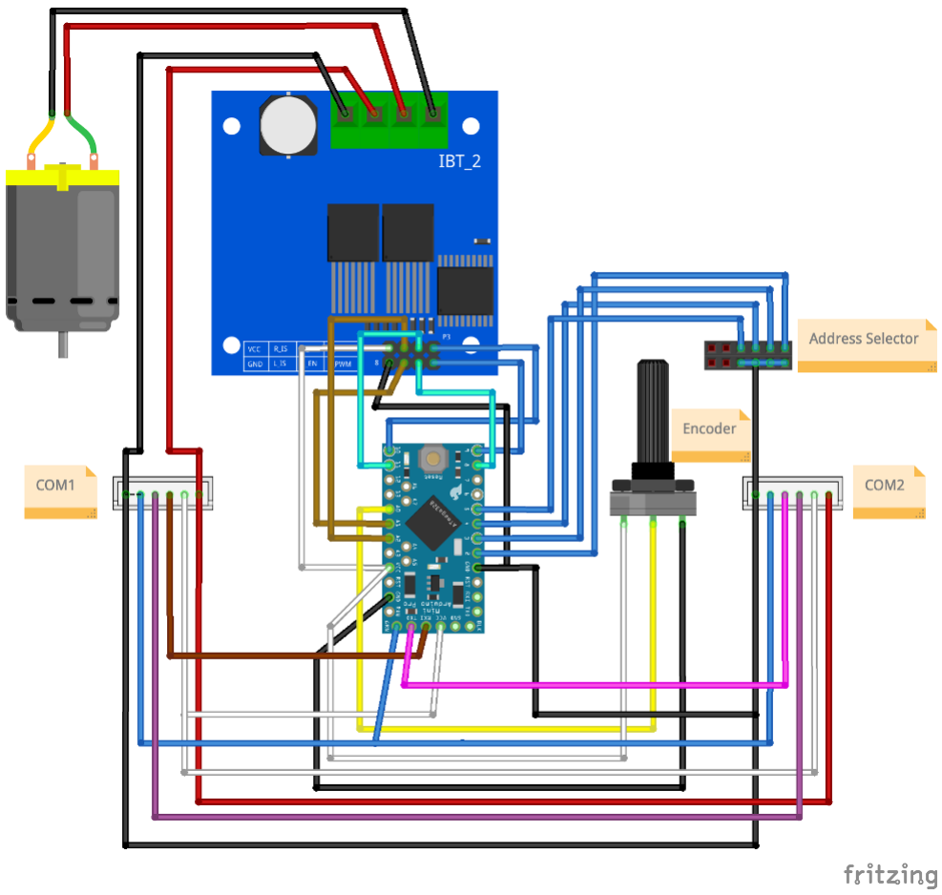
[picture p148: figure]

## DS51150 Servo Upgrade

### Encoder <-> Arduino

Encoder PIN | Arduino PIN

26

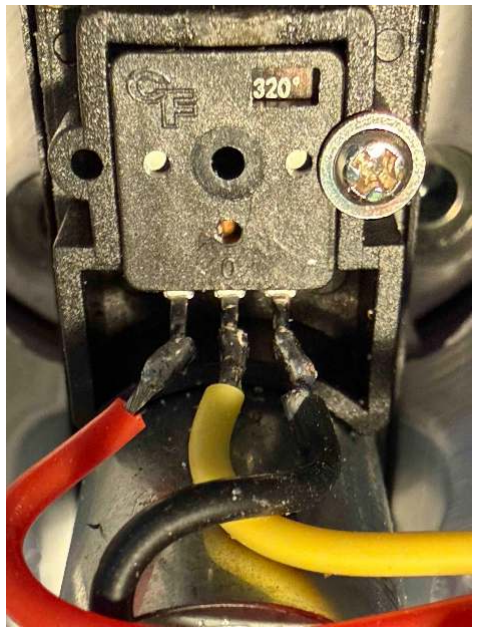
[picture p149: figure]
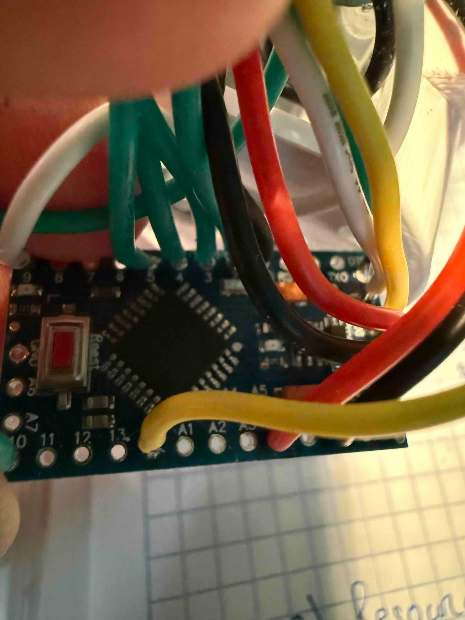
[picture p150: figure]

Right | GND
Middle | A0
Left | VCC

### Motor <-> BTS7960

Motor PIN | BTS7960 PIN
RIGHT (With RED Mark) | M+
LEFT | M-

### BTS7960 <-> Arduino

BTS7960 | Arduino PIN
PWM_L | D9

27

PWM_R | D10
L_IS | A1
R_IS | A2
L_EN | D8
R_EN | D11
VCC | VCC
GND | GND

## Interfaces

### COM1 (Left)

Pinout
PIN0 | PIN1 | PIN2 | PIN3 | PIN4 | PIN5
GND | DTR Connected to Arduino DTR | TX Connected to COM2 RX | RX Connected To Arduino RX | Ctrl Power +5V | Motor Power +8.4 V or +12.0 V

JST LOCK HERE

PCB
Size: 20x8

### COM2 (Right)

PIN0 | PIN1 | PIN2 | PIN3 | PIN4 | PIN5
GND | DTR Connected to Arduino DTR | TX Connected to Arduino TX | RX Connected to COM1 TX | Ctrl Power +5V | Motor Power +8.4 V +12.0 V

JST LOCK HERE

28

### Address Selector

Pinout

PIN 0 | PIN 2 | PIN4 | PIN6 | PIN8 | PIN10
reserved | reserved | ADR3 (Ard D5) | ADR2 (Ard D4) | ADR1 (Ard D3) | ADR0 (Ard D2)
reserved | reserved | GND | GND | GND | GND
PIN1 | PIN3 | PIN5 | PIN7 | PIN9 | PIN11

PCB
Size: 18x8

# 5. Connecting to the Computer

## OSP Controller

OSP Controller allows to connect the OSP-enabled devices like ORA-series actuators to the computer via USB port and to supply the power to those devices. The detailed information about the controller specs and the assembly instructions are available in OSP-Controller Assembly Manua available on ThingVerse:

https://www.thingiverse.com/thing:7339429/files

## Connection Cable

The OSP connection cable is JST XH Male <-> JST XH Male 6 wires cable.

29

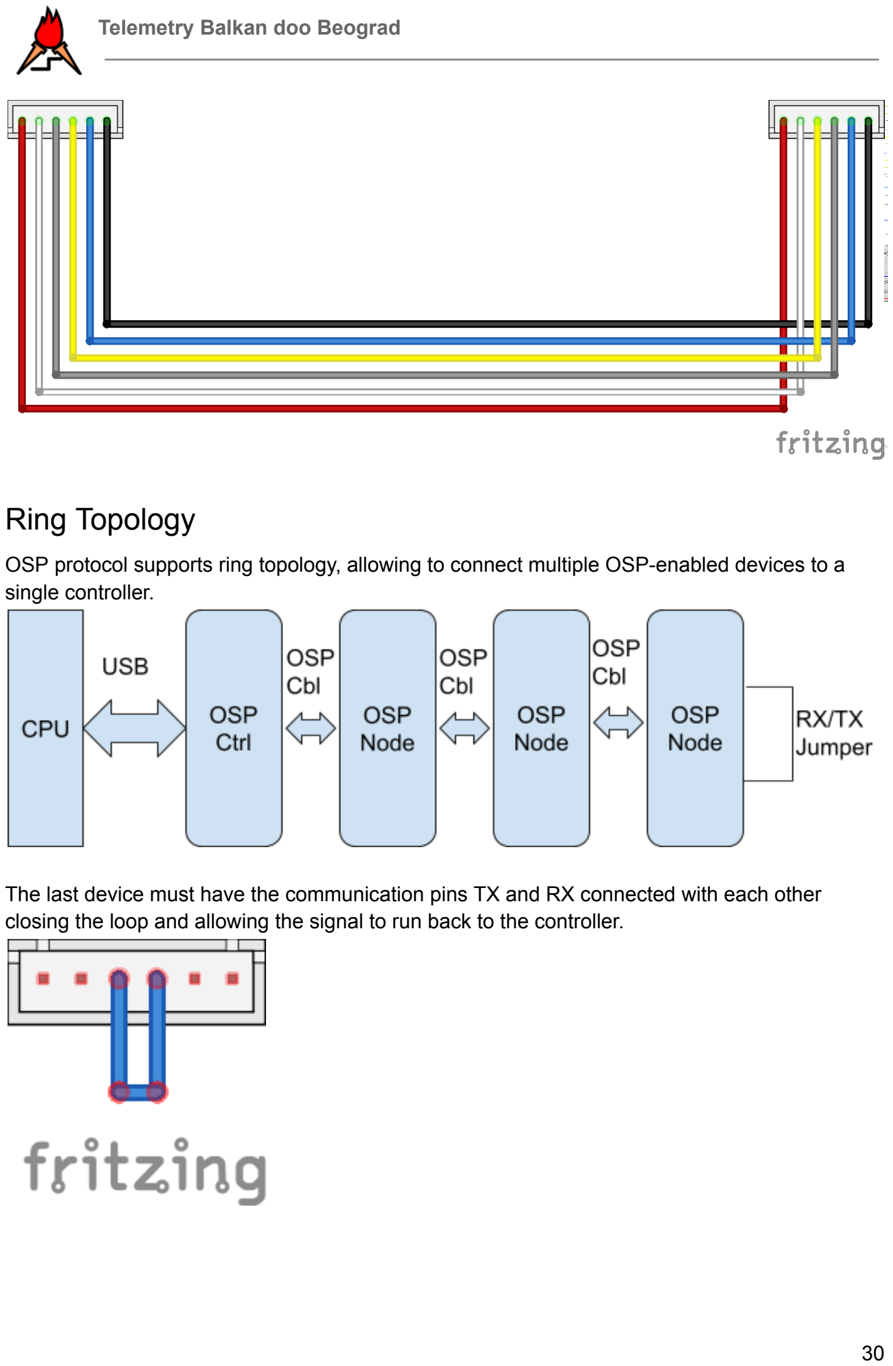
[picture p151: page 30]

## Ring Topology

OSP protocol supports ring topology, allowing to connect multiple OSP-enabled devices to a single controller.

The last device must have the communication pins TX and RX connected with each other closing the loop and allowing the signal to run back to the controller.

30

# 6. Software

## Communication Protocol

To control the ORA series actuators the OSP protocol is used. The documentation on this protocol is available at Telemetry Balkan doo website: https://www.telemetrybalkan.com/content/files/2023/02/Open-Serial-Peripheral.-Communication-Protocol.pdf (https://www.telemetrybalkan.com/content/files/2023/02/Open-Serial-Peripheral.-Communication-Protocol.pdf)

## Arduino Firmware

Arduino firmware is available in ORA actuator repository in the src/arduino folder: https://github.com/sergei-nntu/ora/tree/main/src/arduino/sa

## Python SDK

Python SDK with the code examples is available at src/python folder of ORA actuator repository:
https://github.com/sergei-nntu/ora/tree/main/src/python

## Programming Example

### Control the actuator angle

from osp import OSP

ora = OSP("/dev/cu.usbserial-A50285BI") ora.ora_set_angle(0, 5000) # params (address, angle)

# 7. Conclusion

This document has walked the reader through the complete process of building the ORA-8 actuator, covering all essential aspects from mechanical preparation and hardware modification to electronics integration and software control. By following the outlined steps, the reader gains not only a working actuator but also a clear understanding of how each subsystem contributes to the overall functionality.

In particular, the manual demonstrated:

- How to modify a standard DS51150 servo into a controllable actuator platform
- How to assemble the mechanical structure using 3D-printed and standard components

31

- How to wire and integrate the electronics, including the Arduino controller, encoder, and motor driver
- How to interface the actuator using the OSP protocol and control it programmatically via Python
- How to connect multiple actuators in a scalable ring topology system

Beyond simple assembly instructions, this document provides insight into the design philosophy of the ORA system—modularity, extensibility, and openness. The reader is equipped not only to reproduce the ORA-8 actuator but also to modify, extend, and integrate it into more complex robotic applications.

The ORA-8 serves as a foundation for building distributed robotic systems, and this manual establishes the necessary knowledge to confidently work with both the hardware and software components of the platform.

32
