sergei-nntu/ora/ora-7/Assembly Manual/SelfTappingScrew.png

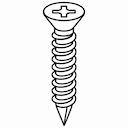
ora-7/Assembly Manual/SelfTappingScrew.png
