sergei-nntu/ora/ora-2/ORA-2 Isometry.pdf

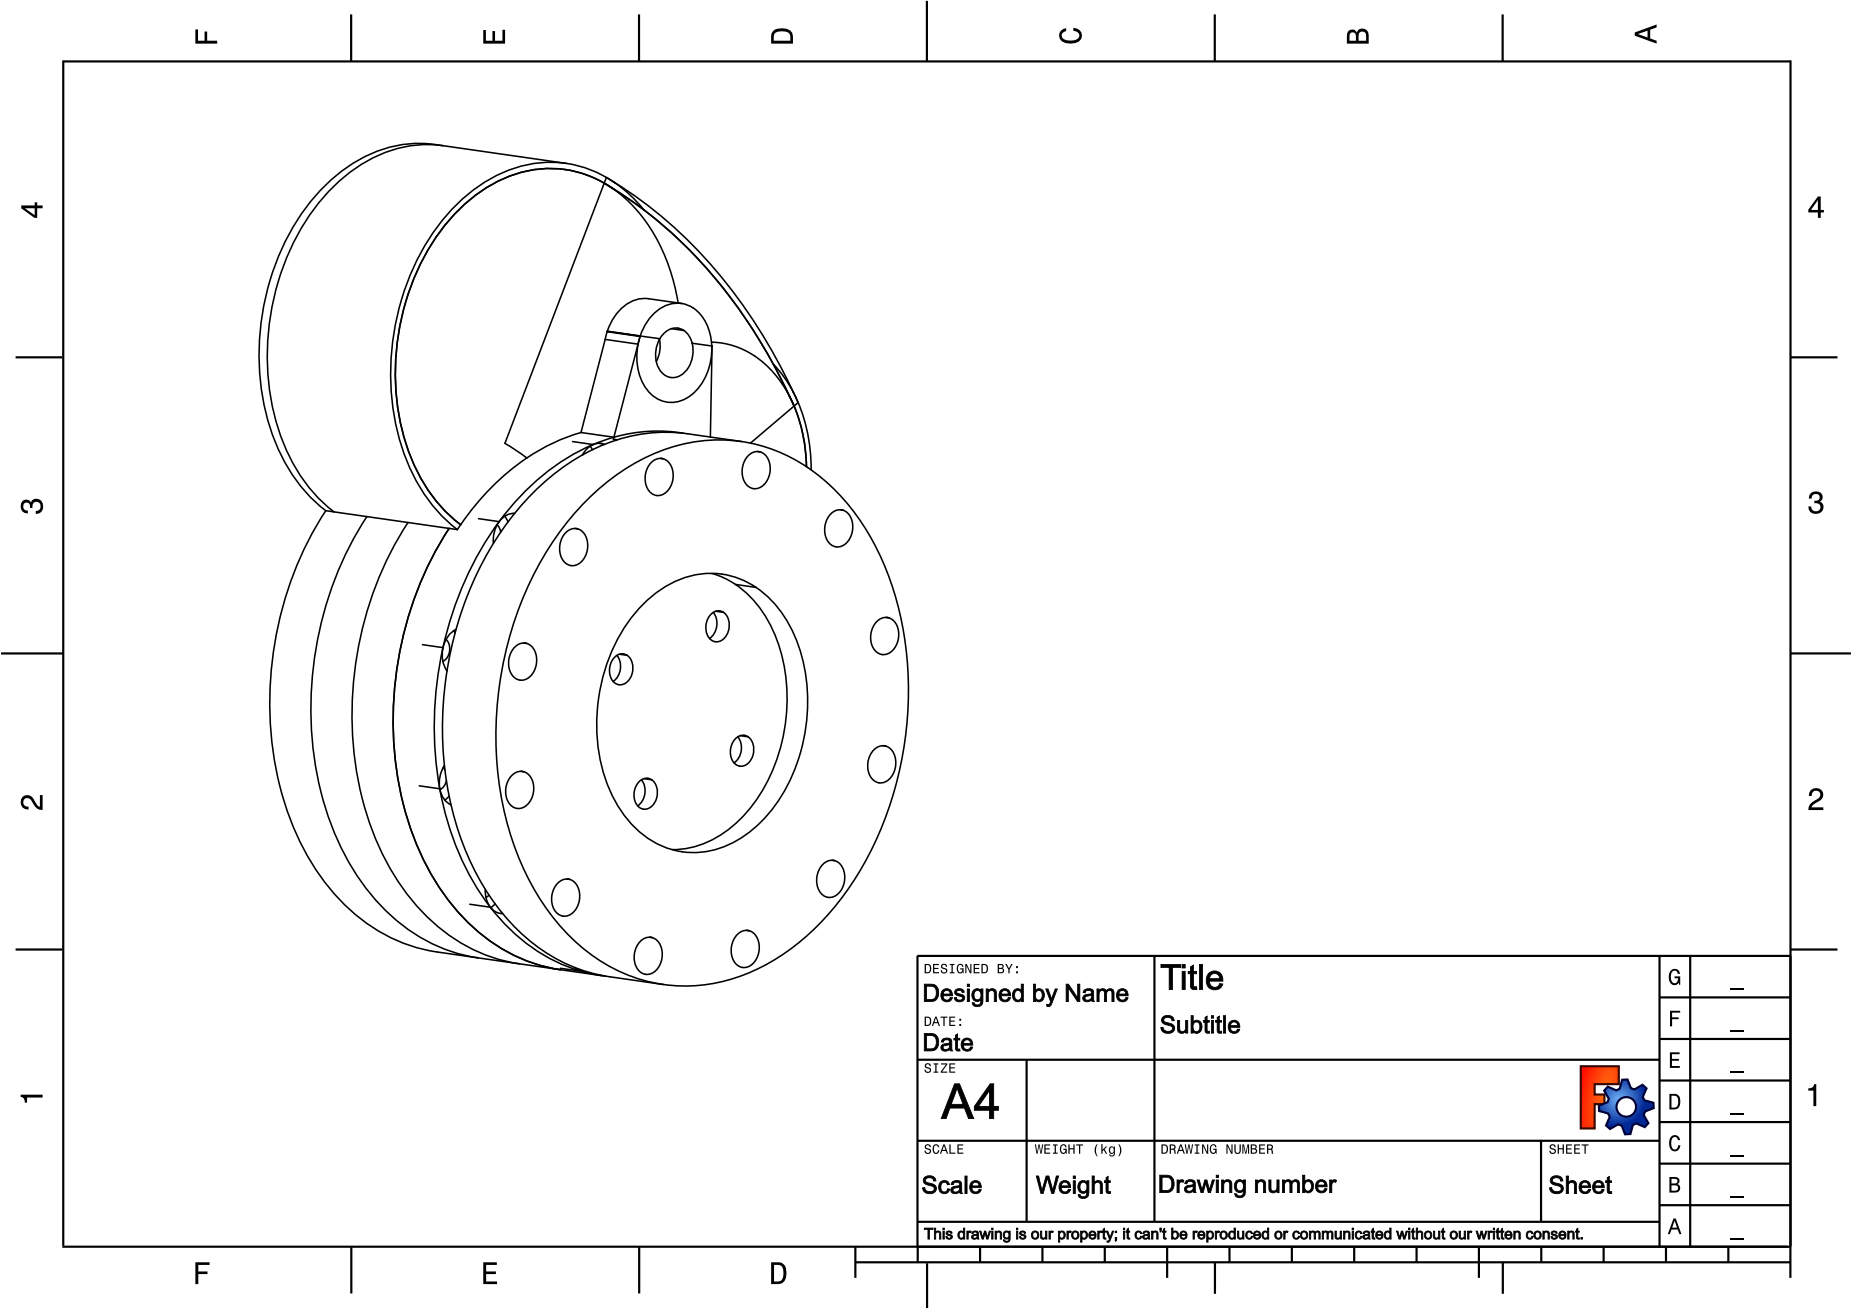
[picture p153: page 1]
