sergei-nntu/ora/ora-3/ORA-3 Tech Draw.pdf

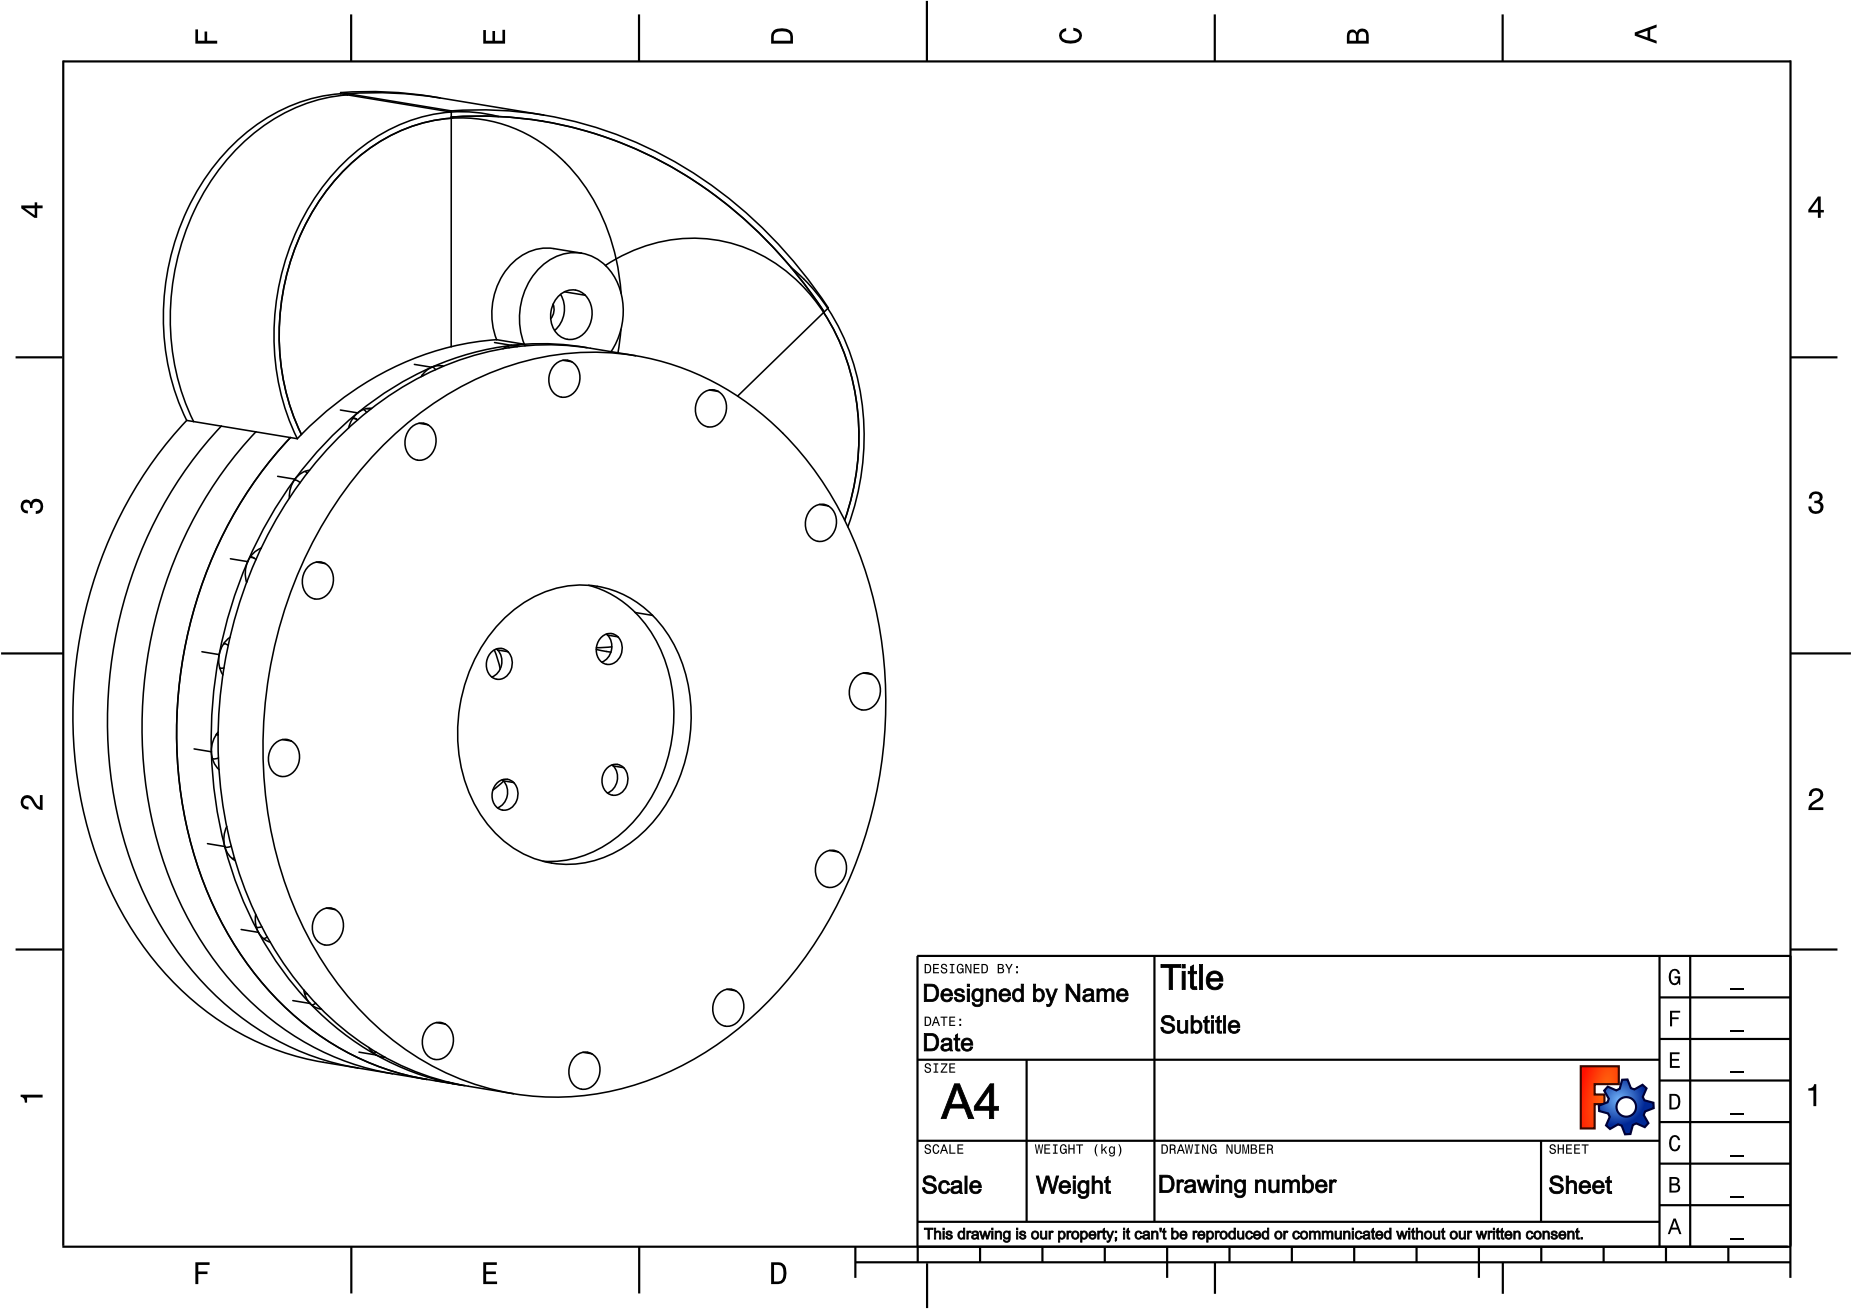
[picture p154: page 1]
