sergei-nntu/ora/ora-7/Assembly Manual/ORA-7 Body.pdf

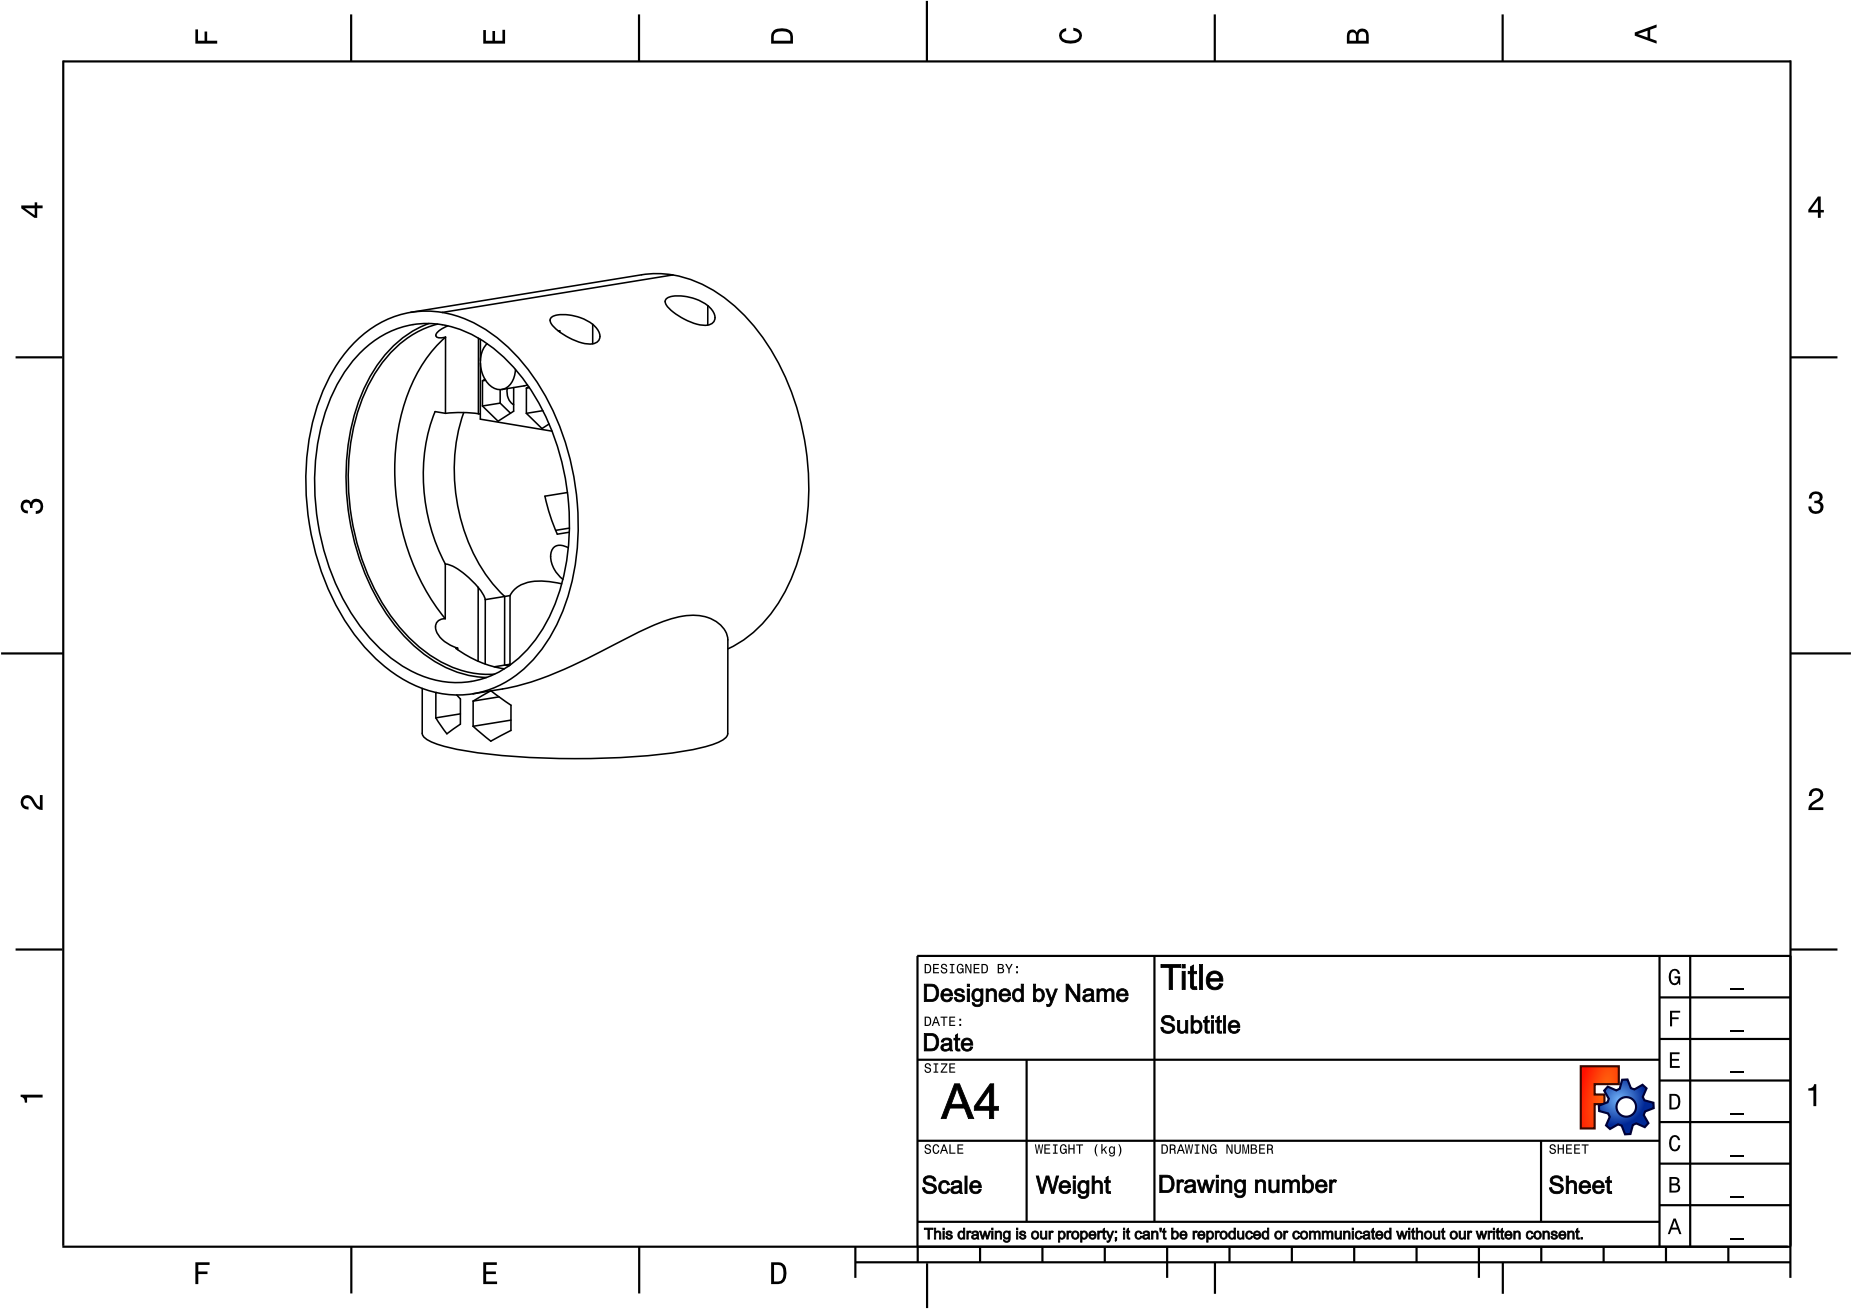
[picture p155: page 1]
