sergei-nntu/ora/ora-7/Assembly Manual/ORA-7 Lid, Weapon and Holder.pdf

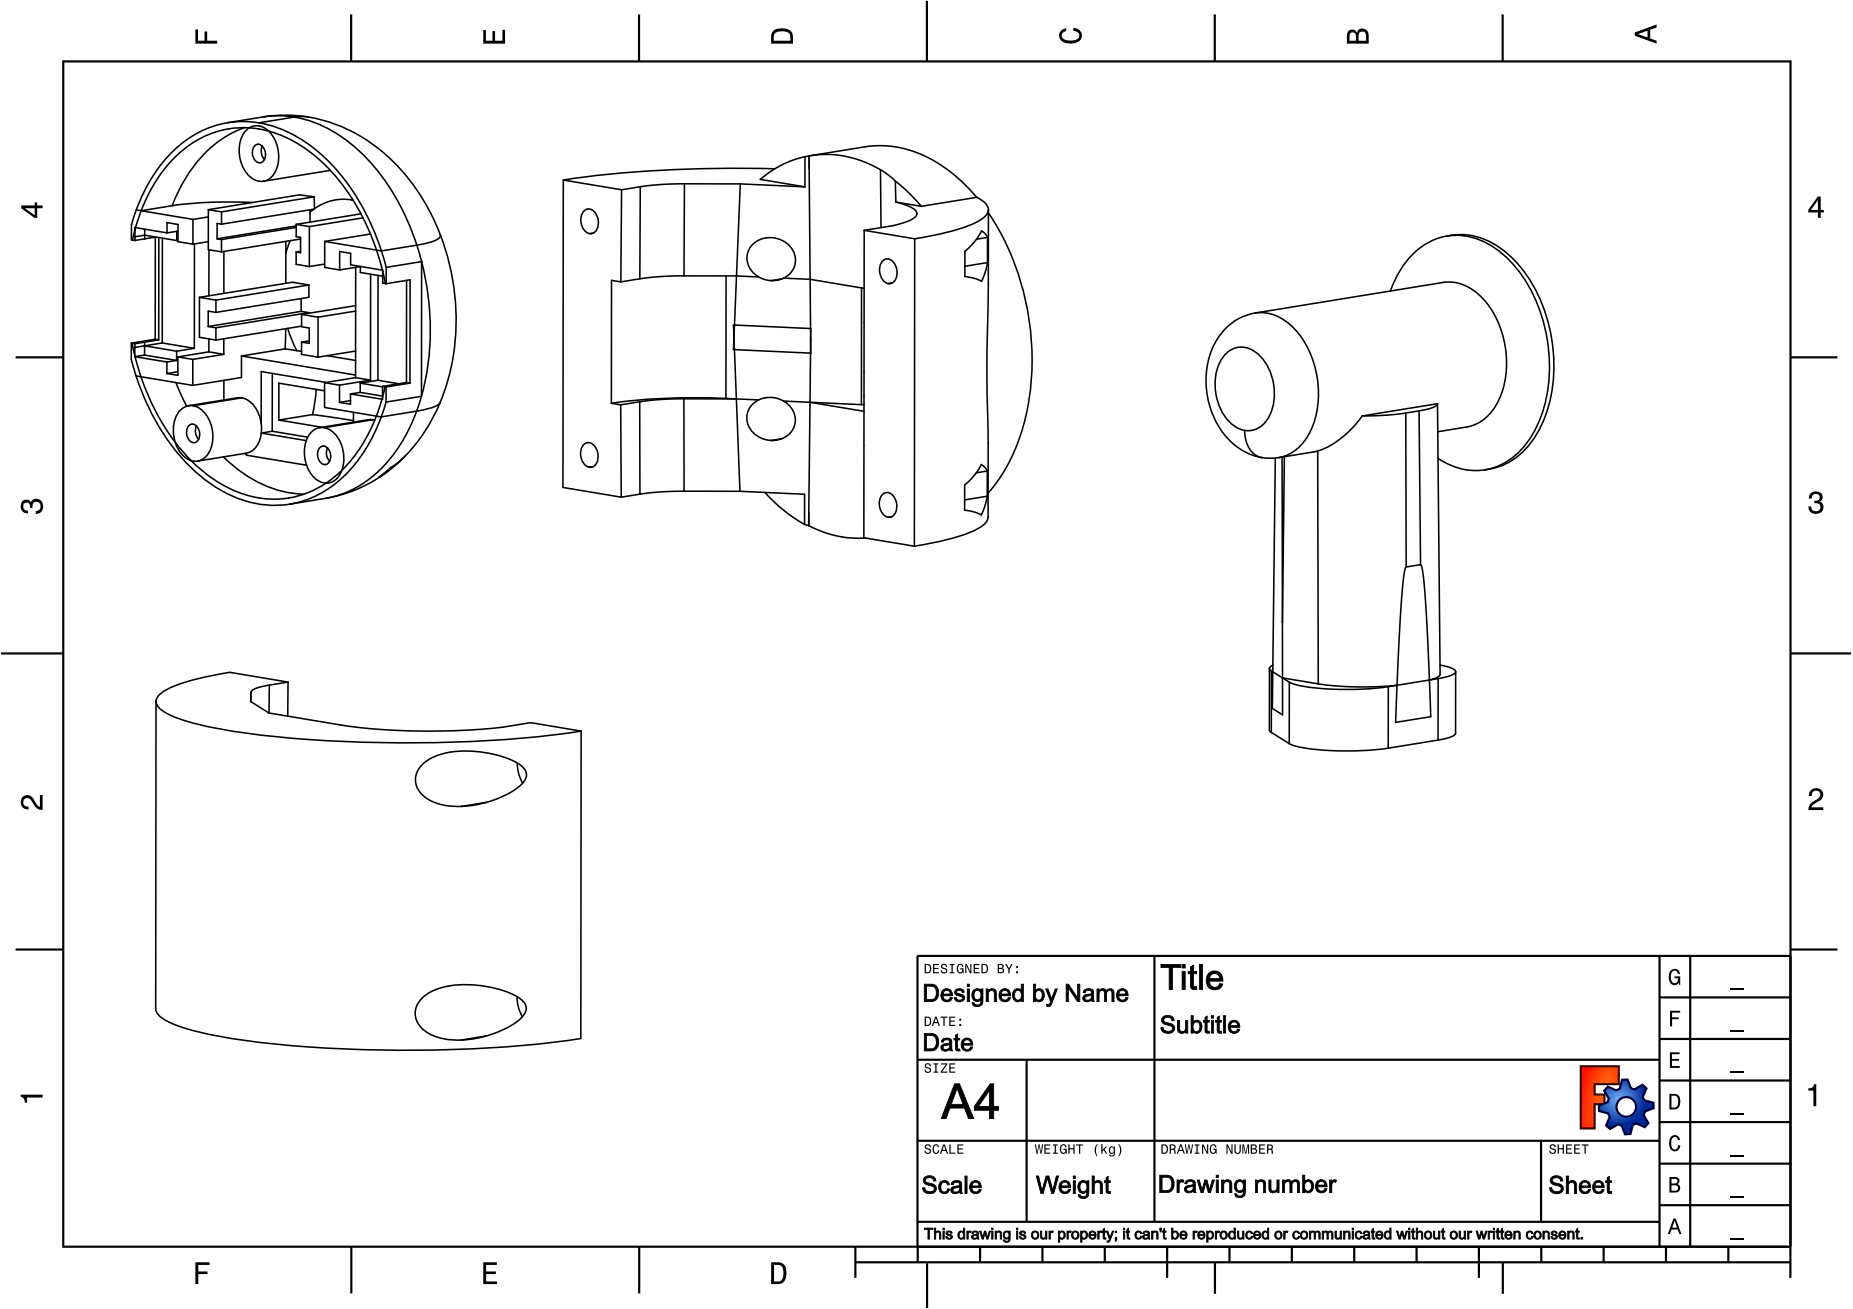
[picture p156: page 1]
