sergei-nntu/ora/ora-7/Assembly Manual/ORA-7 M4 Nuts Insertion.pdf

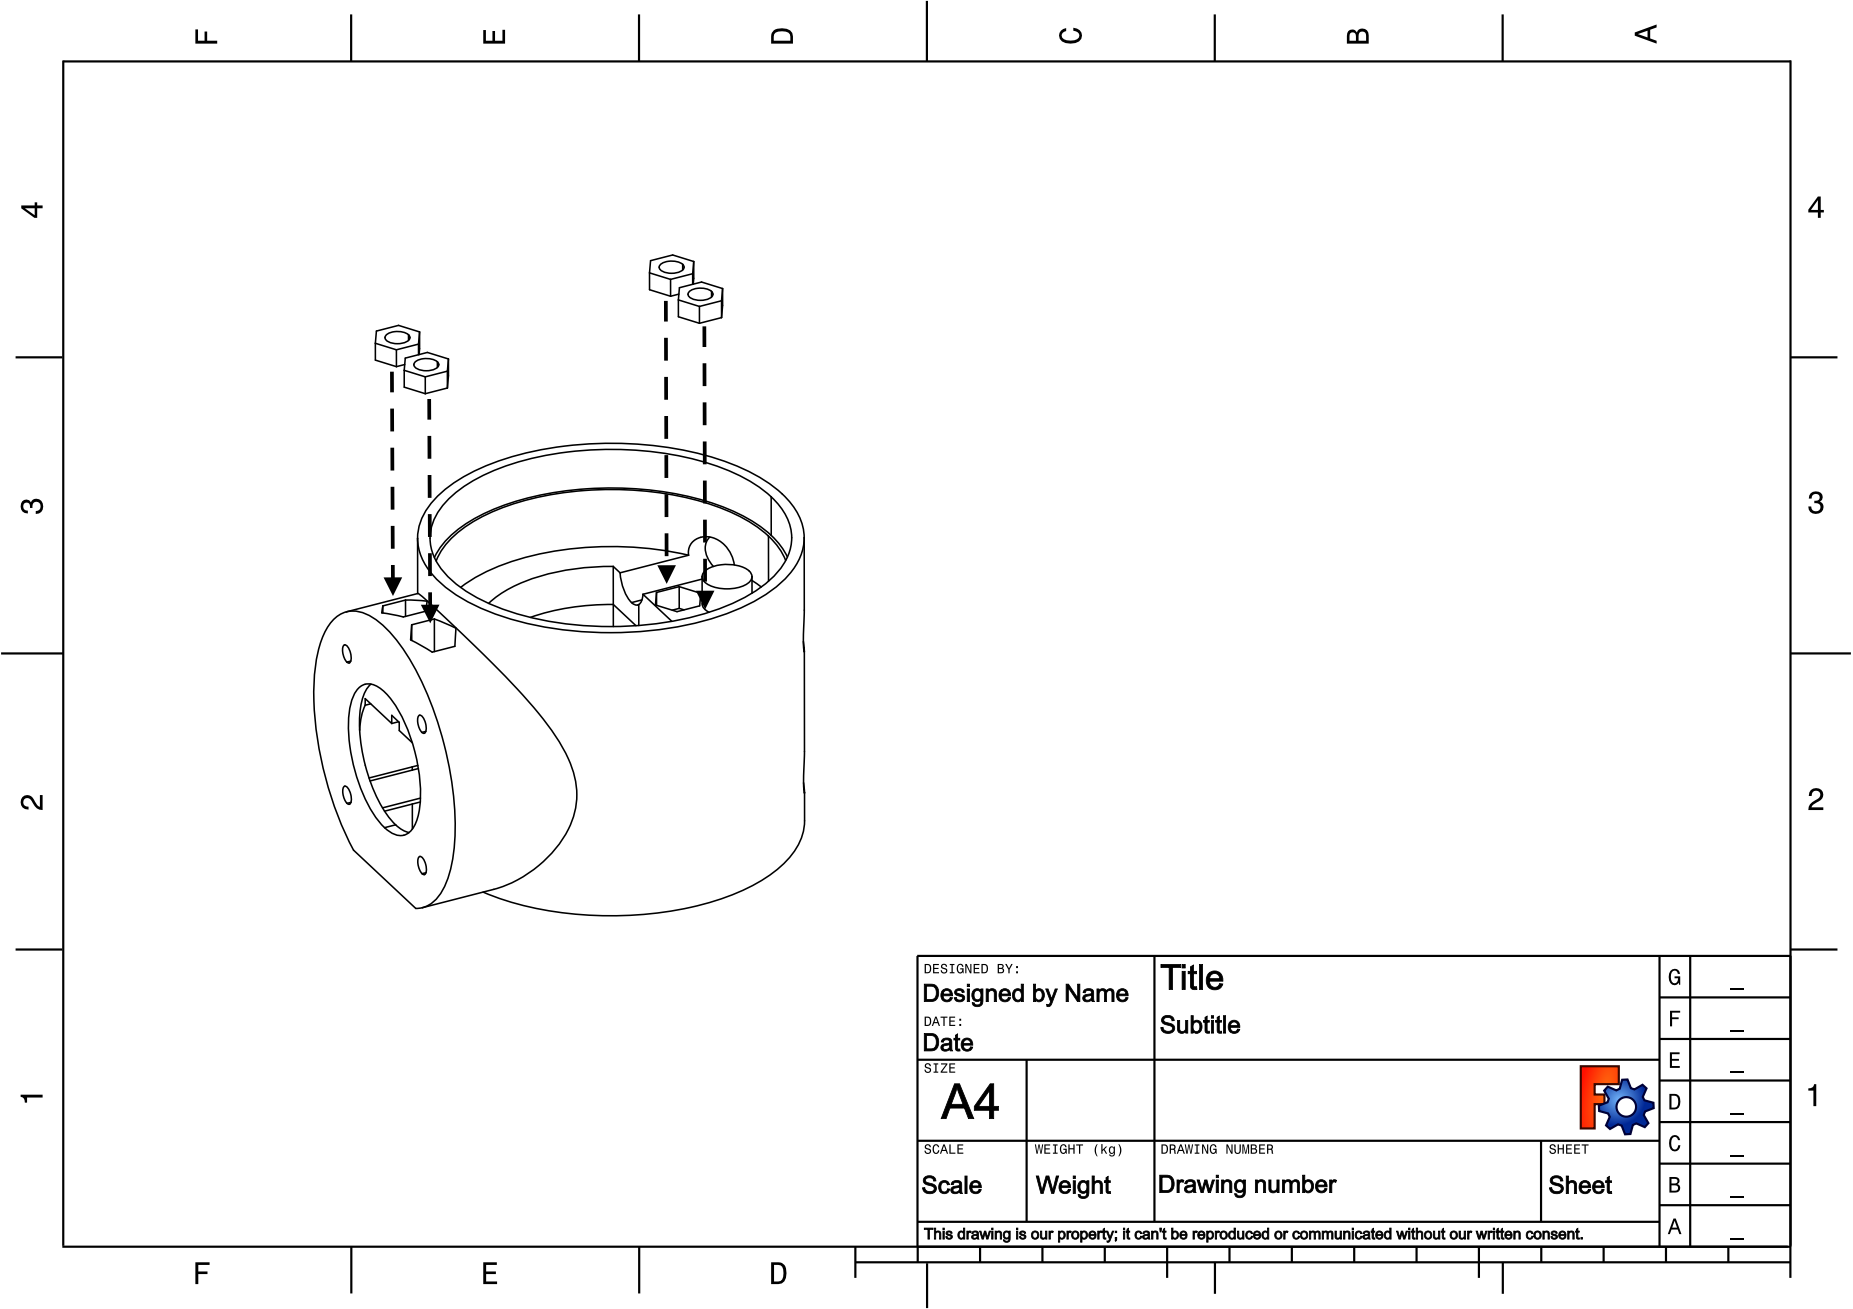
[picture p157: page 1]
