sergei-nntu/ora/ora-7/Assembly Manual/ORA-7 M4 Nuts Into Weapon Holder.pdf

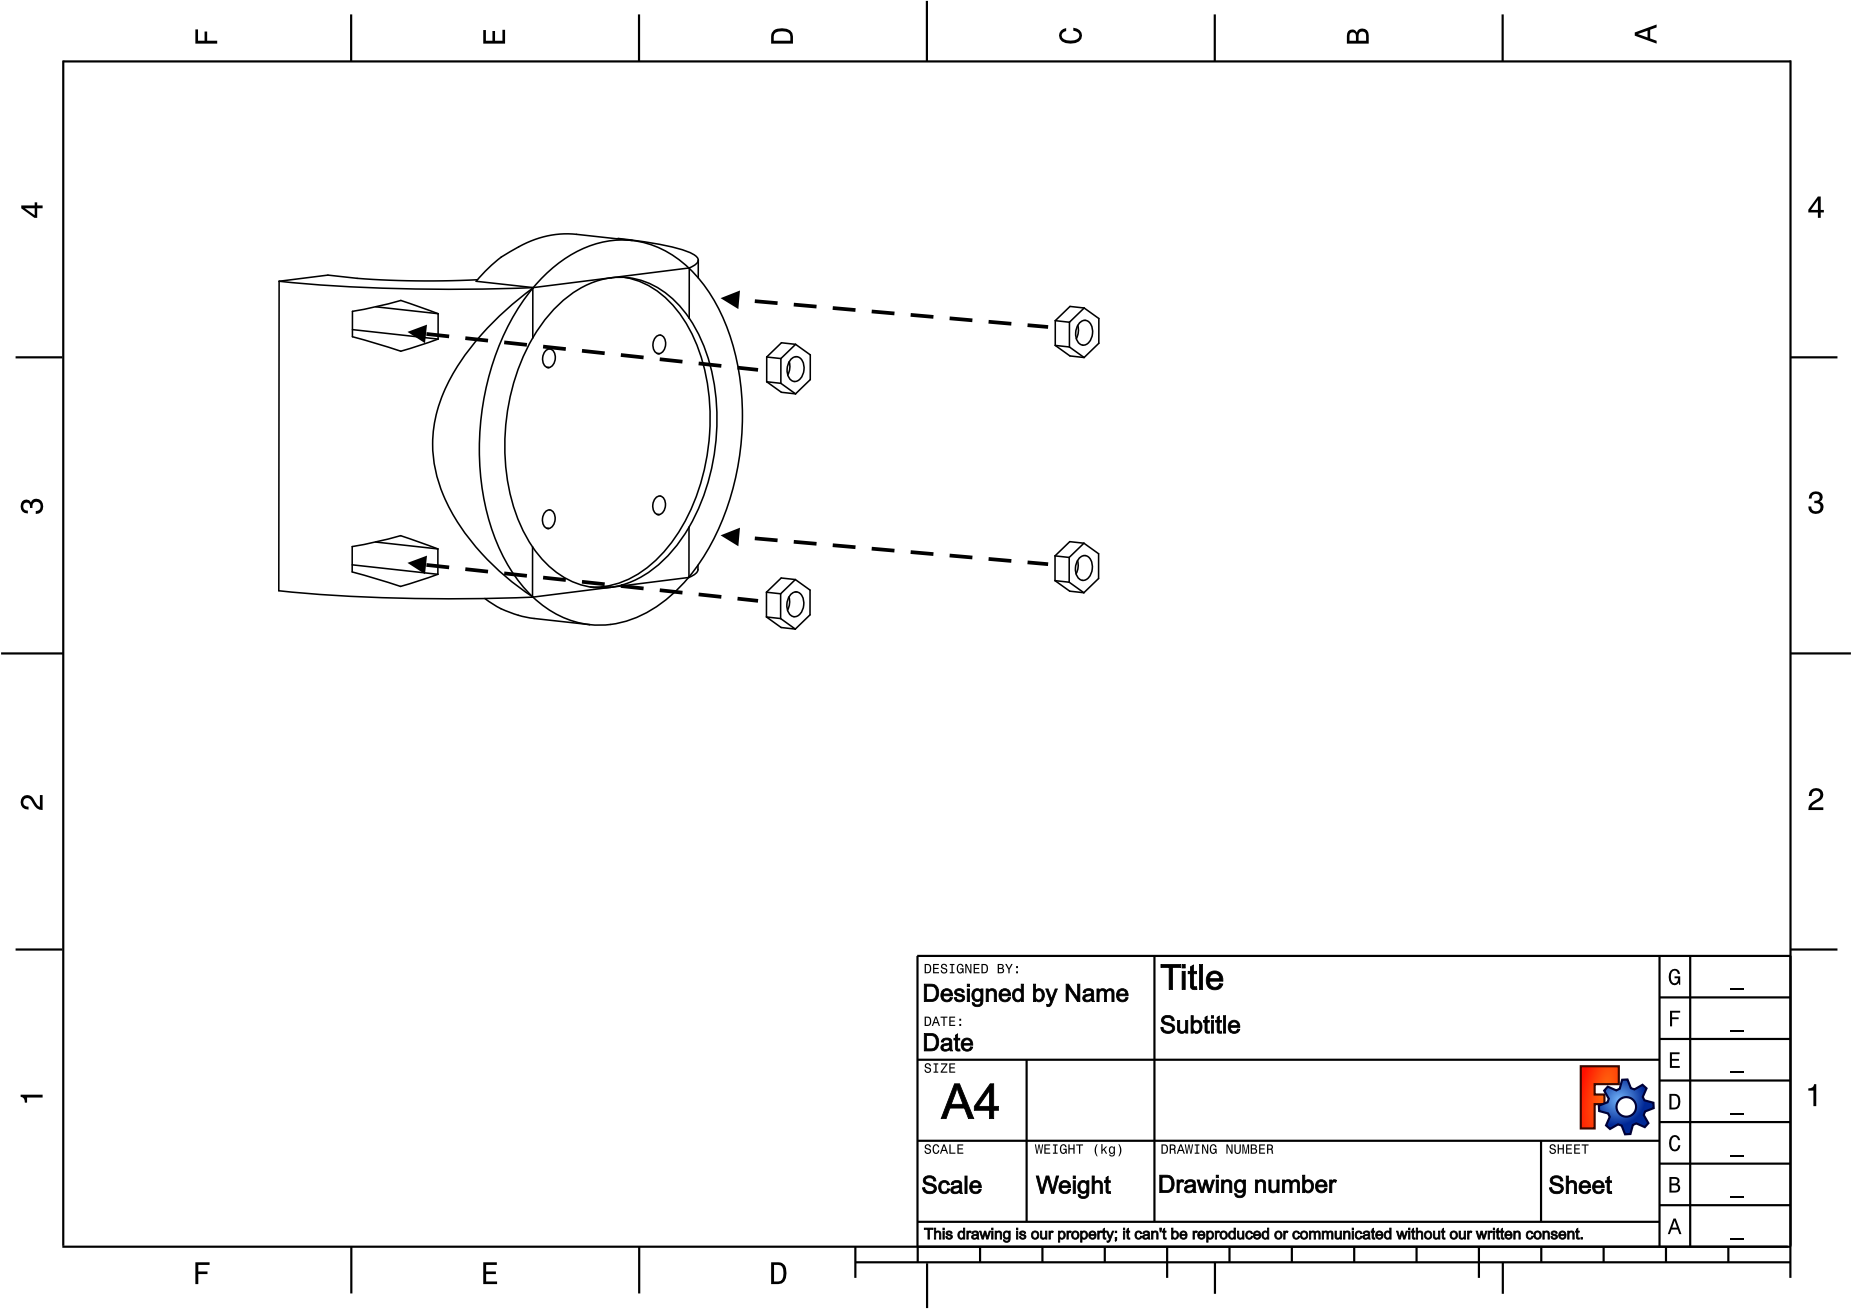
[picture p158: page 1]
