sergei-nntu/ora/ora-7/Assembly Manual/ORA-7 Shaft 2.pdf

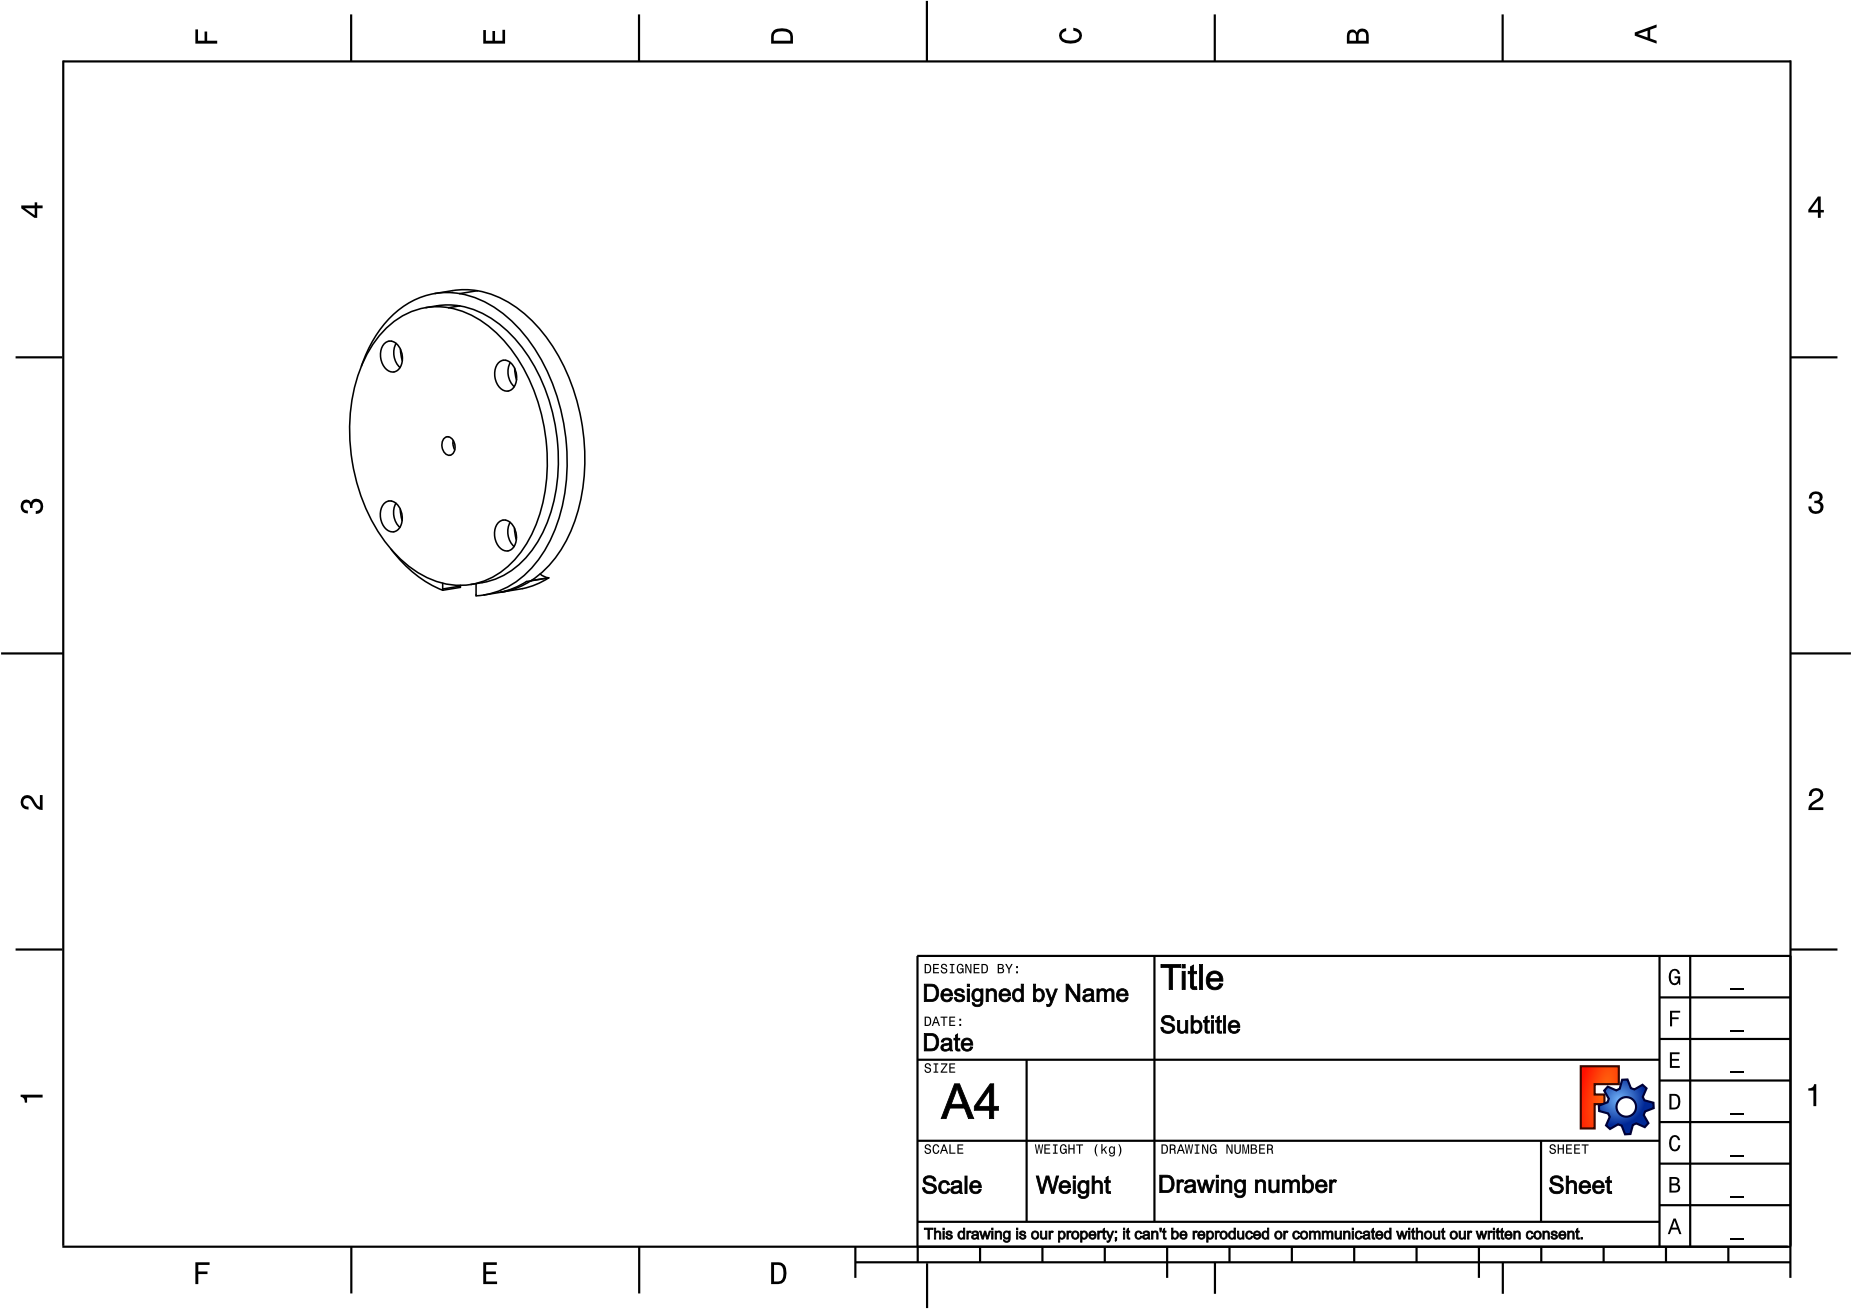
[picture p159: page 1]
