sergei-nntu/ora/ora-7/Assembly Manual/ORA-7 Shaft Assembly.pdf

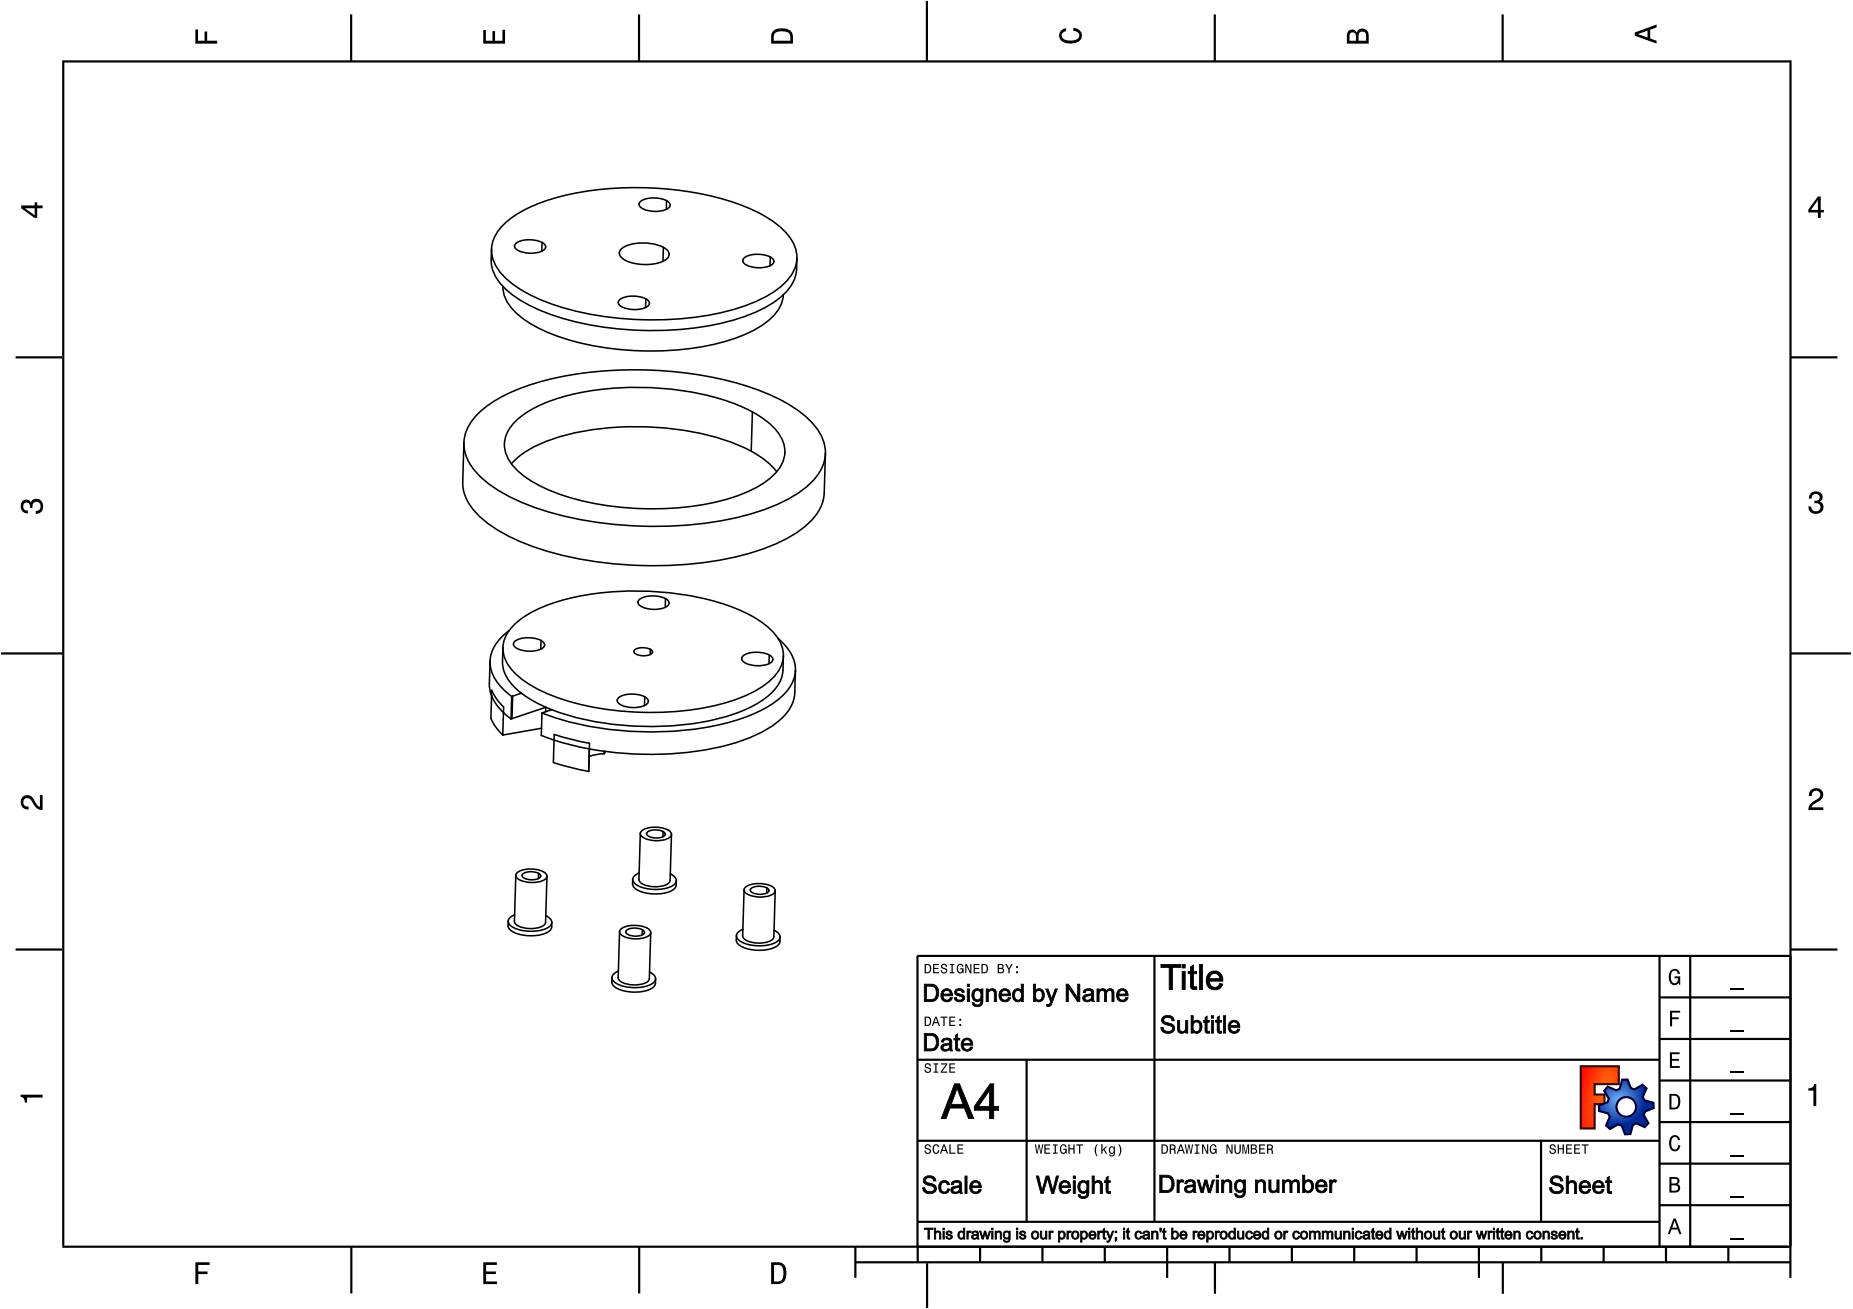
[picture p160: page 1]
