sergei-nntu/ora/ora-7/Assembly Manual/ORA-7 Shaft.pdf

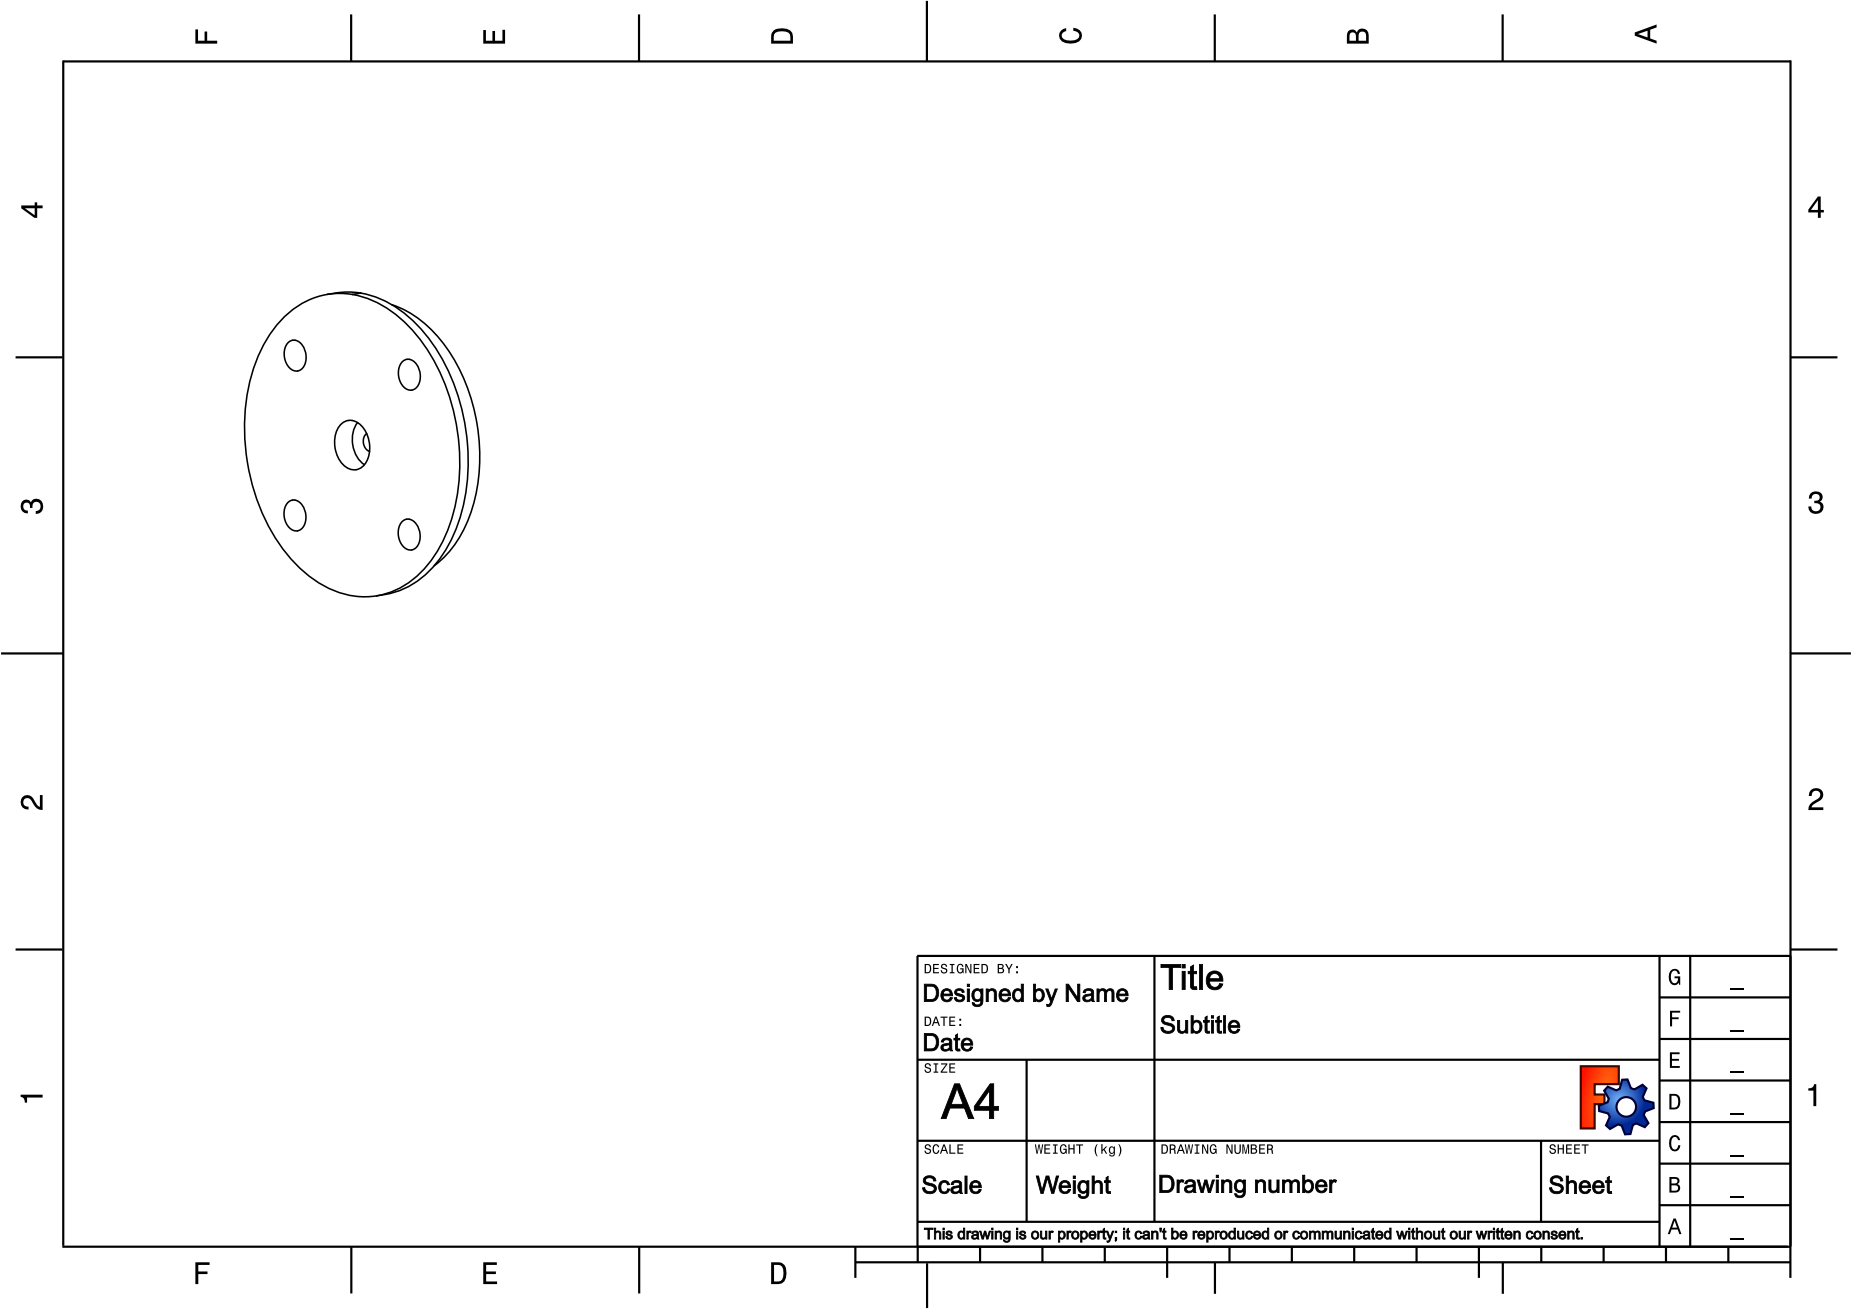
[picture p161: page 1]
