sergei-nntu/ora/ora-7/Assembly Manual/ORA-7. Install Weapon On Platform.pdf

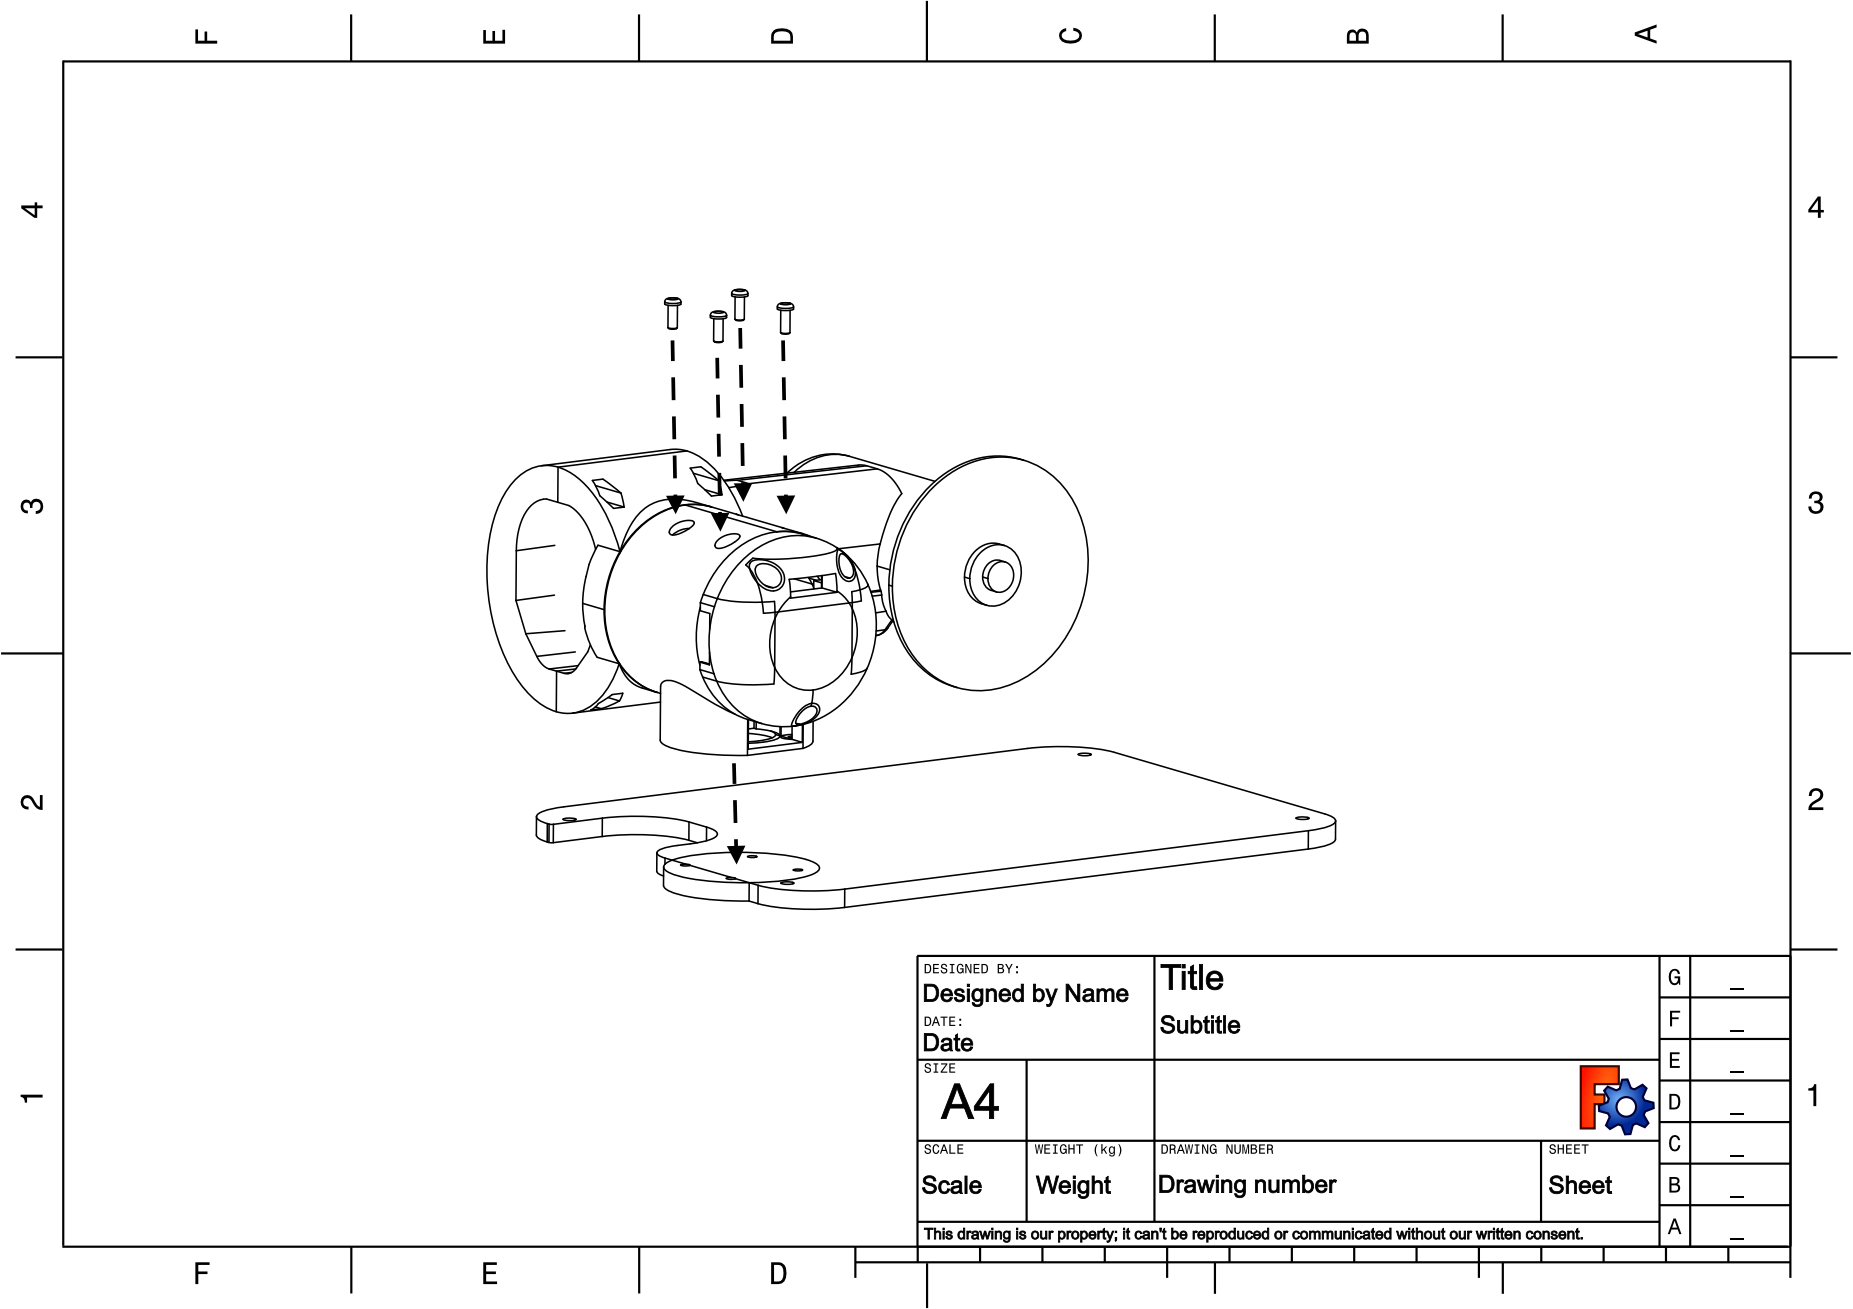
[picture p162: page 1]
