sergei-nntu/ora/ora-7/Assembly Manual/ORA-7. Install Weapon With Platform.pdf

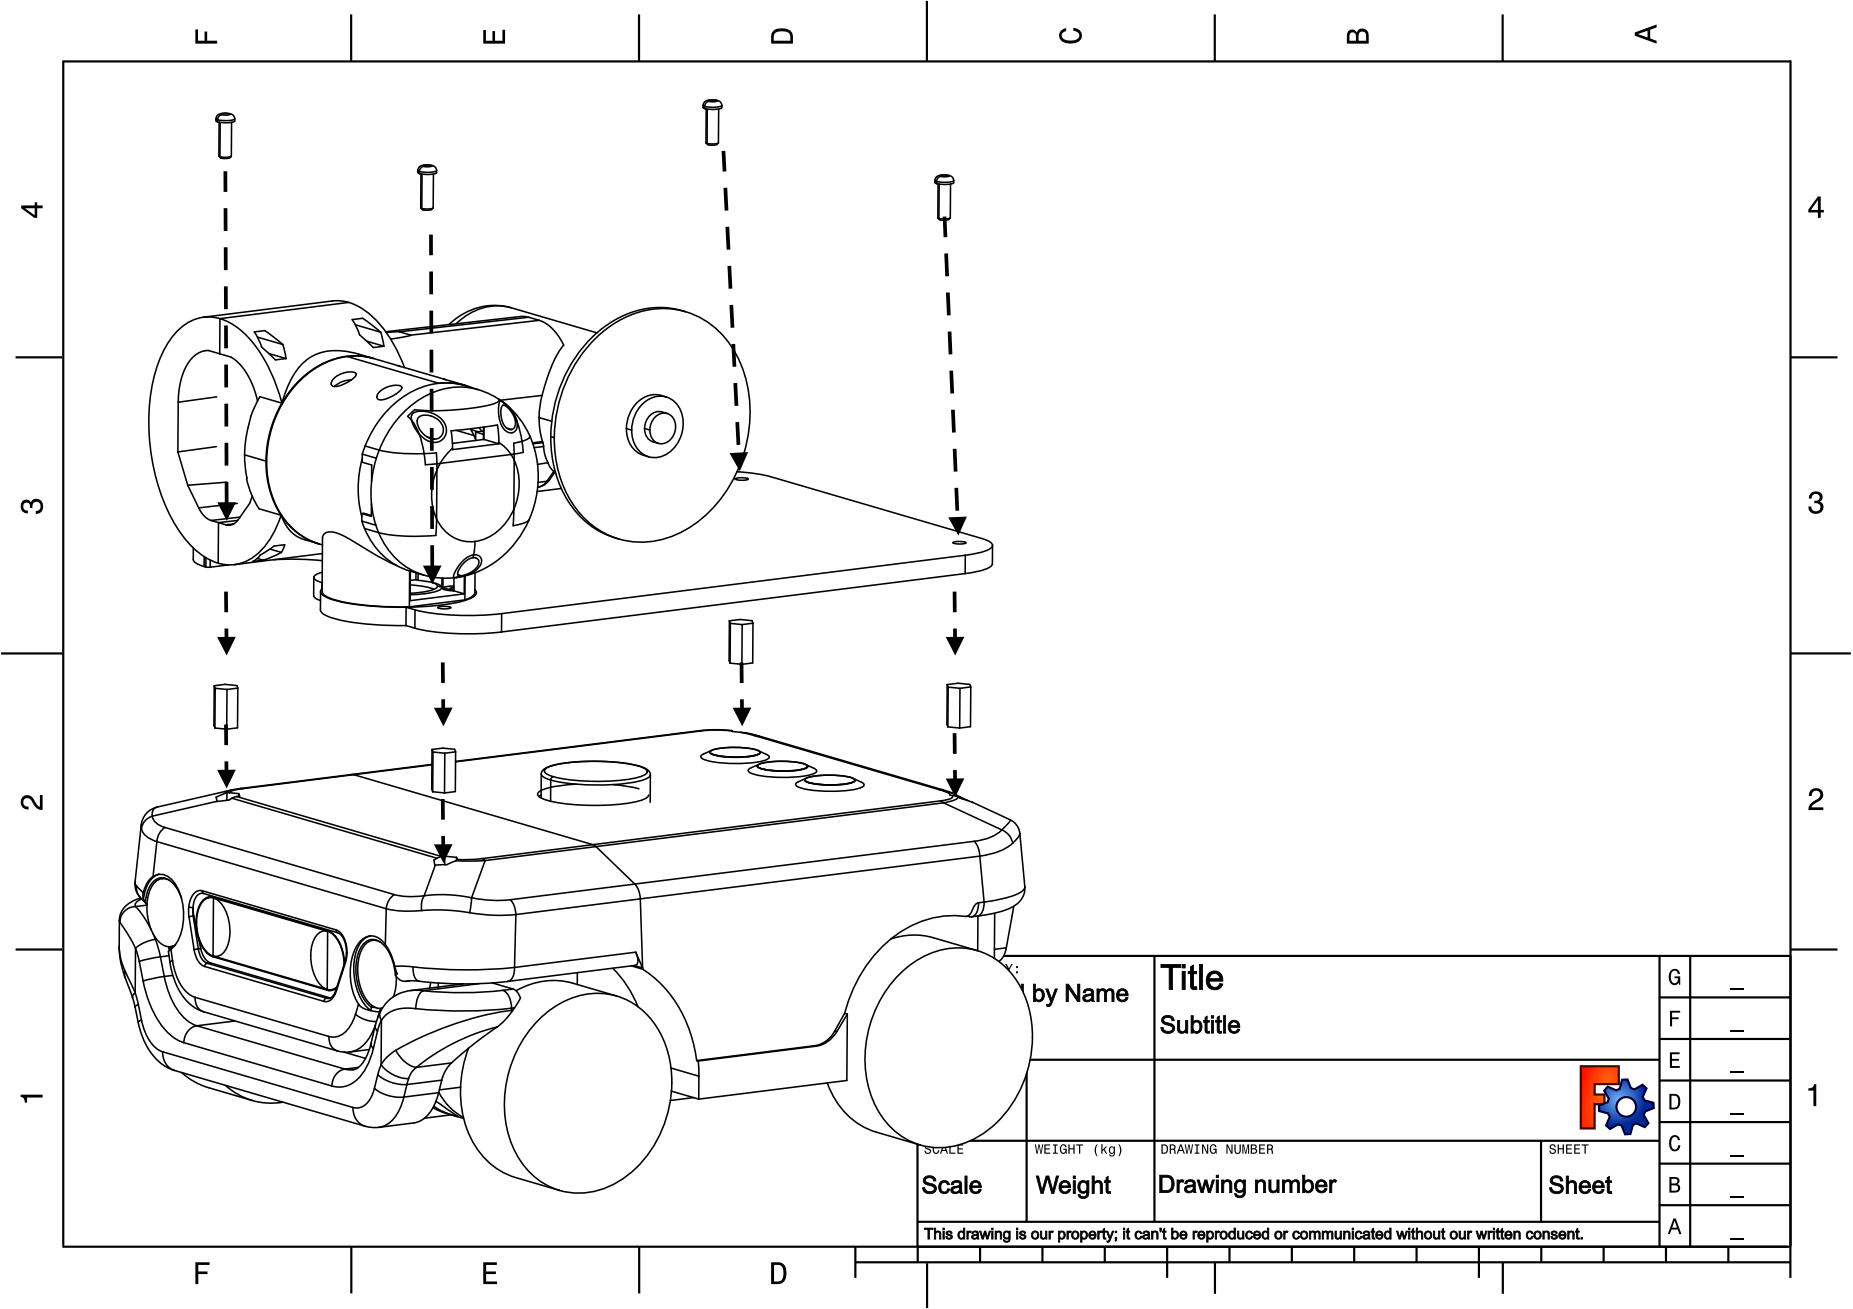
[picture p163: page 1]
