sergei-nntu/ora/ora-7/Assembly Manual/ORA-7. Mount 25T Arm.pdf

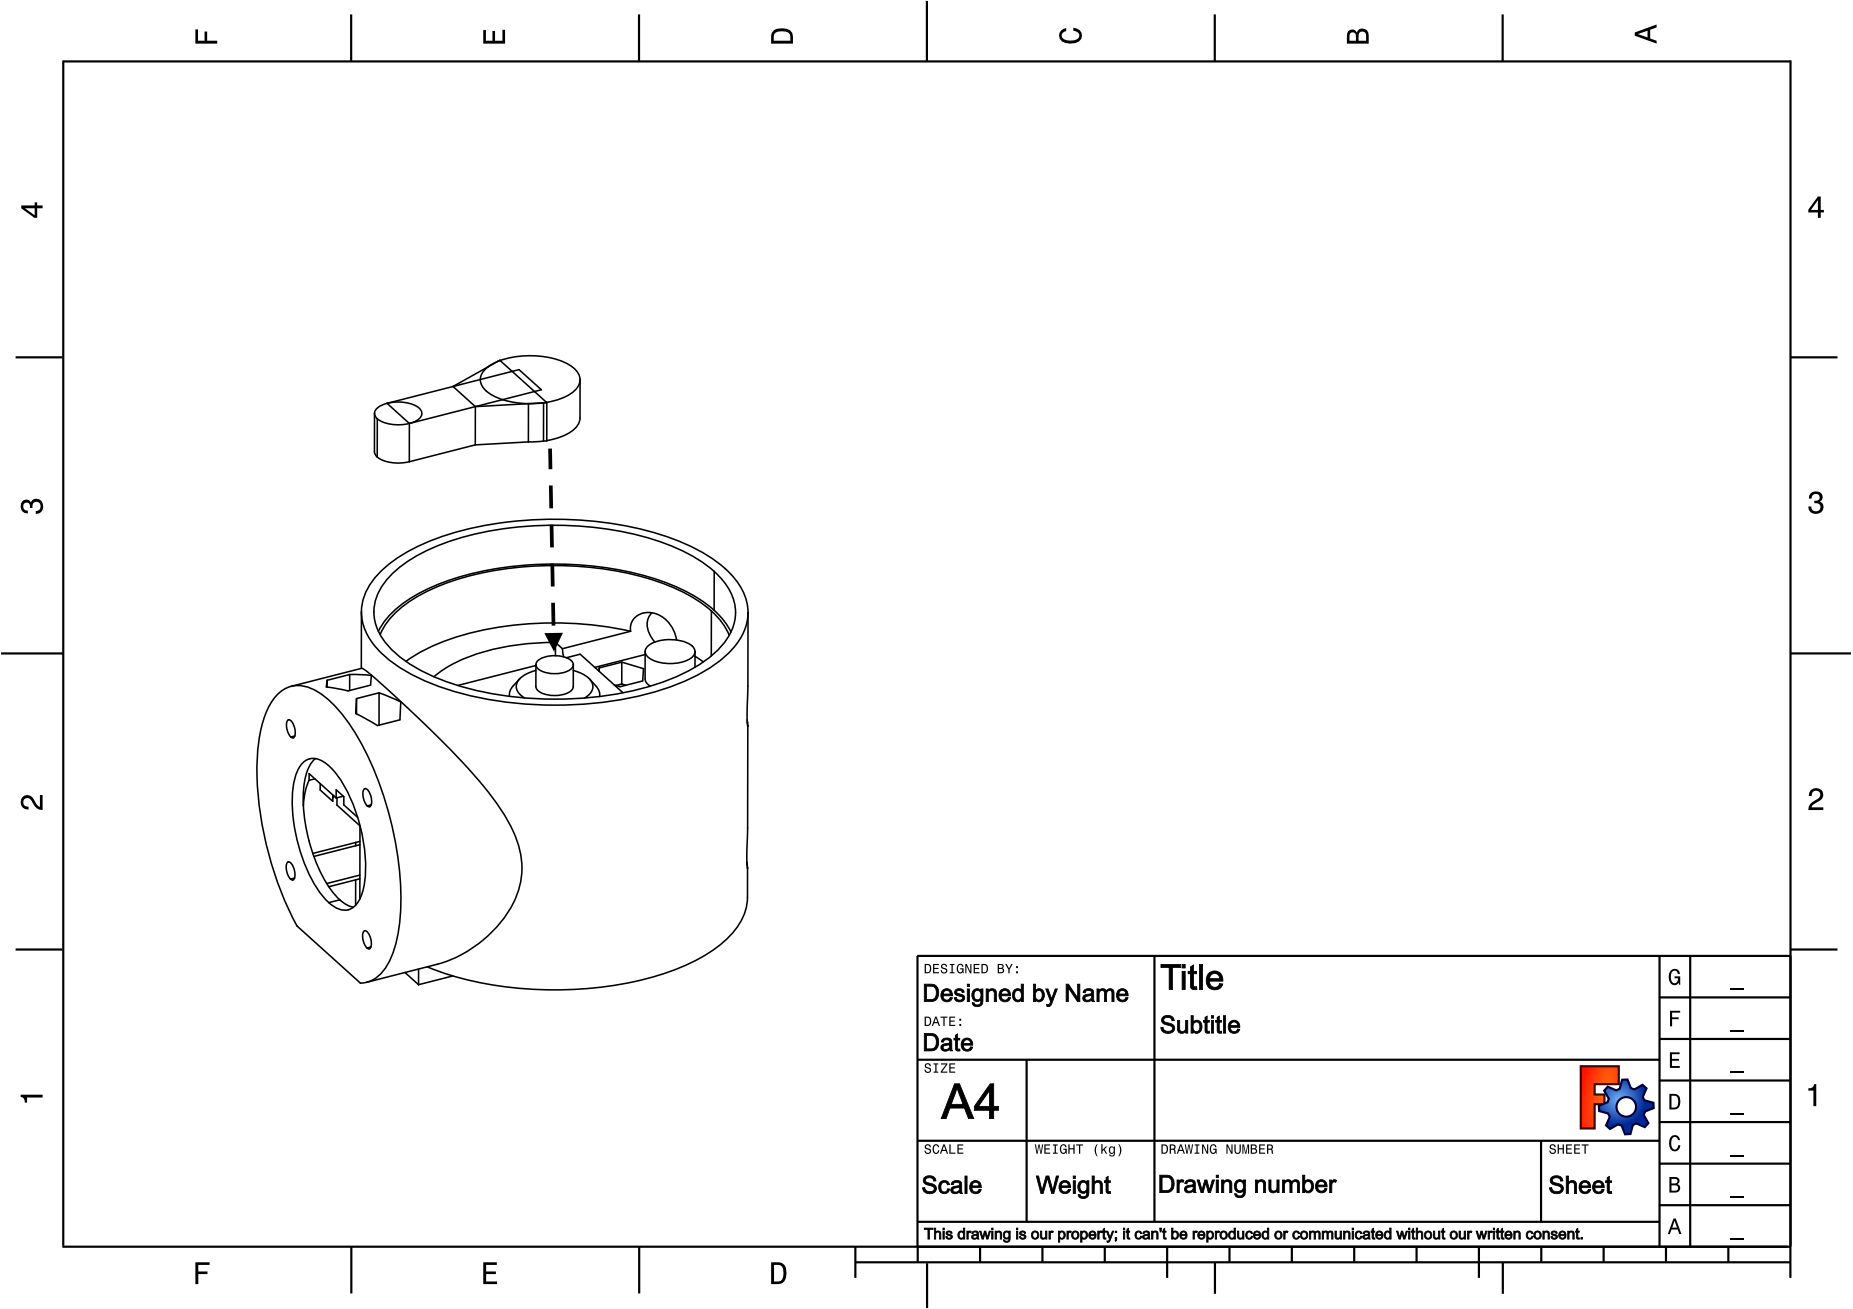
[picture p164: page 1]
