sergei-nntu/ora/ora-7/Assembly Manual/ORA-7. Mount DS3240.pdf

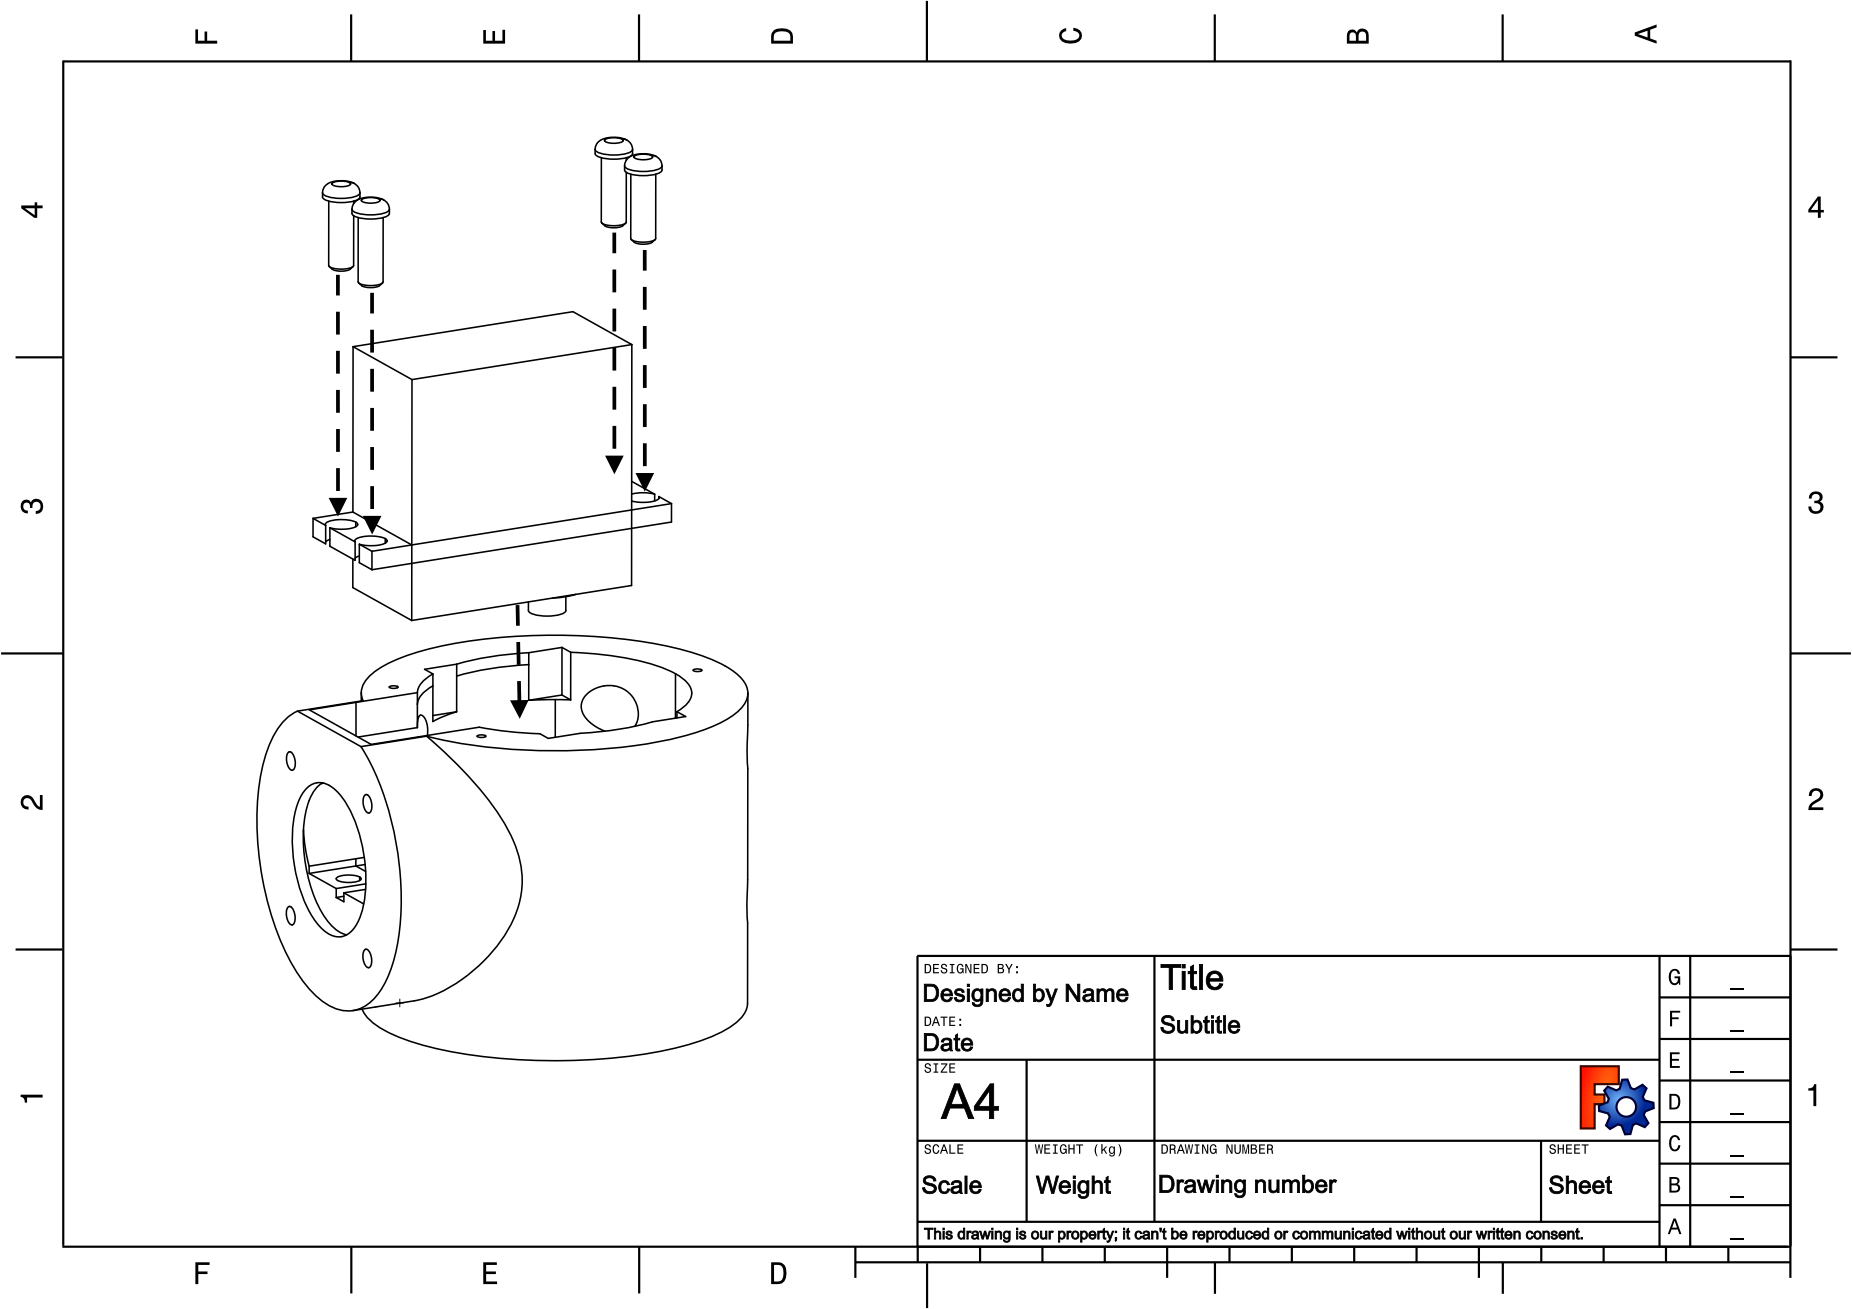
[picture p165: page 1]
