sergei-nntu/ora/ora-7/Assembly Manual/ORA-7. Mount Lid.pdf

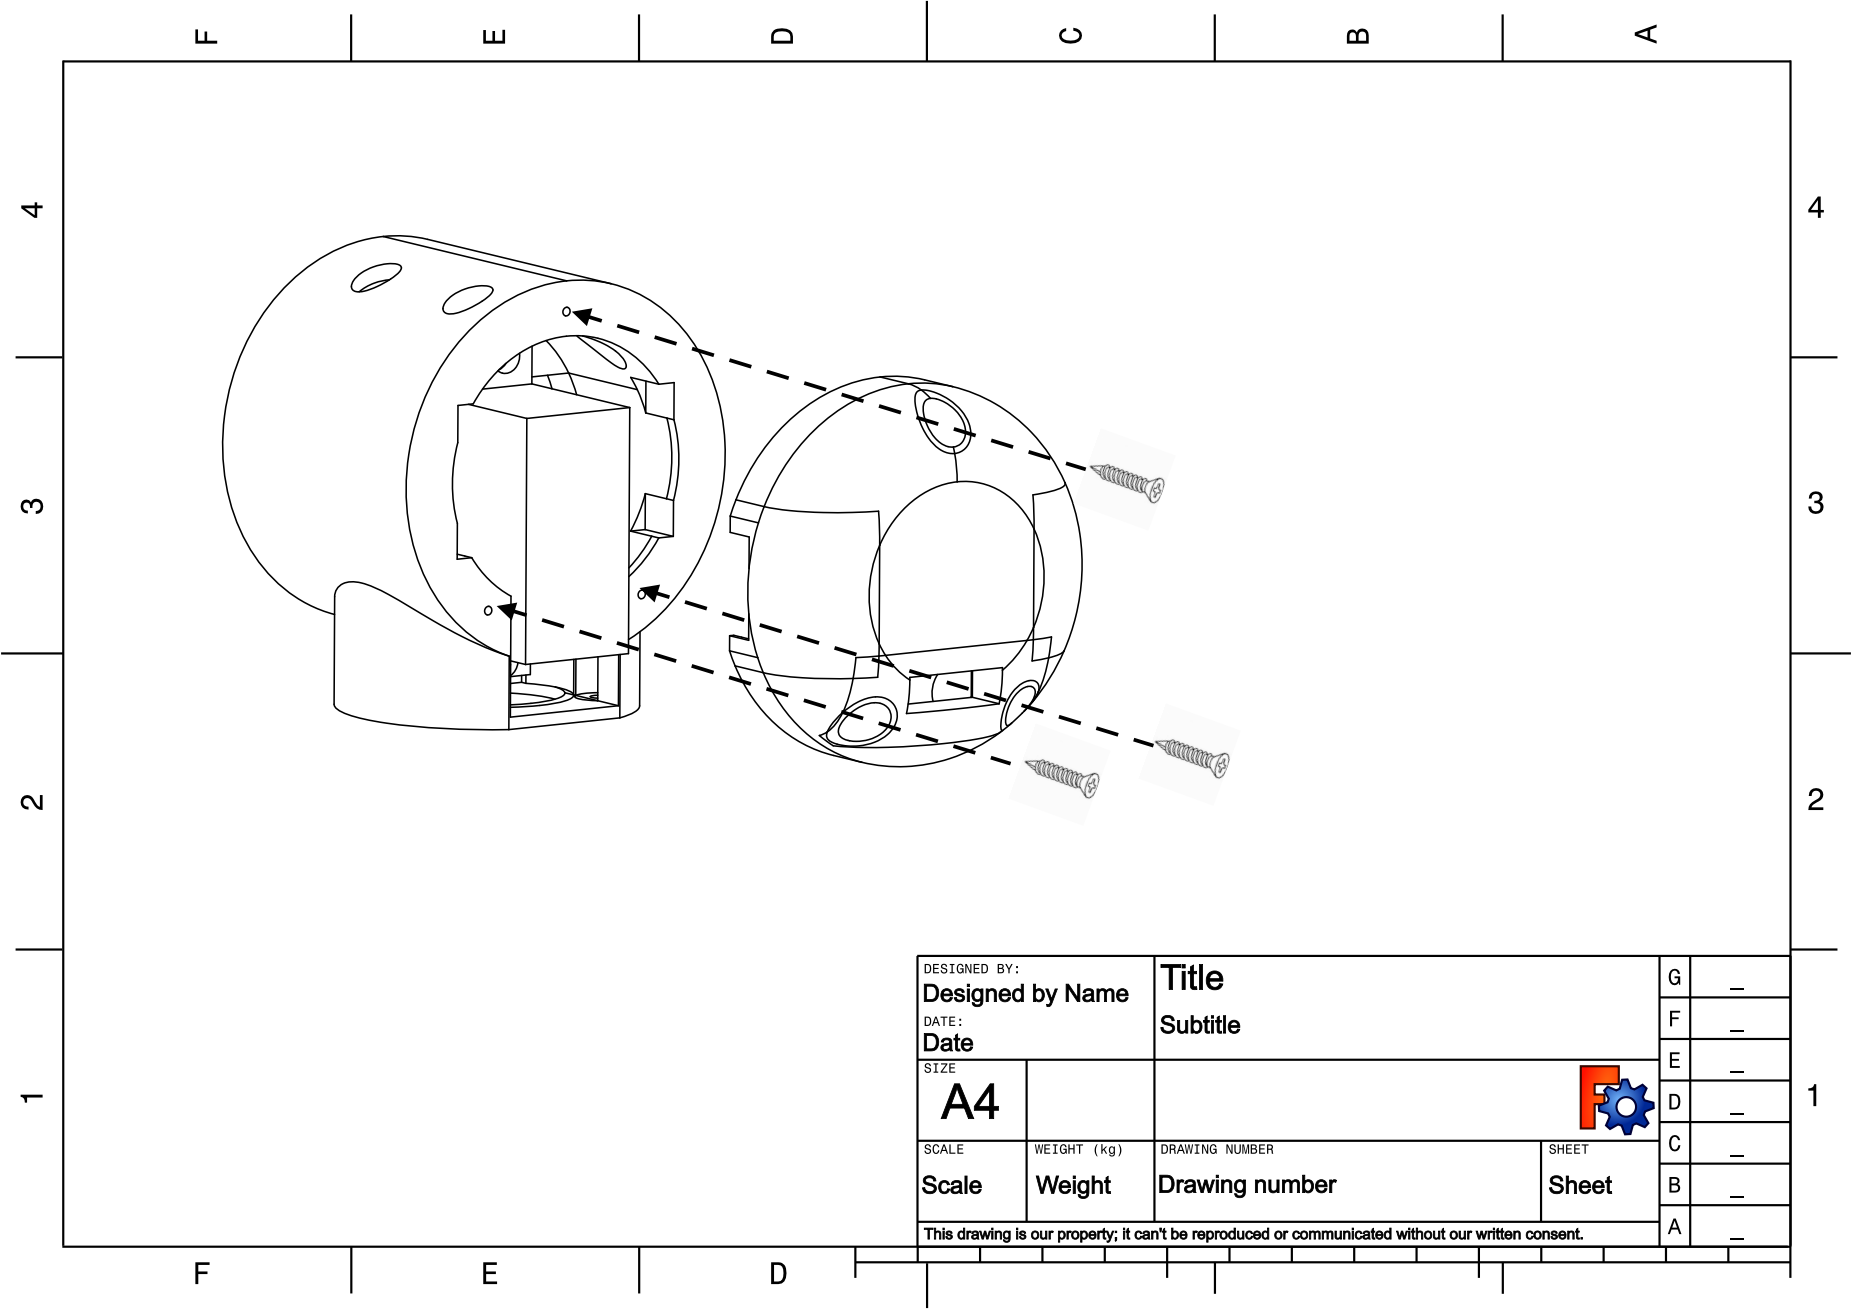
[picture p166: page 1]
