sergei-nntu/ora/ora-7/Assembly Manual/ORA-7. Mount Shaft.pdf

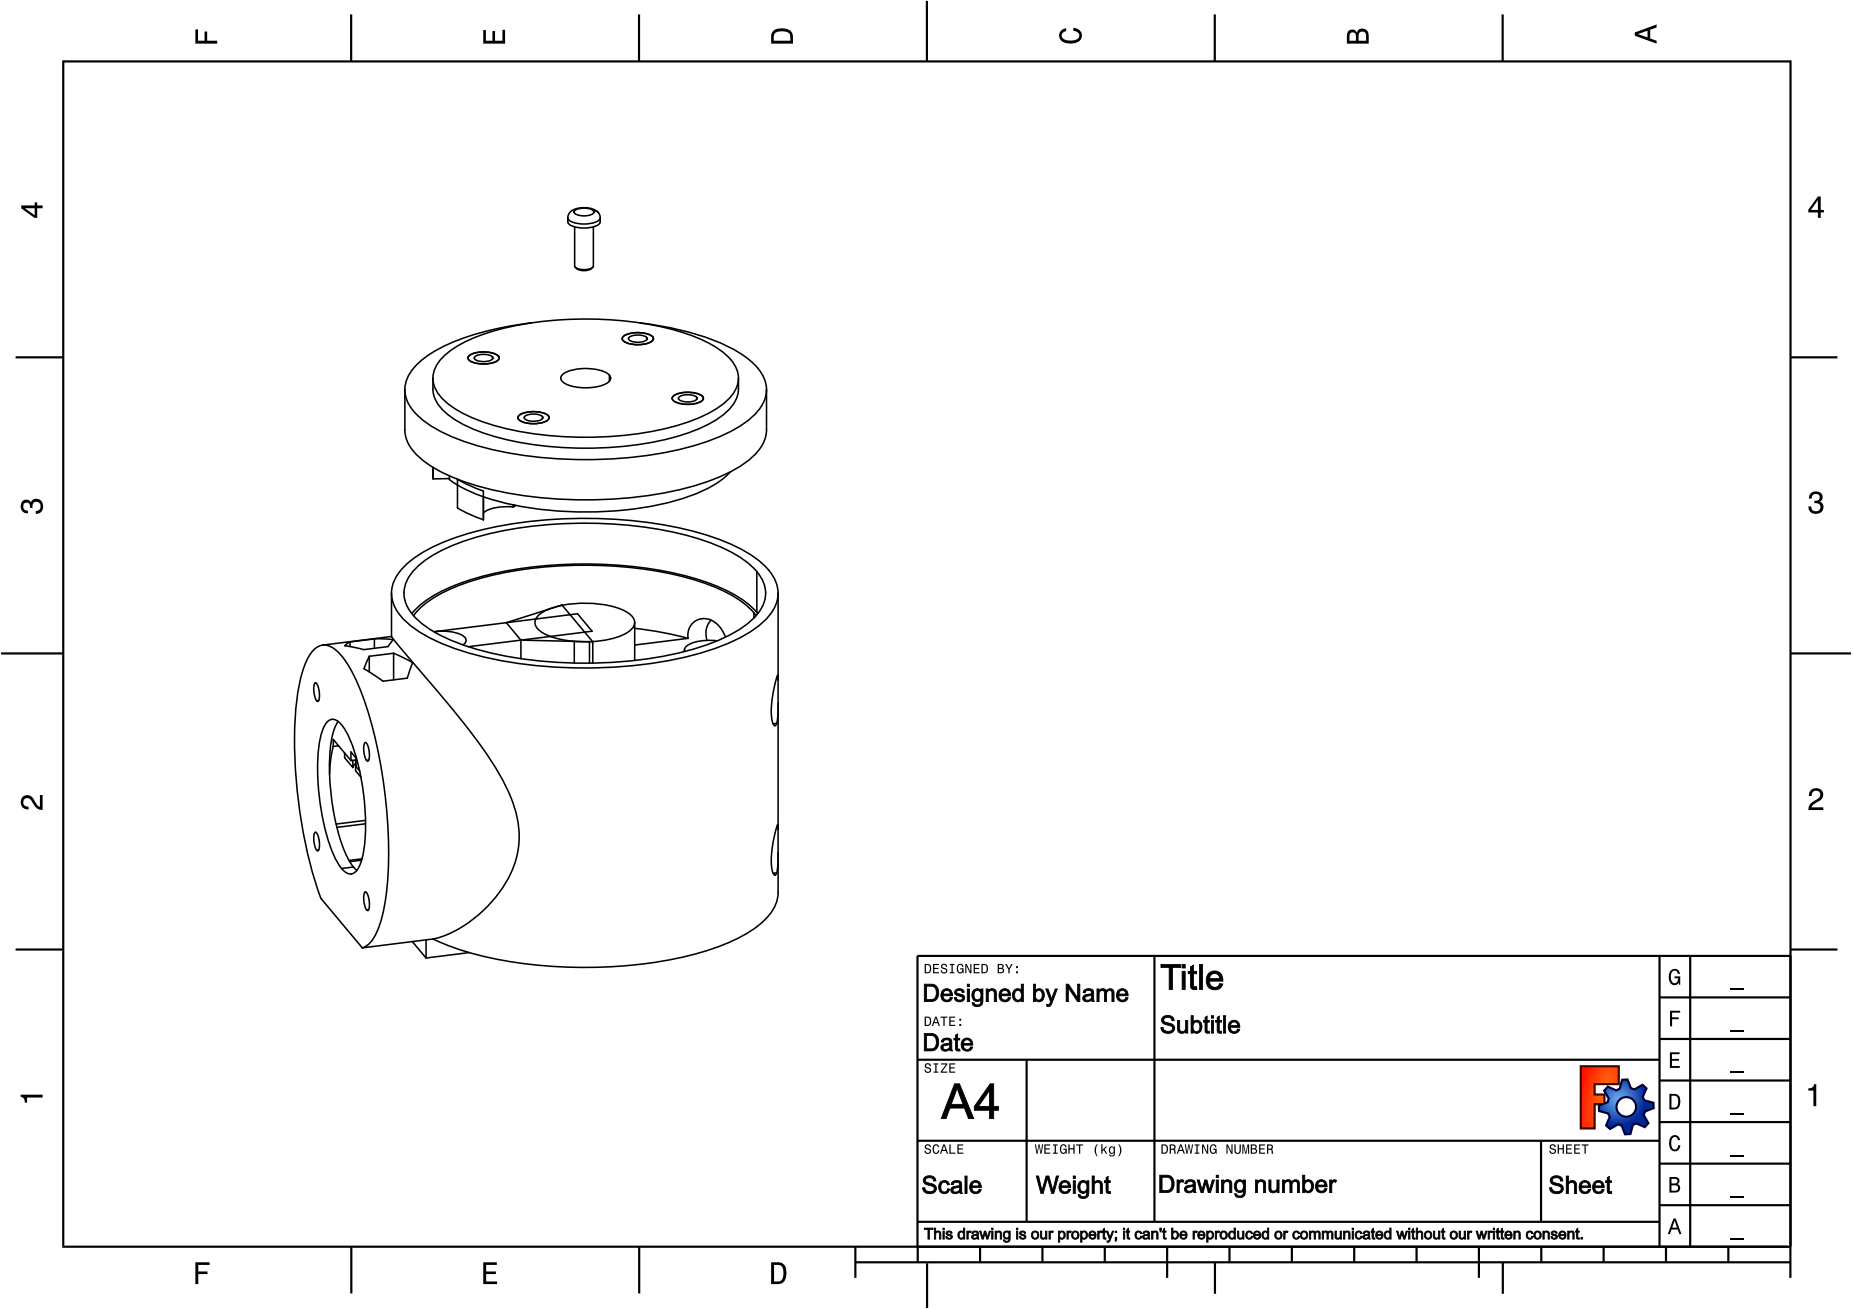
[picture p167: page 1]
