sergei-nntu/ora/ora-7/Assembly Manual/ORA-7. Mount Weapon Holder Base.pdf

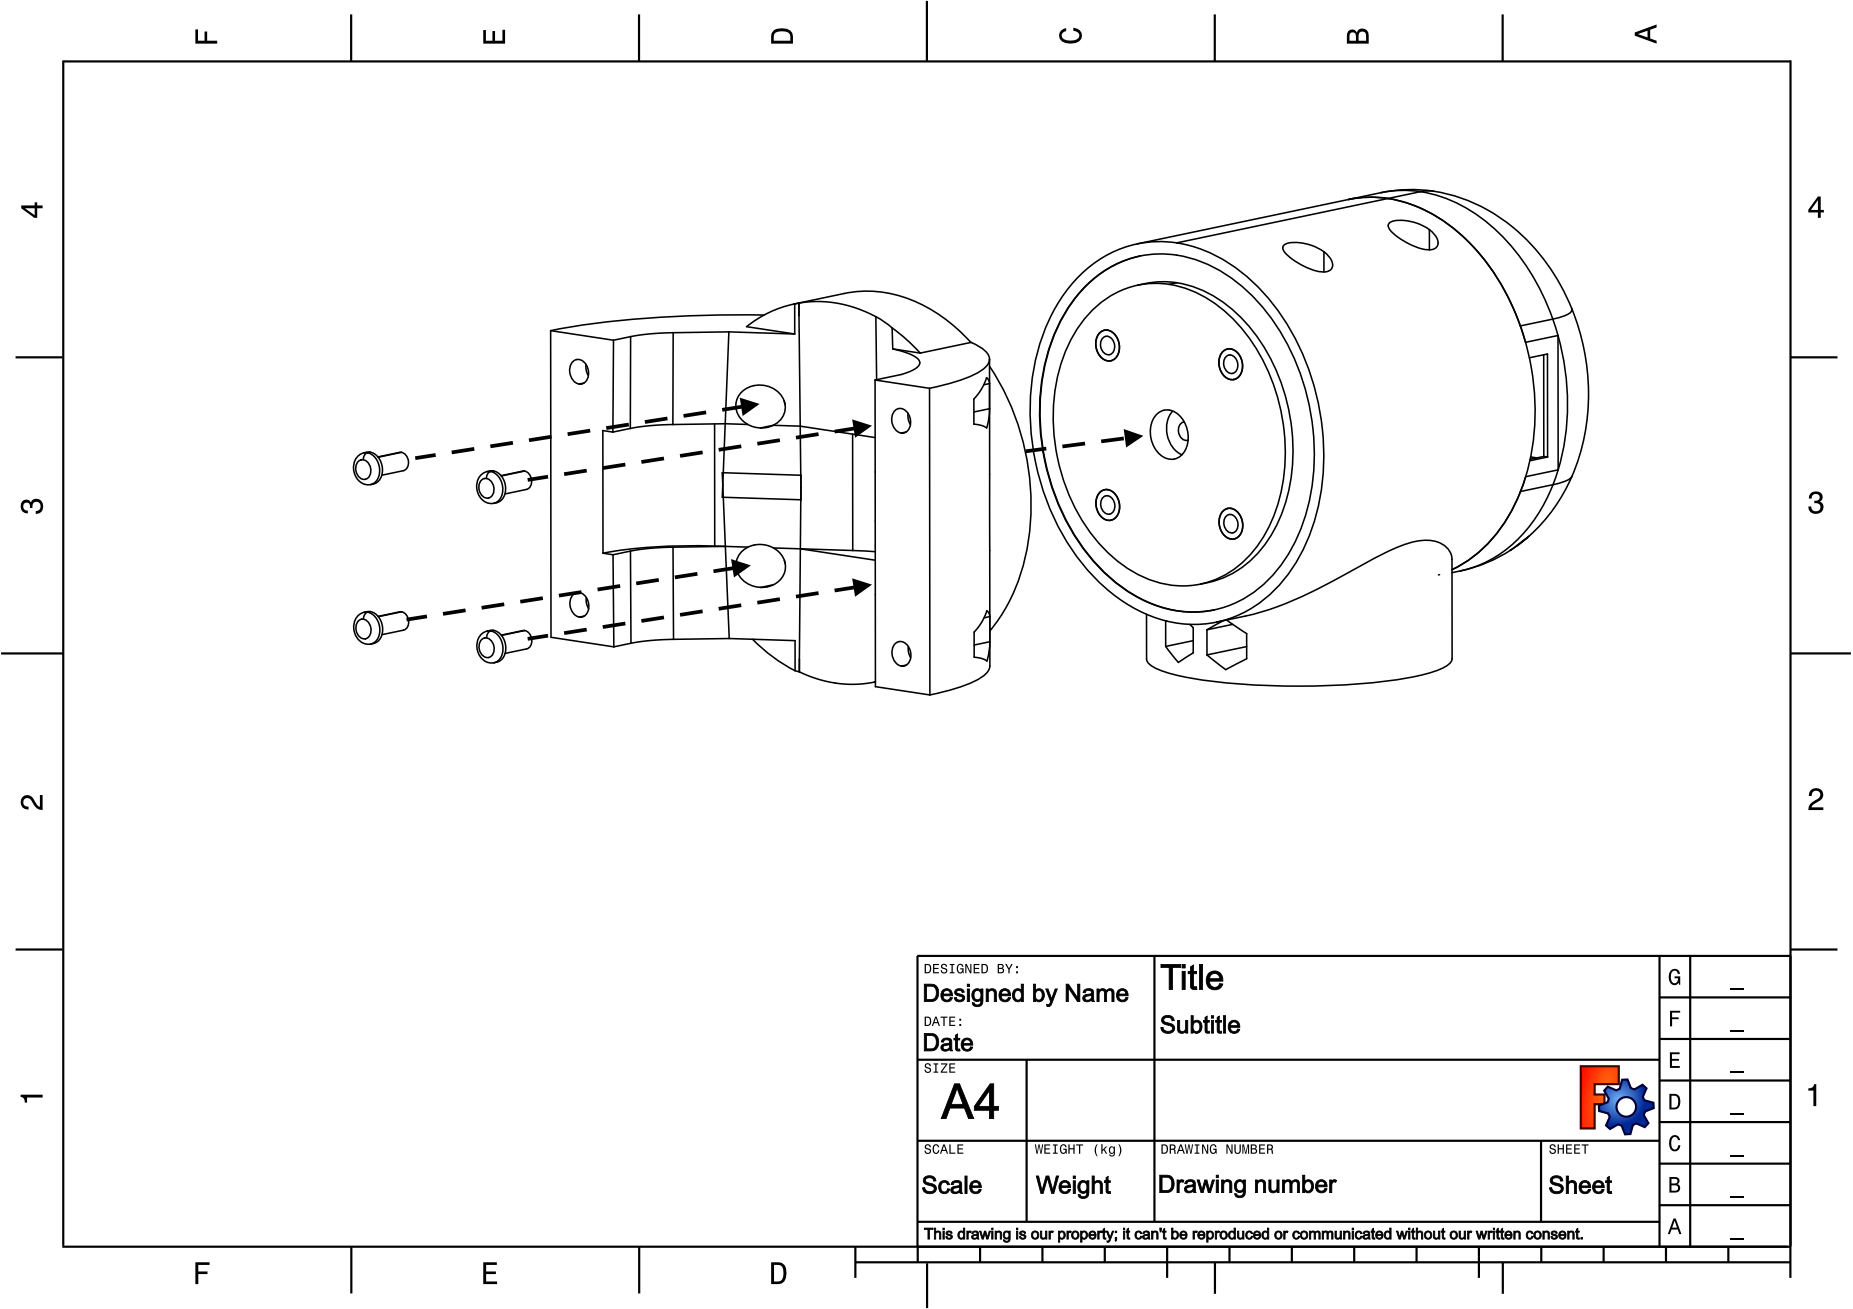
[picture p168: page 1]
