sergei-nntu/ora/ora-7/Assembly Manual/ORA-7. Weapon Assembly.pdf

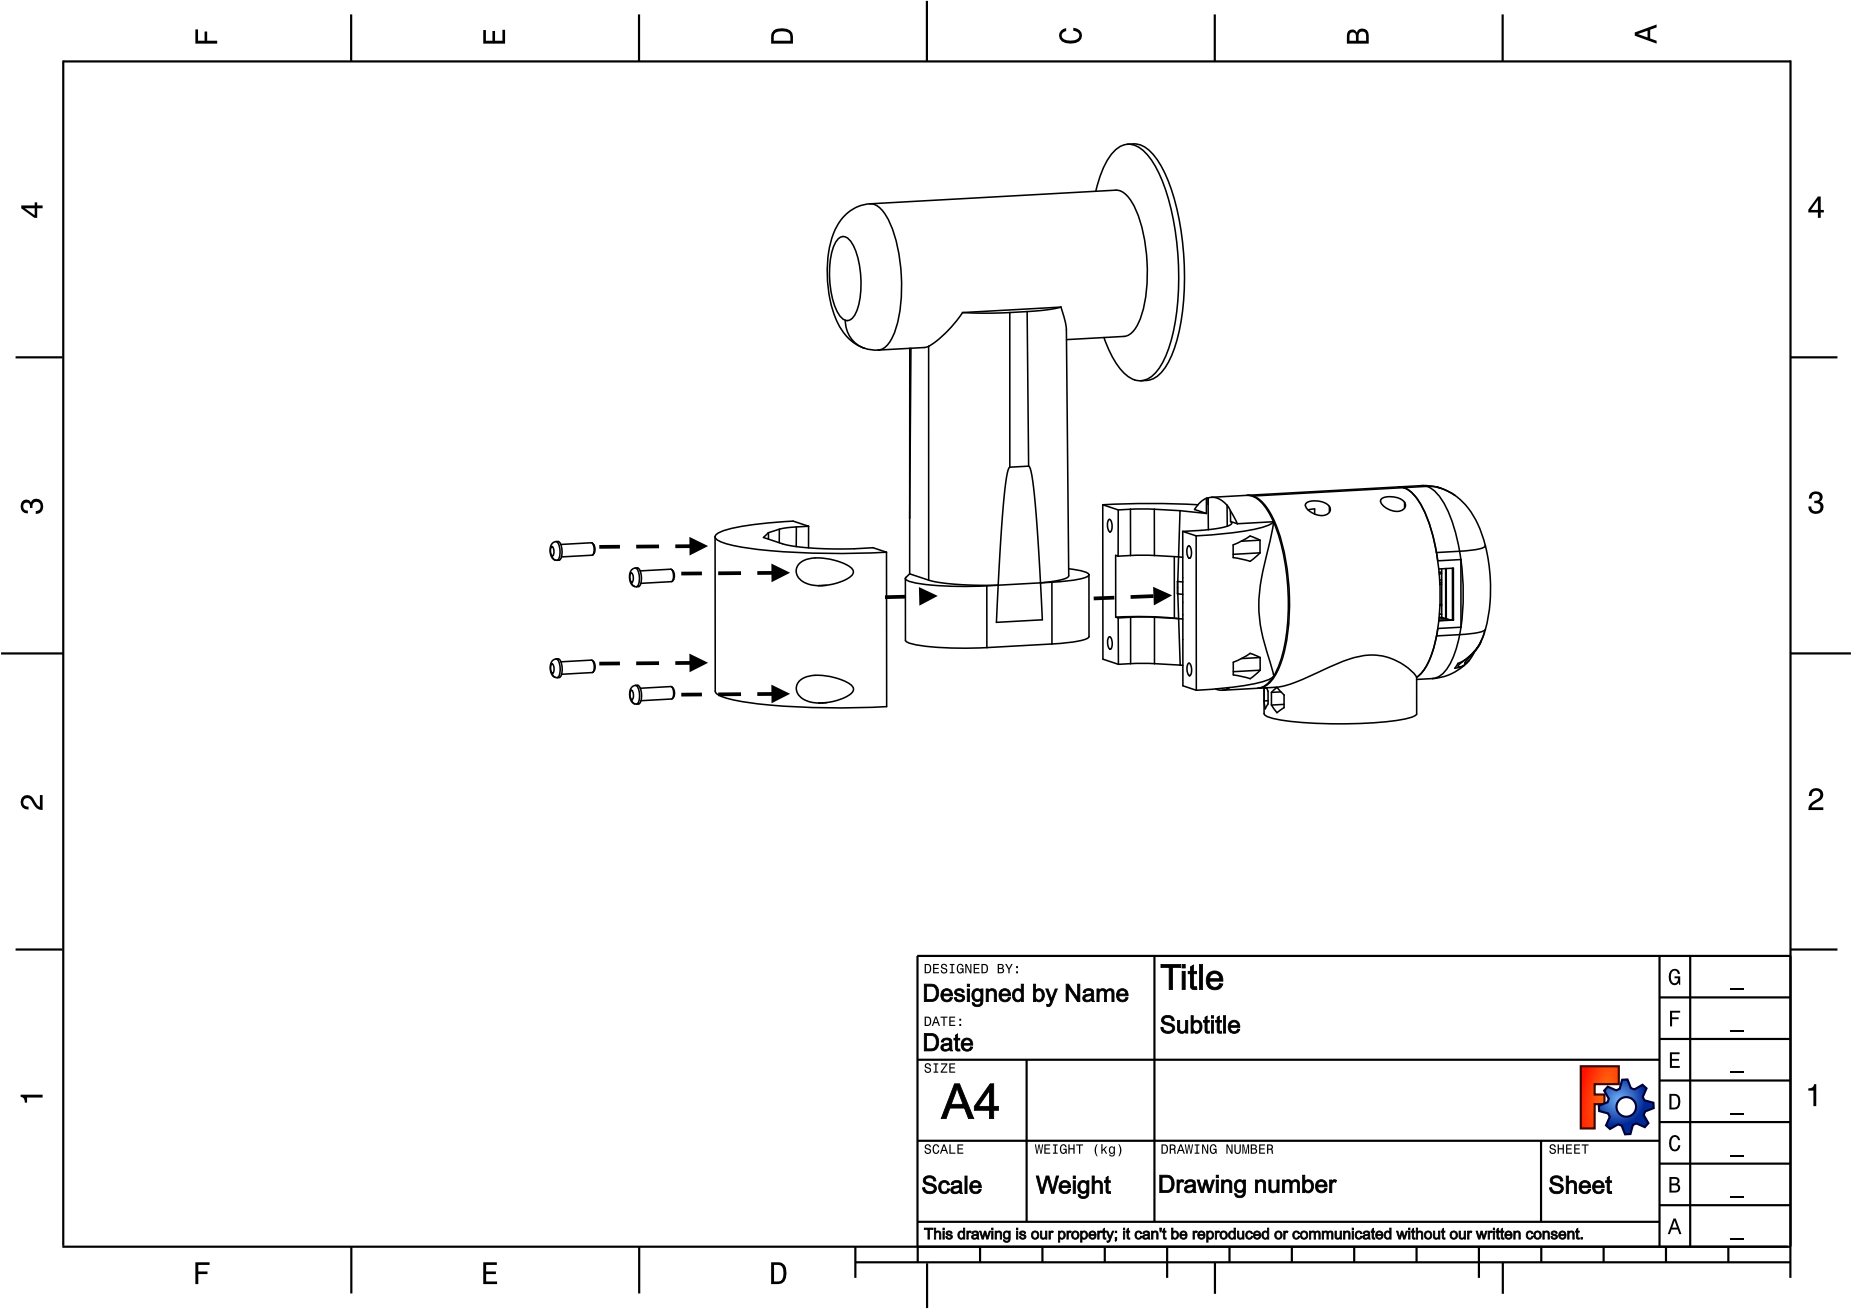
[picture p169: page 1]
