sergei-nntu/ora/src/arduino/sa_psc/orm.ino

#include <EEPROM.h>


#include "orm.h"
/*
AccelStepper j0(1,X_STEP_PIN,X_DIR_PIN);
AccelStepper j1(1,Y_STEP_PIN,Y_DIR_PIN);
AccelStepper j2(1,Z_STEP_PIN,Z_DIR_PIN);
AccelStepper j3(1,E_STEP_PIN,E_DIR_PIN);
AccelStepper j4(1,Q_STEP_PIN,Q_DIR_PIN);
AccelStepper j5(1,W_STEP_PIN,W_DIR_PIN);
*/
/*
Servo js0;  // Joint Servo 0 
Servo js1;  // Joint Servo 1
Servo js2;  // Joint Servo 2
Servo js3;  // Joint Servo 3
Servo js4;  // Joint Servo 4
Servo js5;  // Joint Servo 5
*/


const int MIN_PWM_DEFAULT = 120; // Good 110, last 78
const int MAX_PWM = 255;

// Accumulative speed control
const long ORM_SPEED_DIFF_EPSILON = 500;                 // units/second
const unsigned long ORM_SPEED_DIFF_REACTION_TIME = 25;   // ms
const int ORM_SPEED_EFFORT_FACTOR = 20;
const long ORM_SPEED_EFFORT_DIVISOR = 1000;       

// Proportional speed control
const int ORM_P_SPEED_MAGNITUDE = 5; // was 5
const long ORM_P_SPEED_DIVISOR = 500;                    // units/second

// Effort lock control
const long ORM_ANGLE_DIFF_EPSILON_OUTER = 50;           // angle units
const unsigned long ORM_EFFORT_LOCK_TIMEOUT = 300;       // ms
const unsigned long ORM_EFFORT_LOCK_FORCE_TIMEOUT = 1000; // ms from first outer-range entry

// Impulse position control
const long ORM_ANGLE_DIFF_EPSILON = 25;                  // angle units
const long ORM_POSITION_CONTROL_ANGLE_DIFF = 500;        // angle units
const unsigned short ORM_POSITION_CONTROL_IMPULSE_PERIOD = 75; // default ms
const unsigned long ORM_POSITION_CONTROL_IMPULSE_TIME_MIN = 2;   // ms // was 3
const unsigned long ORM_POSITION_CONTROL_IMPULSE_TIME_MAX = 20;  // ms
const unsigned long ORM_POSITION_CONTROL_IMPULSE_TIME_GAIN = 2;  // ms
const int ORM_POSITION_CONTROL_IMPULSE_MAGNITUDE = 150;          // was 200

//Servo gripperServo;

const int ADC_MAX = 1023;
const unsigned long SPEED_MEASUREMENT_INTERVAL = 50; // Good - 50

const char osp_command_template[] = {0xFF, 0xAA, 0x00, 0x00, 0x00, 0x00, 0x00, 0x00, 0x55, 0x77};

//const int ORM_J_ENCODER_INPUT[JOINTS_COUNT] = {X_ENCODER_IN,Y_ENCODER_IN, Z_ENCODER_IN, E_ENCODER_IN, Q_ENCODER_IN, W_ENCODER_IN} ;/*A1,A2,A3,A4,A5};*/
//const int ORM_J_ENABLE_PIN[JOINTS_COUNT] =    {X_ENABLE_PIN,Y_ENABLE_PIN, Z_ENABLE_PIN, E_ENABLE_PIN, Q_ENABLE_PIN, W_ENABLE_PIN} ;/*7,10,13,16,19};*/
/*
const short orm_j_angle_min = 0;
const short orm_j_angle_max = 1023;
*/

const int ORM_J_ADC_PIN = A0;

const int EEPROM_ANGLE_CORRECTION_OFFSET = 0;
const int EEPROM_ANGLE_WIDTH_OFFSET = EEPROM_ANGLE_CORRECTION_OFFSET + sizeof(short);
const int EEPROM_DEFAULT_ANGLE_OFFSET = EEPROM_ANGLE_WIDTH_OFFSET + sizeof(short);
const int EEPROM_SERVO_ZERO_ANGLE_ADC = EEPROM_DEFAULT_ANGLE_OFFSET + sizeof(short);
const int EEPROM_SERVO_MAX_ANGLE_ADC = EEPROM_SERVO_ZERO_ANGLE_ADC + sizeof(short);
const unsigned short PID_EEPROM_MAGIC = 0xA5A5;
const int EEPROM_PID_MAGIC_OFFSET = EEPROM_SERVO_MAX_ANGLE_ADC + sizeof(short);
const int EEPROM_PID_KP_OFFSET = EEPROM_PID_MAGIC_OFFSET + sizeof(unsigned short);
const int EEPROM_PID_KI_OFFSET = EEPROM_PID_KP_OFFSET + sizeof(double);
const int EEPROM_PID_KD_OFFSET = EEPROM_PID_KI_OFFSET + sizeof(double);
const unsigned short CALIB_EEPROM_MAGIC = 0xC3C3;
const int EEPROM_CALIB_MAGIC_OFFSET = EEPROM_PID_KD_OFFSET + sizeof(double);
const int EEPROM_SPEED_MAX_OFFSET = EEPROM_CALIB_MAGIC_OFFSET + sizeof(unsigned short);
const int EEPROM_ACCELERATION_OFFSET = EEPROM_SPEED_MAX_OFFSET + sizeof(short);
const unsigned short MOTION_EEPROM_MAGIC = 0xC4C4;
const int EEPROM_MOTION_MAGIC_OFFSET = EEPROM_ACCELERATION_OFFSET + sizeof(short);
const int EEPROM_MIN_PWM_OFFSET = EEPROM_MOTION_MAGIC_OFFSET + sizeof(unsigned short);
const unsigned short PWM_EEPROM_MAGIC = 0xC5C5;
const int EEPROM_PWM_MAGIC_OFFSET = EEPROM_MIN_PWM_OFFSET + sizeof(short);
const int EEPROM_ADC_SAMPLES_N_OFFSET = EEPROM_PWM_MAGIC_OFFSET + sizeof(unsigned short);
const unsigned short ADC_SAMPLES_EEPROM_MAGIC = 0xC6C6;
const int EEPROM_ADC_SAMPLES_MAGIC_OFFSET = EEPROM_ADC_SAMPLES_N_OFFSET + sizeof(short);
const int EEPROM_IMPULSE_PERIOD_OFFSET = EEPROM_ADC_SAMPLES_MAGIC_OFFSET + sizeof(unsigned short);
const int EEPROM_IMPULSE_PERIOD_MAGIC_OFFSET = EEPROM_IMPULSE_PERIOD_OFFSET + sizeof(unsigned short);
const unsigned short IMPULSE_PERIOD_EEPROM_MAGIC = 0xC7C7;
const int EEPROM_ANGLE_DIFF_EPSILON_OFFSET = EEPROM_IMPULSE_PERIOD_MAGIC_OFFSET + sizeof(unsigned short);
const int EEPROM_ANGLE_DIFF_EPSILON_MAGIC_OFFSET = EEPROM_ANGLE_DIFF_EPSILON_OFFSET + sizeof(unsigned short);
const unsigned short ANGLE_DIFF_EPSILON_EEPROM_MAGIC = 0xC8C8;
const int EEPROM_ANGLE_DIFF_EPSILON_OUTER_OFFSET = EEPROM_ANGLE_DIFF_EPSILON_MAGIC_OFFSET + sizeof(unsigned short);
const int EEPROM_ANGLE_DIFF_EPSILON_OUTER_MAGIC_OFFSET = EEPROM_ANGLE_DIFF_EPSILON_OUTER_OFFSET + sizeof(unsigned short);
const unsigned short ANGLE_DIFF_EPSILON_OUTER_EEPROM_MAGIC = 0xC9C9;
const int EEPROM_IMPULSE_TIME_MIN_OFFSET = EEPROM_ANGLE_DIFF_EPSILON_OUTER_MAGIC_OFFSET + sizeof(unsigned short);
const int EEPROM_IMPULSE_TIME_MIN_MAGIC_OFFSET = EEPROM_IMPULSE_TIME_MIN_OFFSET + sizeof(unsigned short);
const unsigned short IMPULSE_TIME_MIN_EEPROM_MAGIC = 0xCACA;
const int EEPROM_IMPULSE_TIME_MAX_OFFSET = EEPROM_IMPULSE_TIME_MIN_MAGIC_OFFSET + sizeof(unsigned short);
const int EEPROM_IMPULSE_TIME_MAX_MAGIC_OFFSET = EEPROM_IMPULSE_TIME_MAX_OFFSET + sizeof(unsigned short);
const unsigned short IMPULSE_TIME_MAX_EEPROM_MAGIC = 0xCBCB;
const int EEPROM_IMPULSE_TIME_GAIN_OFFSET = EEPROM_IMPULSE_TIME_MAX_MAGIC_OFFSET + sizeof(unsigned short);
const int EEPROM_IMPULSE_TIME_GAIN_MAGIC_OFFSET = EEPROM_IMPULSE_TIME_GAIN_OFFSET + sizeof(unsigned short);
const unsigned short IMPULSE_TIME_GAIN_EEPROM_MAGIC = 0xCCCC;
const int EEPROM_EFFORT_LOCK_TIMEOUT_OFFSET = EEPROM_IMPULSE_TIME_GAIN_MAGIC_OFFSET + sizeof(unsigned short);
const int EEPROM_EFFORT_LOCK_TIMEOUT_MAGIC_OFFSET = EEPROM_EFFORT_LOCK_TIMEOUT_OFFSET + sizeof(unsigned short);
const unsigned short EFFORT_LOCK_TIMEOUT_EEPROM_MAGIC = 0xCDCD;
const int EEPROM_EFFORT_LOCK_FORCE_TIMEOUT_OFFSET = EEPROM_EFFORT_LOCK_TIMEOUT_MAGIC_OFFSET + sizeof(unsigned short);
const int EEPROM_EFFORT_LOCK_FORCE_TIMEOUT_MAGIC_OFFSET = EEPROM_EFFORT_LOCK_FORCE_TIMEOUT_OFFSET + sizeof(unsigned short);
const unsigned short EFFORT_LOCK_FORCE_TIMEOUT_EEPROM_MAGIC = 0xCECE;

const int PID_MODE_SPEED = 1;
const int PID_MODE_ANGLE = 2;

int PID_MODE = PID_MODE_SPEED;
const int CONTROL_MODE_PID = 0;
const int CONTROL_MODE_FORCE_PWM = 1;

void ORM::ospHandleGenericCommand(){
  // TODO
}

void ORM::cmdSetEffortLock(){
  unsigned short external_effort_lock_value =
    ((unsigned short)(unsigned char)osp_input_buffer[OSP_ORM_ANGLE_MSB_INDEX] << 8) |
    (unsigned char)osp_input_buffer[OSP_ORM_ANGLE_LSB_INDEX];
  if (external_effort_lock_value != 0 && !external_effort_lock_enabled) {
    external_effort_lock_effort = effort_lock_last_effort;
  }
  external_effort_lock_enabled = external_effort_lock_value != 0;
  // Releasing an external hold starts a fresh automatic-lock attempt.
  effort_locked = false;
  effort_lock_candidate_active = false;
  effort_lock_force_active = false;
  effort_lock_forced = false;
}

void ORM::cmdSetAngle(){
  int angle = ((int)(osp_input_buffer[OSP_ORM_ANGLE_MSB_INDEX]) << 8) | osp_input_buffer[OSP_ORM_ANGLE_LSB_INDEX];
  char force = osp_input_buffer[OSP_ORM_ANGLE_FORCE_INDEX];
  j_angle_desired = angle;
  j_angle_force = force;
  j_angle_coarse = false;
  target_angle_stable_iterations = 0;
  control_mode = CONTROL_MODE_PID;
  effort_locked = false;
  effort_lock_force_active = false;
  effort_lock_forced = false;
  effort_lock_candidate_active = false;
  external_effort_lock_enabled = false;
}

void ORM::cmdSetCoarseAngle(){
  
  int angle = ((int)(osp_input_buffer[OSP_ORM_ANGLE_MSB_INDEX]) << 8) | osp_input_buffer[OSP_ORM_ANGLE_LSB_INDEX];
  char force = osp_input_buffer[OSP_ORM_ANGLE_FORCE_INDEX];
  j_angle_desired = angle;
  j_angle_force = force;
  j_angle_coarse = true;
  target_angle_stable_iterations = 0;
  control_mode = CONTROL_MODE_PID;
  effort_locked = false;
  effort_lock_force_active = false;
  effort_lock_forced = false;
  effort_lock_candidate_active = false;
  external_effort_lock_enabled = false;
}

void ORM::cmdSetCorrAngle(){
  int angle = ((int)(osp_input_buffer[OSP_ORM_ANGLE_MSB_INDEX]) << 8) | osp_input_buffer[OSP_ORM_ANGLE_LSB_INDEX];
  j_angle_correction = angle;
  saveCalibrationToEeprom();

}

void ORM::cmdSetAngleWidth(){
  int angle = ((int)(osp_input_buffer[OSP_ORM_ANGLE_MSB_INDEX]) << 8) | osp_input_buffer[OSP_ORM_ANGLE_LSB_INDEX];
  j_angle_width = angle;
  saveCalibrationToEeprom();
}

void ORM::cmdSetMaxSpeed(){
  int speed = (short)(((int)(osp_input_buffer[OSP_ORM_ANGLE_MSB_INDEX]) << 8) | osp_input_buffer[OSP_ORM_ANGLE_LSB_INDEX]);
  if (speed < 0) {
    speed = 0;
  } else if (speed > 32767) {
    speed = 32767;
  }
  j_speed_max = speed;
  saveMotionLimitsToEeprom();
}

void ORM::cmdSetAcceleration(){
  int accel = (short)(((int)(osp_input_buffer[OSP_ORM_ANGLE_MSB_INDEX]) << 8) | osp_input_buffer[OSP_ORM_ANGLE_LSB_INDEX]);
  if (accel < 0) {
    accel = 0;
  } else if (accel > 32767) {
    accel = 32767;
  }
  j_acceleration = accel;
  saveMotionLimitsToEeprom();
}

void ORM::cmdSetMinPwm(){
  int pwm = (short)(((int)(osp_input_buffer[OSP_ORM_ANGLE_MSB_INDEX]) << 8) | osp_input_buffer[OSP_ORM_ANGLE_LSB_INDEX]);
  if (pwm < 0) {
    pwm = 0;
  } else if (pwm > MAX_PWM) {
    pwm = MAX_PWM;
  }
  min_pwm = pwm;
  saveMinPwmToEeprom();
}

void ORM::cmdSetAdcSamplesN(){
  int samples = (short)(((int)(osp_input_buffer[OSP_ORM_ANGLE_MSB_INDEX]) << 8) | osp_input_buffer[OSP_ORM_ANGLE_LSB_INDEX]);
  if (samples < 1) {
    samples = 1;
  } else if (samples > ADC_SAMPLES_N_MAX) {
    samples = ADC_SAMPLES_N_MAX;
  }
  adc_samples_n = samples;
  if (j_angle_samples_ptr >= adc_samples_n) {
    j_angle_samples_ptr = 0;
  }
  if (j_angle_samples_count > adc_samples_n) {
    j_angle_samples_count = adc_samples_n;
  }
  saveAdcSamplesToEeprom();
}

void ORM::cmdSetAngleDiffEpsilon(){
  unsigned short value =
    ((unsigned short)(unsigned char)osp_input_buffer[OSP_ORM_ANGLE_MSB_INDEX] << 8) |
    (unsigned char)osp_input_buffer[OSP_ORM_ANGLE_LSB_INDEX];
  angle_diff_epsilon = value == 0 ? 1 : value;
  EEPROM.put(EEPROM_ANGLE_DIFF_EPSILON_OFFSET, angle_diff_epsilon);
  EEPROM.put(EEPROM_ANGLE_DIFF_EPSILON_MAGIC_OFFSET, ANGLE_DIFF_EPSILON_EEPROM_MAGIC);
}

void ORM::cmdSetAngleDiffEpsilonOuter(){
  unsigned short value =
    ((unsigned short)(unsigned char)osp_input_buffer[OSP_ORM_ANGLE_MSB_INDEX] << 8) |
    (unsigned char)osp_input_buffer[OSP_ORM_ANGLE_LSB_INDEX];
  angle_diff_epsilon_outer = value == 0 ? 1 : value;
  EEPROM.put(EEPROM_ANGLE_DIFF_EPSILON_OUTER_OFFSET, angle_diff_epsilon_outer);
  EEPROM.put(EEPROM_ANGLE_DIFF_EPSILON_OUTER_MAGIC_OFFSET, ANGLE_DIFF_EPSILON_OUTER_EEPROM_MAGIC);
}

void ORM::cmdSetPositionControlImpulseTimeMin(){
  unsigned short value =
    ((unsigned short)(unsigned char)osp_input_buffer[OSP_ORM_ANGLE_MSB_INDEX] << 8) |
    (unsigned char)osp_input_buffer[OSP_ORM_ANGLE_LSB_INDEX];
  position_control_impulse_time_min = value == 0 ? 1 : value;
  EEPROM.put(EEPROM_IMPULSE_TIME_MIN_OFFSET, position_control_impulse_time_min);
  EEPROM.put(EEPROM_IMPULSE_TIME_MIN_MAGIC_OFFSET, IMPULSE_TIME_MIN_EEPROM_MAGIC);
}

void ORM::cmdSetPositionControlImpulseTimeMax(){
  unsigned short value =
    ((unsigned short)(unsigned char)osp_input_buffer[OSP_ORM_ANGLE_MSB_INDEX] << 8) |
    (unsigned char)osp_input_buffer[OSP_ORM_ANGLE_LSB_INDEX];
  position_control_impulse_time_max = value == 0 ? 1 : value;
  EEPROM.put(EEPROM_IMPULSE_TIME_MAX_OFFSET, position_control_impulse_time_max);
  EEPROM.put(EEPROM_IMPULSE_TIME_MAX_MAGIC_OFFSET, IMPULSE_TIME_MAX_EEPROM_MAGIC);
}

void ORM::cmdSetPositionControlImpulseTimeGain(){
  unsigned short value =
    ((unsigned short)(unsigned char)osp_input_buffer[OSP_ORM_ANGLE_MSB_INDEX] << 8) |
    (unsigned char)osp_input_buffer[OSP_ORM_ANGLE_LSB_INDEX];
  position_control_impulse_time_gain = value;
  EEPROM.put(EEPROM_IMPULSE_TIME_GAIN_OFFSET, position_control_impulse_time_gain);
  EEPROM.put(EEPROM_IMPULSE_TIME_GAIN_MAGIC_OFFSET, IMPULSE_TIME_GAIN_EEPROM_MAGIC);
}

void ORM::cmdSetEffortLockTimeout(){
  unsigned short value =
    ((unsigned short)(unsigned char)osp_input_buffer[OSP_ORM_ANGLE_MSB_INDEX] << 8) |
    (unsigned char)osp_input_buffer[OSP_ORM_ANGLE_LSB_INDEX];
  effort_lock_timeout = value == 0 ? 1 : value;
  EEPROM.put(EEPROM_EFFORT_LOCK_TIMEOUT_OFFSET, effort_lock_timeout);
  EEPROM.put(EEPROM_EFFORT_LOCK_TIMEOUT_MAGIC_OFFSET, EFFORT_LOCK_TIMEOUT_EEPROM_MAGIC);
}

void ORM::cmdSetEffortLockForceTimeout(){
  unsigned short value =
    ((unsigned short)(unsigned char)osp_input_buffer[OSP_ORM_ANGLE_MSB_INDEX] << 8) |
    (unsigned char)osp_input_buffer[OSP_ORM_ANGLE_LSB_INDEX];
  effort_lock_force_timeout = value == 0 ? 1 : value;
  EEPROM.put(EEPROM_EFFORT_LOCK_FORCE_TIMEOUT_OFFSET, effort_lock_force_timeout);
  EEPROM.put(EEPROM_EFFORT_LOCK_FORCE_TIMEOUT_MAGIC_OFFSET, EFFORT_LOCK_FORCE_TIMEOUT_EEPROM_MAGIC);
}

void ORM::cmdSetPositionControlImpulsePeriod(){
  unsigned short period =
    ((unsigned short)(unsigned char)osp_input_buffer[OSP_ORM_ANGLE_MSB_INDEX] << 8) |
    (unsigned char)osp_input_buffer[OSP_ORM_ANGLE_LSB_INDEX];
  position_control_impulse_period = period == 0 ? 1 : period;
  EEPROM.put(EEPROM_IMPULSE_PERIOD_OFFSET, position_control_impulse_period);
  EEPROM.put(EEPROM_IMPULSE_PERIOD_MAGIC_OFFSET, IMPULSE_PERIOD_EEPROM_MAGIC);
}

void ORM::cmdSetForcePwm(){
  int pwm = (short)(((int)(osp_input_buffer[OSP_ORM_ANGLE_MSB_INDEX]) << 8) | osp_input_buffer[OSP_ORM_ANGLE_LSB_INDEX]);
  if (pwm > 255) {
    pwm = 255;
  } else if (pwm < -255) {
    pwm = -255;
  }
  control_pwm = pwm;
  control_mode = CONTROL_MODE_FORCE_PWM;
}

void ORM::cmdSetPidProportional(){
  int newKp = ((int)(osp_input_buffer[OSP_ORM_ANGLE_MSB_INDEX]) << 8) | osp_input_buffer[OSP_ORM_ANGLE_LSB_INDEX];
  double Kp = (double)newKp / 10000;
  setPidProportional(Kp);
}

void ORM::cmdSetPidIntegral(){
  int newKi = ((int)(osp_input_buffer[OSP_ORM_ANGLE_MSB_INDEX]) << 8) | osp_input_buffer[OSP_ORM_ANGLE_LSB_INDEX];
  double Ki = (double)newKi / 10000;
  setPidIntegral(Ki);
}

void ORM::cmdSetPidDifferential(){
  int newKd = ((int)(osp_input_buffer[OSP_ORM_ANGLE_MSB_INDEX]) << 8) | osp_input_buffer[OSP_ORM_ANGLE_LSB_INDEX];
  double Kd = (double)newKd / 10000;
  setPidDifferential(Kd);
}

void ORM::setPidDifferential(double value) {
  Kd = value;
  //_updateMotorDCTunings();
  //savePidToEeprom();
}

double ORM::getPidDifferential() {
  return Kd;
}

void ORM::setPidIntegral(double value) {
  Ki = value;
  //_updateMotorDCTunings();
  //savePidToEeprom();
}

double ORM::getPidIntegral() {
  return Ki;
}

void ORM::setPidProportional(double value) {
  Kp = value;
  //_updateMotorDCTunings();
  //savePidToEeprom();
}

double ORM::getPidProportional() {
  return Kp;
}

void ORM::saveCalibrationToEeprom() {
  EEPROM.put(EEPROM_ANGLE_CORRECTION_OFFSET, j_angle_correction);
  EEPROM.put(EEPROM_ANGLE_WIDTH_OFFSET, j_angle_width);
  EEPROM.put(EEPROM_DEFAULT_ANGLE_OFFSET, j_angle_desired);
  EEPROM.put(EEPROM_SERVO_ZERO_ANGLE_ADC, servo_zero_angle);
  EEPROM.put(EEPROM_SERVO_MAX_ANGLE_ADC, servo_max_angle);
  EEPROM.put(EEPROM_CALIB_MAGIC_OFFSET, (unsigned short)CALIB_EEPROM_MAGIC);
}

void ORM::saveMotionLimitsToEeprom() {
  EEPROM.put(EEPROM_SPEED_MAX_OFFSET, j_speed_max);
  EEPROM.put(EEPROM_ACCELERATION_OFFSET, j_acceleration);
  EEPROM.put(EEPROM_MOTION_MAGIC_OFFSET, (unsigned short)MOTION_EEPROM_MAGIC);
}

void ORM::saveMinPwmToEeprom() {
  EEPROM.put(EEPROM_MIN_PWM_OFFSET, (short)min_pwm);
  EEPROM.put(EEPROM_PWM_MAGIC_OFFSET, (unsigned short)PWM_EEPROM_MAGIC);
}

void ORM::saveAdcSamplesToEeprom() {
  EEPROM.put(EEPROM_ADC_SAMPLES_N_OFFSET, (short)adc_samples_n);
  EEPROM.put(EEPROM_ADC_SAMPLES_MAGIC_OFFSET, (unsigned short)ADC_SAMPLES_EEPROM_MAGIC);
}

void ORM::ospHandleORACommand(){
  int address = osp_input_buffer[OSP_ORA_ADDRESS_INDEX];

  if (address == current_address){
    int cmd = osp_input_buffer[OSP_MSG_CMD_INDEX];  

    if (cmd == ORA_SET_EFFORT_LOCK) {
      cmdSetEffortLock();
    }
    if (cmd == OSP_ORA_CMD_SET_ANGLE) {
      cmdSetAngle();
    }
    if (cmd == OSP_ORA_CMD_SET_COARSE_ANGLE) {
      cmdSetCoarseAngle();
    }
    if (cmd == OSP_ORA_CMD_SET_CORR_ANGLE) {
      cmdSetCorrAngle();
    }
    if (cmd == OSP_ORA_CMD_SET_ANGLE_WIDTH) {
      cmdSetAngleWidth();
    }
    if (cmd == OSP_ORA_CMD_SET_PID_PROPORTIONAL){
      cmdSetPidProportional();
    }
    if (cmd == OSP_ORA_CMD_SET_PID_INTEGRAL){
      cmdSetPidIntegral();
    }
    if (cmd == OSP_ORA_CMD_SET_PID_DIFFERENTIAL){
      cmdSetPidDifferential();
    }
    if (cmd == OSP_ORA_CMD_SET_FORCE_PWM){
      cmdSetForcePwm();
    }
    if (cmd == OSP_ORA_CMD_SET_MAX_SPEED){
      cmdSetMaxSpeed();
    }
    if (cmd == OSP_ORA_CMD_SET_ACCELERATION){
      cmdSetAcceleration();
    }
    if (cmd == OSP_ORA_CMD_SET_MIN_PWM){
      cmdSetMinPwm();
    }
    if (cmd == OSP_ORA_CMD_SET_ANGLE_DIFF_EPSILON){
      cmdSetAngleDiffEpsilon();
    }
    if (cmd == OSP_ORA_CMD_SET_ANGLE_DIFF_EPSILON_OUTER){
      cmdSetAngleDiffEpsilonOuter();
    }
    if (cmd == OSP_ORA_CMD_SET_POSITION_CONTROL_IMPULSE_TIME_MIN){
      cmdSetPositionControlImpulseTimeMin();
    }
    if (cmd == OSP_ORA_CMD_SET_POSITION_CONTROL_IMPULSE_TIME_MAX){
      cmdSetPositionControlImpulseTimeMax();
    }
    if (cmd == OSP_ORA_CMD_SET_POSITION_CONTROL_IMPULSE_TIME_GAIN){
      cmdSetPositionControlImpulseTimeGain();
    }
    if (cmd == OSP_ORA_CMD_SET_EFFORT_LOCK_TIMEOUT){
      cmdSetEffortLockTimeout();
    }
    if (cmd == OSP_ORA_CMD_SET_EFFORT_LOCK_FORCE_TIMEOUT){
      cmdSetEffortLockForceTimeout();
    }
    if (cmd == OSP_ORA_CMD_SET_POSITION_CONTROL_IMPULSE_PERIOD){
      cmdSetPositionControlImpulsePeriod();
    }
    if (cmd == OSP_ORA_CMD_SET_ADC_SAMPLES_N){
      cmdSetAdcSamplesN();
    }
  } else {
    // Re-transmit command if not addressed to this device
    Serial.write(osp_input_buffer, OSP_COMMAND_LENGTH);
  }
}

void ORM::ospHandleCommand(){
  int dev = osp_input_buffer[OSP_MSG_DEV_INDEX];
  
  if (dev == OSP_DEV_GENERIC) {
    ospHandleGenericCommand();
  } else if (dev == OSP_DEV_CURRENT) {
    if (dev == OSP_DEV_ORA) {
      ospHandleORACommand();
    }
  }
}

void ORM::ospPrepareOutputBuffer(){
  for(int i=0;i<OSP_BUFFER_SIZE;i++) {
    osp_output_buffer[i] = osp_command_template[i];
  }
}

void ORM::oraInfoCurrentAngle(){
  ospPrepareOutputBuffer();
    
  unsigned int angle = j_angle_read;

  osp_output_buffer[OSP_MSG_DEV_INDEX] = OSP_DEV_ORA;
  osp_output_buffer[OSP_MSG_CMD_INDEX] = OSP_ORM_INFO_ANGLE;
  osp_output_buffer[OSP_BYTE_PARAM_INDEX] = current_address;
  osp_output_buffer[OSP_ORM_ANGLE_LSB_INDEX] = angle & 0xFF;
  osp_output_buffer[OSP_ORM_ANGLE_MSB_INDEX] = angle >> 8;
  
  Serial.write(osp_output_buffer, OSP_COMMAND_LENGTH);
}

void ORM::oraInfoCurrentSpeed(){
  ospPrepareOutputBuffer();  
  short int speed = j_speed_current;

  osp_output_buffer[OSP_MSG_DEV_INDEX] = OSP_DEV_ORA;
  osp_output_buffer[OSP_MSG_CMD_INDEX] = OSP_ORM_INFO_SPEED;
  osp_output_buffer[OSP_BYTE_PARAM_INDEX] = current_address;
  osp_output_buffer[OSP_ORM_SPEED_LSB_INDEX] = speed & 0xFF;
  osp_output_buffer[OSP_ORM_SPEED_MSB_INDEX] = speed >> 8;
  
  Serial.write(osp_output_buffer, OSP_COMMAND_LENGTH);
}

void ORM::oraInfoReadSpeed(){
  ospPrepareOutputBuffer();
  short int speed = j_speed_read;

  osp_output_buffer[OSP_MSG_DEV_INDEX] = OSP_DEV_ORA;
  osp_output_buffer[OSP_MSG_CMD_INDEX] = OSP_ORM_INFO_SPEED;
  osp_output_buffer[OSP_BYTE_PARAM_INDEX] = current_address+1;
  osp_output_buffer[OSP_ORM_SPEED_LSB_INDEX] = speed & 0xFF;
  osp_output_buffer[OSP_ORM_SPEED_MSB_INDEX] = speed >> 8;

  Serial.write(osp_output_buffer, OSP_COMMAND_LENGTH);
}

void ORM::sendUpdateInfo(){
  unsigned long current_millis = millis();
  if (current_millis - last_millis > UPDATE_INTERVAL){
    // Stepper Joints Update
    oraInfoCurrentAngle();
    oraInfoCurrentSpeed();
    //oraInfoReadSpeed();
    last_millis = current_millis;
  }
}


short ORM::readAngle(){
  return 0;
}

long isqrt(long x) {
    if (x <= 0)
        return 0;

    long r = x;
    long y = (r + x / r) / 2;

    while (y < r) {
        r = y;
        y = (r + x / r) / 2;
    }

    return r;
}

void ORM::updateActuatorsPosition(){
  unsigned long current_millis = millis();

  // Speed controller state.
  static unsigned long speed_effort_last_change_time = 0;
  static bool speed_effort_has_changed = false;
  static long proportional_speed_control_effort = 0;

  // Effort lock state.
  static unsigned long effort_lock_candidate_start = 0;
  static short effort_lock_target_angle = 0;

  // Position impulse controller state.
  static bool position_control_active = false;
  static bool position_control_impulse_running = false;
  static unsigned long position_control_period_start = 0;
  static unsigned long position_control_impulse_width = 0;
  static unsigned long position_control_impulse_count = 0;
  static int position_control_impulse_effort = 0;

  if (external_effort_lock_enabled && motor_power != 0) {
    // Ignore angle drift while holding the effort captured by the command.
    position_control_active = false;
    position_control_impulse_running = false;
    position_control_impulse_width = 0;
    position_control_impulse_count = 0;
    position_control_impulse_effort = 0;
    if (external_effort_lock_effort > 0) {
      analogWrite(A_ZERO_FWD_PIN, external_effort_lock_effort);
      analogWrite(A_ZERO_BCK_PIN, 0);
    } else {
      analogWrite(A_ZERO_FWD_PIN, 0);
      analogWrite(A_ZERO_BCK_PIN, -external_effort_lock_effort);
    }
    effort_lock_last_effort = external_effort_lock_effort;
    return;
  }

  if (control_mode == CONTROL_MODE_FORCE_PWM) {
    target_angle_stable_iterations = 0;
    proportional_speed_control_effort = 0;
    effort_lock_candidate_active = false;
    effort_locked = false;
    effort_lock_force_active = false;
    effort_lock_forced = false;
    effort_lock_last_effort = control_pwm;
    position_control_active = false;
    position_control_impulse_running = false;
    position_control_impulse_count = 0;

    if (control_pwm > 0) {
      analogWrite(A_ZERO_FWD_PIN, control_pwm);
      analogWrite(A_ZERO_BCK_PIN, 0);
    } else {
      analogWrite(A_ZERO_FWD_PIN, 0);
      analogWrite(A_ZERO_BCK_PIN, -control_pwm);
    }
    return;
  }

  if (motor_power == 0) {
    external_effort_lock_enabled = false;
    // If no motor power - just apply the same angle that is currently read.
    j_angle_current = j_angle_read;
    j_angle_desired = j_angle_read;
    j_speed_current = 0;
    speed_control_effort = 0;
    speed_effort_has_changed = false;
    proportional_speed_control_effort = 0;
    effort_lock_candidate_active = false;
    effort_locked = false;
    effort_lock_force_active = false;
    effort_lock_forced = false;
    effort_lock_last_effort = 0;
    impulse_debt = 0;
    speed_diff_sign_prev = 0;
    target_angle_stable_iterations = 0;
    position_control_active = false;
    position_control_impulse_running = false;
    position_control_impulse_width = 0;
    position_control_impulse_count = 0;
    position_control_impulse_effort = 0;
    analogWrite(A_ZERO_FWD_PIN, 0);
    analogWrite(A_ZERO_BCK_PIN, 0);
    return;
  }

  if (j_angle_force) {
    // If the angle is forced - apply it immediately, no acceleration logic.
    j_angle_current = j_angle_desired;
    j_speed_current = 0;
    speed_control_effort = 0;
    speed_effort_has_changed = false;
    proportional_speed_control_effort = 0;
    effort_lock_candidate_active = false;
    effort_locked = false;
    effort_lock_force_active = false;
    effort_lock_forced = false;
    effort_lock_last_effort = 0;
    impulse_debt = 0;
    speed_diff_sign_prev = 0;
    target_angle_stable_iterations = 0;
    position_control_active = false;
    position_control_impulse_running = false;
    position_control_impulse_width = 0;
    position_control_impulse_count = 0;
    position_control_impulse_effort = 0;
    analogWrite(A_ZERO_FWD_PIN, 0);
    analogWrite(A_ZERO_BCK_PIN, 0);
    return;
  }

  // ---------------------------------------------------------------------------
  // 1. EFFORT LOCK CONTROL
  // ---------------------------------------------------------------------------
  long target_angle_diff = (long)j_angle_desired - (long)j_angle_read;
  long abs_target_angle_diff = abs(target_angle_diff);

  // Both lock timers only count for the current target.
  if (effort_lock_target_angle != j_angle_desired) {
    effort_lock_target_angle = j_angle_desired;
    effort_lock_candidate_active = false;
    effort_lock_force_active = false;
    effort_lock_forced = false;
    effort_locked = false;
  }

  if (effort_locked) {
    if (abs_target_angle_diff >= angle_diff_epsilon_outer) {
      effort_locked = false;
      effort_lock_force_active = false;
      effort_lock_forced = false;
      effort_lock_candidate_active = false;
    } else {
      if (effort_lock_last_effort > 0) {
        analogWrite(A_ZERO_FWD_PIN, effort_lock_last_effort);
        analogWrite(A_ZERO_BCK_PIN, 0);
      } else {
        analogWrite(A_ZERO_FWD_PIN, 0);
        analogWrite(A_ZERO_BCK_PIN, -effort_lock_last_effort);
      }
      return;
    }
  }

  // Start once per attempt; excursions outside either tolerance do not
  // postpone the forced-lock deadline.
  if (!effort_lock_force_active &&
      abs_target_angle_diff <= angle_diff_epsilon) {
    effort_lock_force_active = true;
    effort_lock_force_start = current_millis;
  }

  if (abs_target_angle_diff <= angle_diff_epsilon) {
    if (!effort_lock_candidate_active) {
      effort_lock_candidate_active = true;
      effort_lock_candidate_start = current_millis;
    }
  } else {
    effort_lock_candidate_active = false;
  }

  bool normal_lock_due = effort_lock_candidate_active &&
      current_millis - effort_lock_candidate_start >= effort_lock_timeout;
  bool forced_lock_due = effort_lock_force_active &&
      current_millis - effort_lock_force_start >= effort_lock_force_timeout;

  if (normal_lock_due || forced_lock_due) {
    effort_locked = true;
    effort_lock_forced = forced_lock_due && !normal_lock_due;
    effort_lock_candidate_active = false;
    effort_lock_force_active = false;

    // Do not resume a partially completed impulse when the lock is released.
    position_control_active = false;
    position_control_impulse_running = false;
    position_control_impulse_width = 0;
    position_control_impulse_count = 0;
    position_control_impulse_effort = 0;

    if (effort_lock_last_effort > 0) {
      analogWrite(A_ZERO_FWD_PIN, effort_lock_last_effort);
      analogWrite(A_ZERO_BCK_PIN, 0);
    } else {
      analogWrite(A_ZERO_FWD_PIN, 0);
      analogWrite(A_ZERO_BCK_PIN, -effort_lock_last_effort);
    }
    return;
  }

  // ---------------------------------------------------------------------------
  // 2. ACCUMULATIVE SPEED CONTROL
  // ---------------------------------------------------------------------------
  // Speed/trajectory calculations remain on their original slower update rate.
  if (current_millis - speed_millis >= ORM_SPEED_UPDATE_INTERVAL_MS) {
    speed_millis = current_millis;

    long predicted_current_speed = j_speed_read;
    if (history_records_size > 0) {
      int oldest_history_ptr = 0;
      if (history_records_size >= HISTORY_RECORDS_N) {
        oldest_history_ptr = history_records_ptr;
      }

      long speed_sum = 0;
      for (int i = 0; i < history_records_size; i++) {
        int history_ptr = (oldest_history_ptr + i) % HISTORY_RECORDS_N;
        speed_sum += j_speed_read_history[history_ptr];
      }
      predicted_current_speed = speed_sum / history_records_size;
    }

    long predicted_angle = (long)j_angle_read + predicted_current_speed * (long)ORM_SPEED_PREDICTION_INTERVAL_MS / (long)ORM_MS_IN_SECOND;
    long angle_diff = (long)j_angle_desired - predicted_angle;
    long direction = sgn(angle_diff);
    long predicted_desired_speed = 0;

    if (direction != 0) {
      long accelerate_speed = (long)j_speed_current + direction * (long)j_acceleration * (long)ORM_SPEED_PREDICTION_INTERVAL_MS / (long)ORM_MS_IN_SECOND;
      long abs_angle_diff = angle_diff * direction;
      long sqrt_angle_diff = isqrt(abs_angle_diff);
      long accel_sqrt = isqrt(2L * (long)j_acceleration);
      long deaccelerate_speed = direction * sqrt_angle_diff * accel_sqrt;
      long max_speed = direction * (long)j_speed_max;
      long result_speed = min(min(direction * max_speed, direction * accelerate_speed), direction * deaccelerate_speed);

      predicted_desired_speed = direction * result_speed;
    }

    j_speed_current = predicted_desired_speed;

    long speed_diff = predicted_desired_speed - predicted_current_speed;

    // Inside the epsilon the accumulated effort is intentionally left unchanged.
    if (abs(speed_diff) >= ORM_SPEED_DIFF_EPSILON) {
      bool reaction_time_elapsed = !speed_effort_has_changed ||
        current_millis - speed_effort_last_change_time >= ORM_SPEED_DIFF_REACTION_TIME;

      if (reaction_time_elapsed) {
        long effort_multiplier = max(1L, abs(speed_diff) / ORM_SPEED_EFFORT_DIVISOR);//*max(1L, abs(speed_diff) / ORM_SPEED_EFFORT_DIVISOR);
        int effort_gain = ORM_SPEED_EFFORT_FACTOR * effort_multiplier / 10;

        if (speed_diff > 0) {
          speed_control_effort += effort_gain;
        } else {
          speed_control_effort -= effort_gain;
        }

        speed_control_effort = constrain(speed_control_effort, -MAX_PWM, MAX_PWM);
        speed_effort_last_change_time = current_millis;
        speed_effort_has_changed = true;
      }
    }

    // -------------------------------------------------------------------------
    // 3. PROPORTIONAL SPEED CONTROL
    // -------------------------------------------------------------------------
    if (speed_diff == 0) {
      proportional_speed_control_effort = 0;
    } else {
      long effort_multiplier = min(10L, abs(speed_diff) / ORM_P_SPEED_DIVISOR);
      proportional_speed_control_effort =
        sgn(speed_diff) * (long)ORM_P_SPEED_MAGNITUDE * effort_multiplier;
    }
  }

  // ---------------------------------------------------------------------------
  // 4. IMPULSE POSITION CONTROL
  // ---------------------------------------------------------------------------
  // This section runs every call, rather than only every speed update, because
  // the minimum impulse is only a few milliseconds wide.
  int position_control_effort = 0;
  long position_angle_diff = target_angle_diff;
  long measured_speed = (long)j_speed_read;
  bool actuator_heading_to_target =
    sgn(measured_speed) == sgn(position_angle_diff) &&
    abs(measured_speed) > ORM_SPEED_DIFF_EPSILON / 2;
  bool position_control_required =
    !j_angle_coarse &&
    abs(position_angle_diff) >= angle_diff_epsilon &&
    //abs(position_angle_diff) <= ORM_POSITION_CONTROL_ANGLE_DIFF &&
    !actuator_heading_to_target;

  if (position_control_impulse_running) {
    // Once an impulse has started, use its cached width and cached direction.
    // A sign change cannot reverse it, but sufficient motion toward the target
    // suppresses it immediately.
    unsigned long impulse_elapsed = current_millis - position_control_period_start;

    if (impulse_elapsed < position_control_impulse_width && position_control_required) {
      position_control_effort = position_control_impulse_effort;
    } else {
      position_control_impulse_running = false;
      position_control_effort = 0;

      // Deactivate if any position-control requirement stopped being true.
      if (!position_control_required) {
        position_control_active = false;
      }
    }
  }

  if (!position_control_impulse_running) {
    if (position_control_required) {
      bool start_impulse = false;

      // Entering the position-control range starts an impulse immediately.
      if (!position_control_active) {
        position_control_active = true;
        start_impulse = true;
      } else if (current_millis - position_control_period_start >= position_control_impulse_period) {
        start_impulse = true;
      }

      if (start_impulse) {
        position_control_period_start = current_millis;

        position_control_impulse_width = min(
          position_control_impulse_time_min +
            (unsigned long)position_control_impulse_time_gain * min(position_control_impulse_count, 65535UL),
          (unsigned long)position_control_impulse_time_max
        );

        // Stop advancing the counter after the maximum width is reached.
        if (position_control_impulse_width < position_control_impulse_time_max &&
            position_control_impulse_time_gain > 0 && position_control_impulse_count < 65535UL) {
          position_control_impulse_count++;
        }

        // Cache both magnitude and direction for the whole impulse.
        position_control_impulse_effort = position_angle_diff > 0
          ? ORM_POSITION_CONTROL_IMPULSE_MAGNITUDE
          : -ORM_POSITION_CONTROL_IMPULSE_MAGNITUDE;

        position_control_impulse_running = true;
        position_control_effort = position_control_impulse_effort;
      }
    } else {
      position_control_active = false;
      position_control_impulse_width = 0;
      position_control_impulse_count = 0;
      position_control_impulse_effort = 0;
    }
  }

  // ---------------------------------------------------------------------------
  // 5. CONSOLIDATED EFFORT
  // ---------------------------------------------------------------------------
  speed_control_effort = constrain(speed_control_effort, -MAX_PWM, MAX_PWM);

  long consolidated_effort =
    (long)speed_control_effort +
    proportional_speed_control_effort +
    (long)position_control_effort;
  consolidated_effort = constrain(consolidated_effort, -(long)MAX_PWM, (long)MAX_PWM);

  // Preserve the existing minimum-PWM compensation on the final consolidated
  // effort, rather than applying it independently to each controller.
  int a_zero_effort = (int)consolidated_effort;
  if (a_zero_effort != 0) {
    a_zero_effort = sgn(a_zero_effort) *
      (min_pwm + (long)abs(a_zero_effort) * (long)(MAX_PWM - min_pwm) / (long)MAX_PWM);
  }

  if (a_zero_effort > 0) {
    analogWrite(A_ZERO_FWD_PIN, a_zero_effort);
    analogWrite(A_ZERO_BCK_PIN, 0);
  } else {
    analogWrite(A_ZERO_FWD_PIN, 0);
    analogWrite(A_ZERO_BCK_PIN, -a_zero_effort);
  }
  effort_lock_last_effort = a_zero_effort;
}

void ORM::updateSensorsMeasurements(){
  unsigned long current_sensor_millis = millis();
  int adc_read = analogRead(ORM_J_ADC_PIN);
  int angle_int = orm_max_int_angle * adc_read  / ADC_MAX;
  j_angle_read_samples[j_angle_samples_ptr] = angle_int;
  j_angle_samples_ptr++;
  j_angle_samples_ptr %= adc_samples_n;
  if(j_angle_samples_count<adc_samples_n){
    j_angle_samples_count++;
  }
  long int sum = 0;
  for (int j=0;j<j_angle_samples_count;j++){
    sum += j_angle_read_samples[j];
  }
  int filtered_angle = sum / j_angle_samples_count;
  j_angle_filtered = filtered_angle;

  filtered_angle = (float) j_angle_width * (float)(filtered_angle - servo_zero_angle) / (float)(servo_max_angle-servo_zero_angle);

  filtered_angle = filtered_angle-j_angle_correction;
  j_angle_read = filtered_angle;
  unsigned long elapsed_ms = current_sensor_millis - sensor_millis;
  if(history_records_size>0 && elapsed_ms<SPEED_MEASUREMENT_INTERVAL){
    return;
  }
  if(history_records_size==0){
    j_speed_read = 0;
  } else {
    int history_prev_ptr = history_records_ptr - 1;
    if(history_prev_ptr<0){
      history_prev_ptr = HISTORY_RECORDS_N - 1;
    }
    if(elapsed_ms==0){
      j_speed_read = 0;
    } else {
      long angle_diff = (long)j_angle_read - (long)j_angle_read_history[history_prev_ptr];
      long speed_per_second = angle_diff * (long)ORM_MS_IN_SECOND / (long)elapsed_ms;
      if(speed_per_second>32767L){
        speed_per_second = 32767L;
      } else if(speed_per_second<-32768L){
        speed_per_second = -32768L;
      }
      j_speed_read = speed_per_second;
    }
  }
  sensor_millis = current_sensor_millis;
  j_angle_read_history[history_records_ptr] = j_angle_read;
  j_speed_read_history[history_records_ptr] = j_speed_read;
  history_millis[history_records_ptr] = current_sensor_millis;
  history_records_ptr++;
  history_records_ptr %= HISTORY_RECORDS_N;
  if(history_records_size<HISTORY_RECORDS_N){
    history_records_size++;
  }
  //j_angle_desired = j_angle_read;

}

void ORM::ospSerialLoop(){

  while(Serial.available()){
    char b = Serial.read();
    if(osp_command_template[osp_ptr]==b || osp_command_template[osp_ptr]==0){
      osp_input_buffer[osp_ptr] = b;
      osp_ptr++; 
      if(osp_ptr==OSP_COMMAND_LENGTH){
        ospHandleCommand();
        osp_ptr = 0;
      }
    } else {
      osp_ptr = 0;
    }
    
  }
  updateSensorsMeasurements();
  updateActuatorsPosition();
  sendUpdateInfo();
  /*

  for (int i=0;i<JOINTS_COUNT;i++){
   joints[i]->run();
  }
  */
}

void ORM::setup(){
   // Timer2: fast PWM, prescaler = 1 -> ~31.37 kHz
  //TCCR2B = (TCCR2B & 0b11111000) | 0x05;
  // Timer1: fast PWM, prescaler = 1 -> ~31.37 kHz
  TCCR1B = (TCCR1B & 0b11111000) | 0x01;  // prescaler 1024
  
  Serial.begin(115200);
  Serial.setTimeout(0.01);

  //analogReference(EXTERNAL);

  // Initing the current address
  current_address = 0;
  control_mode = CONTROL_MODE_PID;
  control_pwm = 0;
  speed_control_effort = 0;
  impulse_debt = 0;
  speed_diff_sign_prev = 0;

  // Enable pull-up resistors for address pins
  pinMode(2, INPUT_PULLUP);
  pinMode(3, INPUT_PULLUP);
  pinMode(4, INPUT_PULLUP);
  pinMode(5, INPUT_PULLUP);

  int addr_0 = !digitalRead(2);
  int addr_1 = !digitalRead(3);
  int addr_2 = !digitalRead(4);
  int addr_3 = !digitalRead(5);
  
  current_address = addr_3 << 3 | addr_2 << 2 | addr_1 << 1 | addr_0;

  last_millis = millis();
  speed_millis = millis();

  
  //if (motor_power!=0){
  pinMode(MOTOR_POWER_PIN, OUTPUT);
  digitalWrite(MOTOR_POWER_PIN,LOW);
  //} else {
  //  pinMode(MOTOR_POWER_PIN, OUTPUT);
  //  digitalWrite(MOTOR_POWER_PIN,HIGH);
  //}

// By default - no torque to be applied to PWM
  pinMode(A_ZERO_FWD_PIN, OUTPUT);
  analogWrite(A_ZERO_FWD_PIN, 0);
  pinMode(A_ZERO_BCK_PIN, OUTPUT);
  analogWrite(A_ZERO_BCK_PIN,0);

  pinMode(BTS_L_EN, OUTPUT);
  pinMode(BTS_R_EN, OUTPUT);
  digitalWrite(BTS_L_EN, 1);
  digitalWrite(BTS_R_EN, 1);
  
  /*
  joints[0] = &j0;
  joints[1] = &j1;
  joints[2] = &j2;
  joints[3] = &j3;
  joints[4] = &j4;
  joints[5] = &j5;  
*/

  // Read the current value of the angles
  updateSensorsMeasurements();

  unsigned short calib_magic = 0;
  EEPROM.get(EEPROM_CALIB_MAGIC_OFFSET, calib_magic);
  bool calib_valid = (calib_magic == CALIB_EEPROM_MAGIC);
  unsigned short motion_magic = 0;
  EEPROM.get(EEPROM_MOTION_MAGIC_OFFSET, motion_magic);
  bool motion_valid = (motion_magic == MOTION_EEPROM_MAGIC);
  unsigned short pwm_magic = 0;
  EEPROM.get(EEPROM_PWM_MAGIC_OFFSET, pwm_magic);
  bool pwm_valid = (pwm_magic == PWM_EEPROM_MAGIC);
  unsigned short adc_samples_magic = 0;
  EEPROM.get(EEPROM_ADC_SAMPLES_MAGIC_OFFSET, adc_samples_magic);
  bool adc_samples_valid = (adc_samples_magic == ADC_SAMPLES_EEPROM_MAGIC);

  // Set the desired value of the angle
/*
  joint_servos[0] = &js0;
  joint_servos[1] = &js1;
  joint_servos[2] = &js2;
  joint_servos[3] = &js3;
  joint_servos[4] = &js4;
  joint_servos[5] = &js5;

  gripper_servo = &gripperServo;
  gripper_servo->attach(8);
  gripper_servo->write(0);
*/
  // Initing Joints Servos 
  /*
  for (int i=0;i<JOINTS_COUNT;i++){
    joint_servos[i]->attach(ORM_J_SERVO_PINS[i],500,2500);
    joint_servos[i]->write(0);    
  }
*/
  /*
   // INIT JOINT
   joints->setEnablePin(ORM_J_ENABLE_PIN);
   joints->setPinsInverted(false,false,true);
   //joints->disableOutputs();
   joints->setAcceleration(200000); // 200 steps per second per second
   joints->enableOutputs();
   // Populate desired speed
   j_speed_desired = (long)orm_max_int_angle * (long)500 /(long)orm_j_stepper_full_rot;
   // Set speed in steps/second
   joints->setMaxSpeed((long)j_speed_desired * (long)orm_j_stepper_full_rot / (long)orm_max_int_angle);
   //joints->setSpeed(100);
  */
  // LOAD CORRECTION ANGLE
  if (calib_valid) {
    EEPROM.get(EEPROM_ANGLE_CORRECTION_OFFSET, j_angle_correction);
  } else {
    j_angle_correction = 0;
  }
  j_angle_current = 0;

  if (calib_valid) {
    EEPROM.get(EEPROM_ANGLE_WIDTH_OFFSET,j_angle_width);
  } else {
    j_angle_width = 16384;
  }
  if(j_angle_width<=0) {
    j_angle_width = 16384;
  }

  if (calib_valid) {
    EEPROM.get(EEPROM_DEFAULT_ANGLE_OFFSET,j_angle_desired);
  } else {
    j_angle_desired = 0;
  }

  unsigned short zero_adc = 0;
  unsigned short max_adc = 0;

  if (calib_valid) {
    EEPROM.get(EEPROM_SERVO_ZERO_ANGLE_ADC,zero_adc);
    EEPROM.get(EEPROM_SERVO_MAX_ANGLE_ADC,max_adc);
  }

  if (!calib_valid || zero_adc == 0) {
   zero_adc = default_servo_zero_angle;
  }
  servo_zero_angle = zero_adc;
  if (!calib_valid || max_adc ==0 ) {
   max_adc = default_servo_max_angle;
  }
  servo_max_angle = max_adc;

  j_speed_max = orm_j_speed_max_default;
  j_acceleration = orm_j_acceleration_default;
  if (motion_valid) {
    EEPROM.get(EEPROM_SPEED_MAX_OFFSET, j_speed_max);
    EEPROM.get(EEPROM_ACCELERATION_OFFSET, j_acceleration);
  }
  if (j_speed_max <= 0) {
    j_speed_max = orm_j_speed_max_default;
  }
  if (j_acceleration <= 0) {
    j_acceleration = orm_j_acceleration_default;
  }

  min_pwm = MIN_PWM_DEFAULT;
  if (pwm_valid) {
    short eeprom_min_pwm = 0;
    EEPROM.get(EEPROM_MIN_PWM_OFFSET, eeprom_min_pwm);
    if (eeprom_min_pwm >= 0 && eeprom_min_pwm <= MAX_PWM) {
      min_pwm = eeprom_min_pwm;
    }
  }

  angle_diff_epsilon = ORM_ANGLE_DIFF_EPSILON;
  unsigned short angle_diff_epsilon_magic = 0;
  EEPROM.get(EEPROM_ANGLE_DIFF_EPSILON_MAGIC_OFFSET, angle_diff_epsilon_magic);
  if (angle_diff_epsilon_magic == ANGLE_DIFF_EPSILON_EEPROM_MAGIC) {
    unsigned short saved_value = 0;
    EEPROM.get(EEPROM_ANGLE_DIFF_EPSILON_OFFSET, saved_value);
    if (saved_value > 0) {
      angle_diff_epsilon = saved_value;
    }
  }

  angle_diff_epsilon_outer = ORM_ANGLE_DIFF_EPSILON_OUTER;
  unsigned short angle_diff_epsilon_outer_magic = 0;
  EEPROM.get(EEPROM_ANGLE_DIFF_EPSILON_OUTER_MAGIC_OFFSET, angle_diff_epsilon_outer_magic);
  if (angle_diff_epsilon_outer_magic == ANGLE_DIFF_EPSILON_OUTER_EEPROM_MAGIC) {
    unsigned short saved_value = 0;
    EEPROM.get(EEPROM_ANGLE_DIFF_EPSILON_OUTER_OFFSET, saved_value);
    if (saved_value > 0) {
      angle_diff_epsilon_outer = saved_value;
    }
  }

  position_control_impulse_time_min = ORM_POSITION_CONTROL_IMPULSE_TIME_MIN;
  unsigned short position_control_impulse_time_min_magic = 0;
  EEPROM.get(EEPROM_IMPULSE_TIME_MIN_MAGIC_OFFSET, position_control_impulse_time_min_magic);
  if (position_control_impulse_time_min_magic == IMPULSE_TIME_MIN_EEPROM_MAGIC) {
    unsigned short saved_value = 0;
    EEPROM.get(EEPROM_IMPULSE_TIME_MIN_OFFSET, saved_value);
    if (saved_value > 0) position_control_impulse_time_min = saved_value;
  }

  position_control_impulse_time_max = ORM_POSITION_CONTROL_IMPULSE_TIME_MAX;
  unsigned short position_control_impulse_time_max_magic = 0;
  EEPROM.get(EEPROM_IMPULSE_TIME_MAX_MAGIC_OFFSET, position_control_impulse_time_max_magic);
  if (position_control_impulse_time_max_magic == IMPULSE_TIME_MAX_EEPROM_MAGIC) {
    unsigned short saved_value = 0;
    EEPROM.get(EEPROM_IMPULSE_TIME_MAX_OFFSET, saved_value);
    if (saved_value > 0) position_control_impulse_time_max = saved_value;
  }

  position_control_impulse_time_gain = ORM_POSITION_CONTROL_IMPULSE_TIME_GAIN;
  unsigned short position_control_impulse_time_gain_magic = 0;
  EEPROM.get(EEPROM_IMPULSE_TIME_GAIN_MAGIC_OFFSET, position_control_impulse_time_gain_magic);
  if (position_control_impulse_time_gain_magic == IMPULSE_TIME_GAIN_EEPROM_MAGIC) {
    unsigned short saved_value = 0;
    EEPROM.get(EEPROM_IMPULSE_TIME_GAIN_OFFSET, saved_value);
    position_control_impulse_time_gain = saved_value;
  }

  effort_lock_timeout = ORM_EFFORT_LOCK_TIMEOUT;
  unsigned short effort_lock_timeout_magic = 0;
  EEPROM.get(EEPROM_EFFORT_LOCK_TIMEOUT_MAGIC_OFFSET, effort_lock_timeout_magic);
  if (effort_lock_timeout_magic == EFFORT_LOCK_TIMEOUT_EEPROM_MAGIC) {
    unsigned short saved_value = 0;
    EEPROM.get(EEPROM_EFFORT_LOCK_TIMEOUT_OFFSET, saved_value);
    if (saved_value > 0) effort_lock_timeout = saved_value;
  }

  effort_lock_force_timeout = ORM_EFFORT_LOCK_FORCE_TIMEOUT;
  unsigned short effort_lock_force_timeout_magic = 0;
  EEPROM.get(EEPROM_EFFORT_LOCK_FORCE_TIMEOUT_MAGIC_OFFSET, effort_lock_force_timeout_magic);
  if (effort_lock_force_timeout_magic == EFFORT_LOCK_FORCE_TIMEOUT_EEPROM_MAGIC) {
    unsigned short saved_value = 0;
    EEPROM.get(EEPROM_EFFORT_LOCK_FORCE_TIMEOUT_OFFSET, saved_value);
    if (saved_value > 0) effort_lock_force_timeout = saved_value;
  }

  position_control_impulse_period = ORM_POSITION_CONTROL_IMPULSE_PERIOD;
  unsigned short impulse_period_magic = 0;
  EEPROM.get(EEPROM_IMPULSE_PERIOD_MAGIC_OFFSET, impulse_period_magic);
  if (impulse_period_magic == IMPULSE_PERIOD_EEPROM_MAGIC) {
    unsigned short saved_period = 0;
    EEPROM.get(EEPROM_IMPULSE_PERIOD_OFFSET, saved_period);
    if (saved_period > 0) {
      position_control_impulse_period = saved_period;
    }
  }

  adc_samples_n = ADC_SAMPLES_N_MAX;

  /*
  if (adc_samples_valid) {
    short eeprom_adc_samples = 0;
    EEPROM.get(EEPROM_ADC_SAMPLES_N_OFFSET, eeprom_adc_samples);
    if (eeprom_adc_samples >= 1 && eeprom_adc_samples <= ADC_SAMPLES_N_MAX) {
      adc_samples_n = eeprom_adc_samples;
    }
  }
  */
  // For now setting the desired angle to the one that was read at the start 
  j_angle_desired = j_angle_read;

}

ORM::ORM(){
  
}
