sergei-nntu/ora/src/arduino/sa_psc/orm.h

#ifndef ORM_H
#define ORM_H

#include "osp.h"

#define JS_ANGLE_SCALE_FACTOR_DIVISOR 1024

#define ORM_SPEED_MAX             2000  // 360 * 1000 / 16000 = 22.5 degrees per second 

#define ORM_SPEED_UPDATE_INTERVAL_MS 5   // ms // Good - 5

#define ORM_SPEED_PREDICTION_INTERVAL_MS 100

#define ORM_EFFORT_DELTA_DEFAULT 10 // Last good - 600

#define ORM_SPEED_DIFF_EPSILON_DEFAULT 500 // Last good - 500

#define ORM_SPEED_DIFF_IMPULSE_DEPT_EPSILON 200

#define ORM_TARGET_ANGLE_TOLERANCE 100
#define ORM_TARGET_ANGLE_STABLE_ITERATIONS 10

#define ORM_ACCELERATION_MAX      2000 // 360 * 1000 / 16000 = 22.5 degrees per second^2

#define ORM_DEACCELERATE_ANGLE      1000  

#define ORM_MS_IN_SECOND            1000

// Update Interval in Milliseconds
#define UPDATE_INTERVAL  100 // 10 Hz


//#define ADC_SAMPLES_N_MAX  8
#define ADC_SAMPLES_N_MAX  16

#define HISTORY_RECORDS_N  2

#define MOTOR_POWER_PIN   12

// Define the pins for PID-controlled actuator (Actuator 0)
#define A_ZERO_PWM_PIN 11
#define A_ZERO_FWD_PIN 10
#define A_ZERO_BCK_PIN 9

#define BTS_L_EN 8
#define BTS_R_EN 11

// Convenience sign function
#define sgn(x) ((x) < 0 ? -1 : ((x) > 0 ? 1 : 0))

const long orm_j_encoder_adc_range = 1024; // Max Value of Encoder ADC output


const long orm_max_int_angle = 32768;      // Max Positive Value of Integer Angle correspnods to 2*Pi
                                                 // ORA-3. ORA-4. ORA-3. ORA-2 ORA-2 ORA-2

const long orm_180_angle_width = orm_max_int_angle/2;

const short orm_j_stepper_full_rot = 16000;  // Number of steps to reach 2*Pi Angle

const short orm_j_speed_max_default =     3000;
const short orm_j_speed_min =             400;
const short orm_j_acceleration_default =  250;

const int default_servo_zero_angle = 2700;
const int default_servo_max_angle = 28500;

class ORM {
  private:
    // OSP COMMUNICATION VARIABLES
    char            osp_output_buffer[OSP_BUFFER_SIZE];
    unsigned char   osp_input_buffer[OSP_BUFFER_SIZE];
    int             osp_ptr=0;
    short           current_address;

    unsigned long speed_millis = 0;
    unsigned long sensor_millis = 0;

    double Ki, Kp, Kd; // Pid Coefs

    short j_speed_desired =   500; // Default Speed 11.25 degrees second. Must be populated in the constructor
    short j_speed_current =   0;
    short j_speed_read =      0;
    short j_speed_read_prev = 0;
    short j_speed_max;
    long j_accel_read = 0;
    long j_accel_prev = 0;
    short j_acceleration;
    short j_angle_desired =   0;
    short j_angle_current =   0;
    short j_angle_read =      0;
    short j_angle_read_prev = 0;
    short j_angle_correction =0;
    short j_angle_width =     0;
    char  j_angle_force =     0;
    bool  j_angle_coarse = false;
    short j_callibr_left = 2;
    short js_angle_scale_factor = 1024; // Scale factor to be applied prior to sending the angle to servos
    short js_small_angle_threshold = 1024; // If the difference between the desired and the current angle does not exceed this value - do not apply the acceleration.

    bool effort_lock_candidate_active = false;
    bool effort_locked = false;
    bool external_effort_lock_enabled = false;
    int external_effort_lock_effort = 0;
    int effort_lock_last_effort = 0;
    bool effort_lock_force_active = false;
    bool effort_lock_forced = false;
    unsigned long effort_lock_force_start = 0;

    short servo_zero_angle;
    short servo_max_angle;

    short j_angle_read_samples[ADC_SAMPLES_N_MAX];
    short adc_samples_n = ADC_SAMPLES_N_MAX;
    unsigned short position_control_impulse_period = 75; // ms
    unsigned short position_control_impulse_time_min = 2; // ms; defaults loaded from constants at setup
    unsigned short position_control_impulse_time_max = 20; // ms; defaults loaded from constants at setup
    unsigned short effort_lock_timeout = 300; // ms; defaults loaded from constants at setup
    unsigned short effort_lock_force_timeout = 1000; // ms; defaults loaded from constants at setup
    unsigned short position_control_impulse_time_gain = 2; // ms; defaults loaded from constants at setup
    unsigned short angle_diff_epsilon = 25; // angle units
    unsigned short angle_diff_epsilon_outer = 50; // angle units
    short j_angle_samples_ptr = 0;
    short j_angle_samples_count = 0;
    short j_angle_filtered;


    char motor_power = 1;

    // GRIPPER CONTROL VARIABLES
    short gripper_angle = 0; // INT ANGLE -16384 .. 16383
    //Servo * gripper_servo;

    short j_angle_read_history[HISTORY_RECORDS_N];
    short j_speed_read_history[HISTORY_RECORDS_N];
    unsigned long history_millis[HISTORY_RECORDS_N];
    int history_records_size = 0;
    int history_records_ptr = 0;
    /*
    short j_speed_current[JOINTS_COUNT] = {0,};
    short j_goal_achieved[JOINTS_COUNT] = {16,};  
    */

    // Flow Control Functions
    void            ospHandleCommand();
    void            sendUpdateInfo();   
    void            updateActuatorsPosition(); 
    void            updateSensorsMeasurements();

    // Incoming Command Processing Functions
    void ospHandleORACommand();
    void ospHandleGenericCommand();

    void cmdSetEffortLock();
    void cmdSetAngle();
    void cmdSetCoarseAngle();
    void cmdMakeSteps();
    void cmdSetCorrAngle();
    void cmdSetAngleWidth();
    void cmdSetMotorPower();
    void cmdSetForcePwm();
    void cmdSetMaxSpeed();
    void cmdSetAcceleration();
    void cmdSetMinPwm();
    void cmdSetAdcSamplesN();
    void cmdSetPositionControlImpulsePeriod();
    void cmdSetAngleDiffEpsilon();
    void cmdSetAngleDiffEpsilonOuter();
    void cmdSetPositionControlImpulseTimeMin();
    void cmdSetPositionControlImpulseTimeMax();
    void cmdSetPositionControlImpulseTimeGain();
    void cmdSetEffortLockTimeout();
    void cmdSetEffortLockForceTimeout();

    void cmdSetPidProportional();
    void cmdSetPidIntegral();
    void cmdSetPidDifferential();

    void calibrateJoint(int jointNo);
    void cmdCalibrateJoint();

    // Outcoming Commands Generation Functinos
    void ospPrepareOutputBuffer();
    void oraInfoCurrentAngle();
    void oraInfoCurrentSpeed();
    void oraInfoReadSpeed();
    // Data Input Function
    short readAngle();

    // Service Commands 
    void setPidProportional(double value);
    void setPidIntegral(double value);
    void setPidDifferential(double value);

    double getPidProportional();
    double getPidIntegral();
    double getPidDifferential();

    void saveCalibrationToEeprom();
    void saveMotionLimitsToEeprom();
    void saveMinPwmToEeprom();
    void saveAdcSamplesToEeprom();

    void _updateMotorDCTunings();
    unsigned long last_millis; 
    int control_pwm = 0;
    int speed_control_effort = 0;
    int impulse_debt = 0;
    int speed_diff_sign_prev = 0;
    unsigned char target_angle_stable_iterations = 0;
    int control_mode = 0;
    int min_pwm = 0;

  public:
    // Method to poll the Serial input. Should be called at least once per the execution loop
    ORM();
    void setup();
    void ospSerialLoop();
};

#endif /*ORM_H*/
