sergei-nntu/ora/(commit log)

2023-04-27 Added the initial version of ORA-2 and ORA-3 actuators
    [10_1_1.stl, 10_1_2.stl, 10_2_1.stl, 10_3_1.stl, 10_3_2.stl, 10_4_1.stl, 10_5_1.stl, 10_6_1.stl]
2026-01-14 Commiting the latest changes. Added the source code for actuator control
    [10_1_1.stl, 10_1_2.stl, 10_1_3.stl, 10_2_1.stl, 10_2_2.stl, 10_3_1.stl, 10_3_2.stl, 10_4_1.stl]
2026-01-21 Added ORA-8 files. Added DC motor support to control the actuator using PID controller
    [15_3_3.stl, 15_5_3.stl, 15_6_3.stl, JST-XHP-5S-tuned.stl, JST-XHP-6S-tuned.stl, connector-JST_B2to8B-XH-A.stl, ora-8.FCStd, ora-8_JST.FCStd]
2026-01-21 Added ORA device support. Limited the number of joints to 1.
2026-01-21 ORA: Ring Topology Support. The messages are now re-transmitted if not addressed to the current host
2026-01-21 ORA: Device Type Changes for INFO messages to allow them to pass through intermediary nodes
2026-02-09 EEPROM persistence + ORA control commands
    Persist PID gains and calibration data in EEPROM with magic guards; load defaults when uninitialized.
    Add ORA address-aware PID payload handling and new ORA command support for force PWM in firmware.
    Extend Python OSP API with ORA PID/corr/angle-width setters and force-PWM sender; add missing ORA constants.
    [14_1_10.stl, 14_4_7.stl, 14_5_3.stl, 14_6_3.stl, BT7960B.stl, ora-10_JST.FCStd, ora-7.FCStd, ora-8_JST.FCStd]
2026-02-20 add ORA EEPROM-configurable control params
    [14_1_11.stl, 14_4_8.stl, 14_5_4.stl, 14_6_4.stl, 14_6_5.stl, 14_7_1.stl, ora-7.FCStd]
2026-04-22 Upgraded ORA-7 and ORA-8 to support OSP protocol and rign topology
    [14_1_12.stl, 14_4_10.stl, 14_4_11.stl, 14_4_9.stl, 14_8_1.stl, 14_9_1.stl, 15_3_4.stl, 15_3_6.stl]
2026-08-20 Added documentation. Copied the Arduion ORA control code to introduce the predictive speed control approach (PSC)
    [14_1_12.3mf, 14_4_11.3mf, 14_5_4.3mf, 14_6_5.3mf, 14_9_1.3mf, 15_1_9.3mf, 15_3_6.3mf, 15_5_3.3mf]
2026-08-21 Perform the impulse dept compensation only within +/- 7.5 degrees from target. Introduced the fractional effort correction for more precise contol. Stability improved
    [orm.ino]
2026-08-27 Added 1) URDF configuration of ORM R3 Robotic Arm Geometry 2) ORM R3 Control Library 3) ORM R3 Control HTTP server 4) ORM R3 Control Web UI
    [orm_r3.urdf]
2026-09-11 Reduced the positining angle epsilon from 50 to 25. Increased ADC SAMPLE SIZE
2026-09-15 Introduced force lock mechanism to prevent the angle settle time to exceed ORM_EFFORT_LOCK_FORCE_TIMEOUT = 1000 ms
    [orm.h, orm.ino]
2026-09-15 Added the function to apply the manually inserted coordiantes
2026-09-15 Current angles are shown for the each joint in UI with deltas
2026-09-18 Add automatic fine positioning and configurable OSP timing
    - Add fine-positioning retries based on rolling average joint errors:
    start within 1.5°, finish within 0.1°, space corrections by 500 ms,
    and enforce a 2300 ms minimum retry interval per joint.
    - Add a panel measuring time to the initial tolerance, fine-positioning
    duration, and total positioning time.
    - Poll joint feedback every 50 ms and preserve table buttons across
    refreshes to prevent missed Apply clicks.
    - Add per-joint OSP commands for impulse minimum, maximum, gain,
    and normal/forced effort-lock timeouts.
    - Persist settings in EEPROM while retaining existing defaults.
    - Bound impulse growth and support zero gain.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
    [orm.h, orm.ino, osp.h, osp.py]
2026-09-22 Updated the joint tolerance approach, now it is differnt for j0-j2, and j3-j5
2026-09-22 Returned the restriction on the impulse applying when speed does exceed SPEED_ELSILON/2. Now impulses are only applied when the speed does not exceed it. Added the Lock mechanism in test UI, to stop 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
    [orm.ino]
2026-09-24 Added the condition check, that the actuator number reported from OSP is laying within the expected actuators array range
2026-09-25 Added the effor lock functionality for the repetablity tests. Made the allowed tolerance to be configured per-joint in the scope of the repetability tests
    [orm_r3_control.py, orm_r3_control_server.py]
2026-09-25 URDF is now taking into considration the dampers width
    [orm_r3.urdf]
